Little3gy/VFD-Control-System/media/buck_assembled_PCB_3.jpg

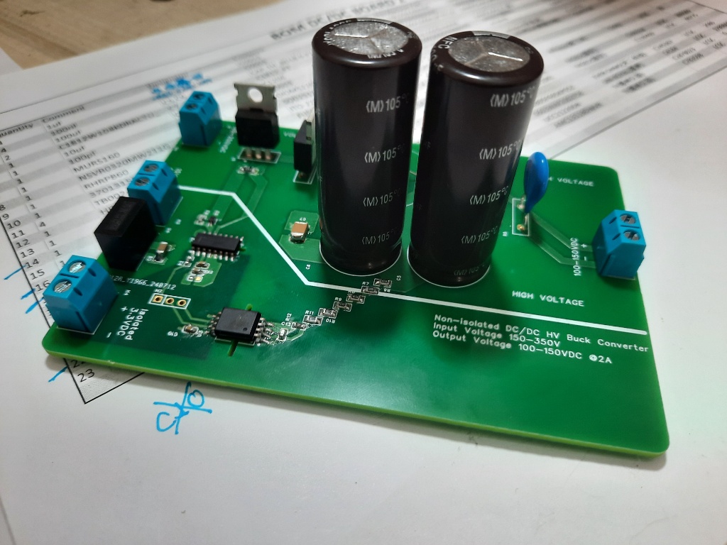
media/buck_assembled_PCB_3.jpg
