Little3gy/VFD-Control-System/media/AC-DC_converter_assembled_PCB.jpg

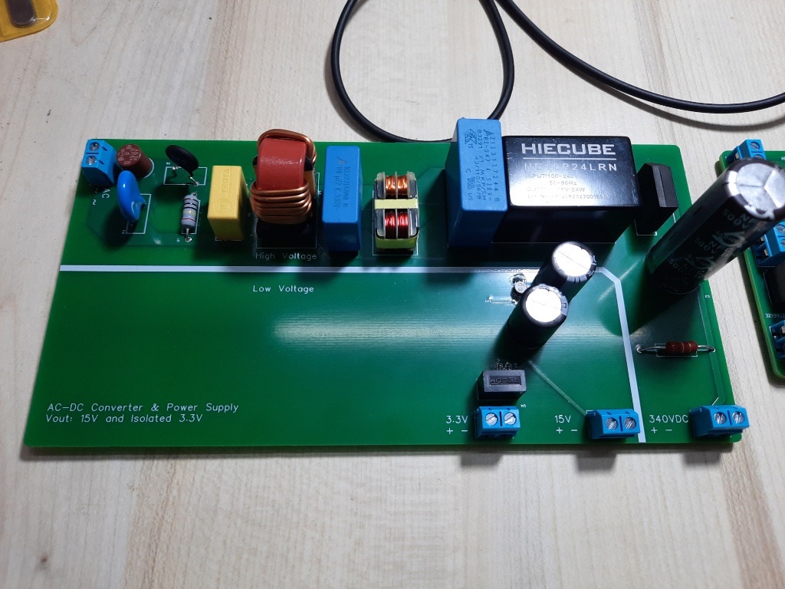
media/AC-DC_converter_assembled_PCB.jpg
