Little3gy/VFD-Control-System/docs/Documentation.docx

Documentation

Friday, 16 February 2024

13:59

Date | Tasks | Notes | summary

16/02/2024 14:06

Research:

Frequency Controller

F Control vs V Control

# Frequency Controller

  - F: cycles per sec
  - Transformer
  - Controlling the frequency, we control the rotational speed of the motor
  - Variable Frequency Drives Explained - VFD Basics IGBT inverter (https://www.youtube.com/watch?v=yEPe7RDtkgo&ab_channel=TheEngineeringMindset)

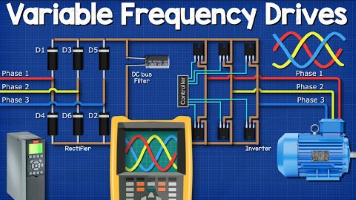
[picture p3: figure]

  - Advantages:
    - Energy Saving
    - Smoother control
  - It can be used to vary the frequency -> thus varying the speed of the motor

## VFD Structure

  - Rectifier: Diodes

In: AC

Output: Rough DC

Ripples, half waves

  - DC bus: Filter (Capacitor)

In: Ripples, rough DC

Out: Smooth DC voltage

  - Inverter: Switches (IGBT)

In: DC

Out: AC current

## How VFD work

  - Rectifier
    - 6 diodes,
    - The current can flow through one phase and return to the source though another; It can do this because the current flows forward and backwards at different points in time.

Current comes in though phase one and can only flow in one direction, which is through diode 1, then it passes through the load and (what does it do next?) It goes back to the source through diode 2. The reason is phase 2 is in its negative half. And so on…

  - Capacitor (storage tank)
    - Smooths the DC output via absorbing and injecting electrons
  - Inverter (DC to AC)
    - IGBT switches that can turn on and off via a PWM controller to generate the desired wave shape (voltage and frequency)

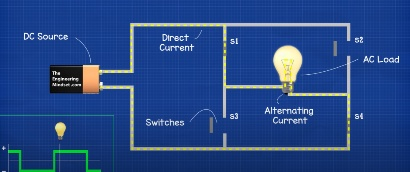
[picture p4: figure]

The direction of current going through some load can be reversed by opening and closing switches in the right order (AC current)

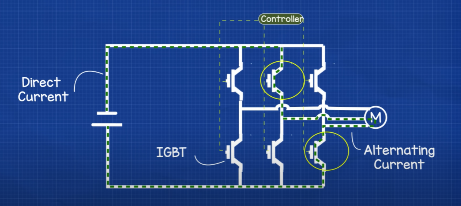
[picture p5: figure]

We can time the switches the generate the right form of wave.

For a 3 phase AC output, The inverter will have 6 switches and by controlling the order and timing,

Closing switches 1 and 6 will direct the current to flow through phase one (postive) and phase two (negative), then opening switch 2 and closing switch 2 will direct the current to go through phase one and phase 3 …

Frequency control

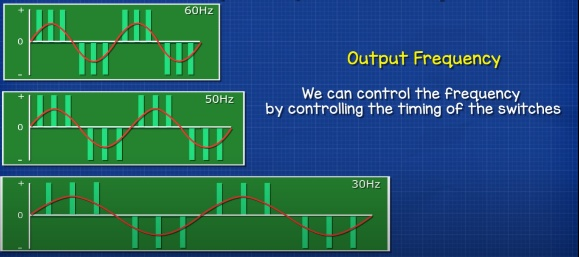
[picture p6: figure]

Voltage control

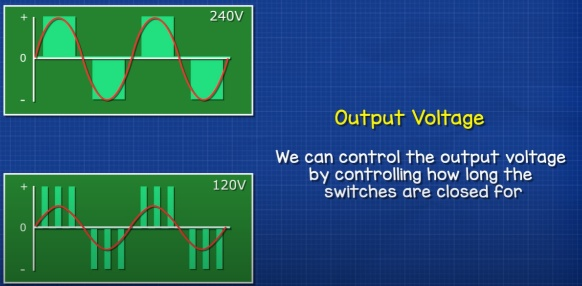
[picture p7: figure]

The output voltage can be controlled

The frequency can also be controlled

# Notes

  - Once you have DC voltage, you can do anything you want with it; Change the voltage, amplitude, frequency

Voltage / Frequency (https://www.youtube.com/watch?v=JzOCCEGe9jU&ab_channel=Chris%27sWorkbench)

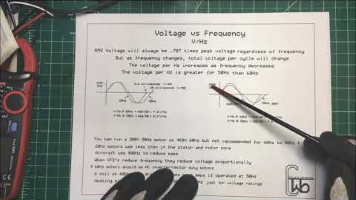
[picture p8: figure]

# Thyristor and Triac

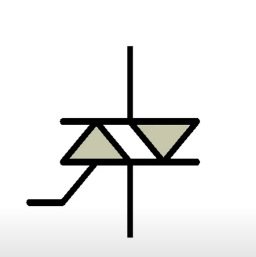
[picture p9: figure]

  - AC power
  - 3 terminals
    - G, MT1, MT2
  - Trigger through the gate, allows current to flow

Electronic Basics #20: Thyristor, Triac || Phase Angle Control (https://www.youtube.com/watch?v=4N1uLth1o9o&ab_channel=GreatScott%21)

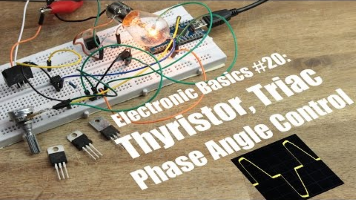
[picture p10: figure]

  - Latching current
  - Turn off time
  - V Drop
  - P lose
  - Zero point indicator
  - Full bridge rectifier with an Auto coupler, in order to create a voltage burst
  - This configuration gets used with feeding elements or to adust the speed of a universal motor
  - Constantly decreasing power factor due to the non-sinusoidal current

# Power factor

Power Factor Explained - The basics what is power factor pf (https://www.youtube.com/watch?v=Tv_7XWf96gg&ab_channel=TheEngineeringMindset)

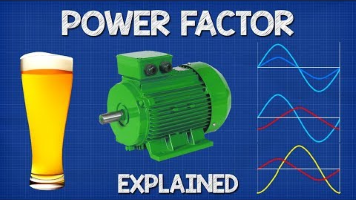
[picture p11: figure]

  - AC
  - Power factor = True power/ Apparent Power
  - KW KVA
  - Bad power factor of the customers
  - Perfect power factor
  - Good, poor, bad
  - KVar
  - Inductive load
  - Lagging power
  - Correcting powr factors, capacitors, inductors,
  - Transformer

17/02/2024 15:07

VFD for single phase

Voltage- frequency curve

VFD control

Electromagnetic vibration control

# VFD for single phase

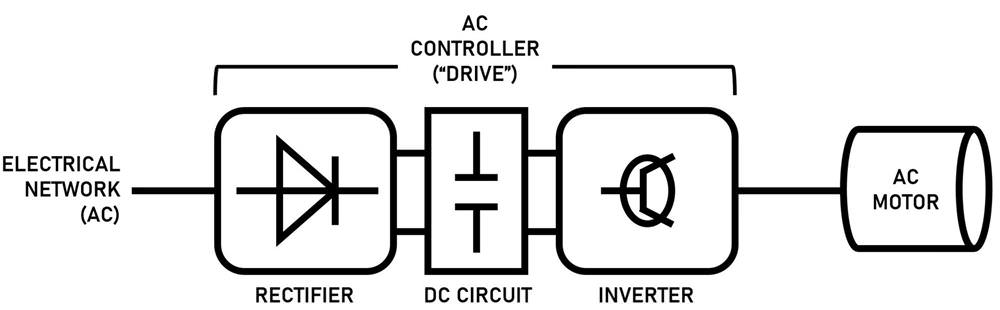
[picture p12: figure]
Inverter Diagram AC Motor Control

# Voltage-Frequency Curve

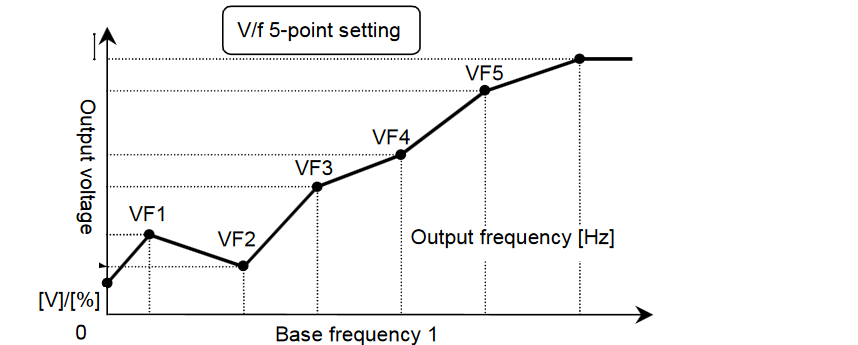
[picture p13: figure]

  - A graphical representation of the relationship between the voltage V and the frequency of the voltage.
  - Control the speed of an induction motor (and feeder).
  - The shape of the curve can be adjusted to suit the needs of the application; For applications that require high torque at low speeds, a steeper slope can be used. While a shallower slope may be used for applications that require high speed at low torque.
  - allows for precise control of the motor speed using a VFD and can help to improve the efficiency and reliability of systems.

# SCR (Silicon Control Rectifier)

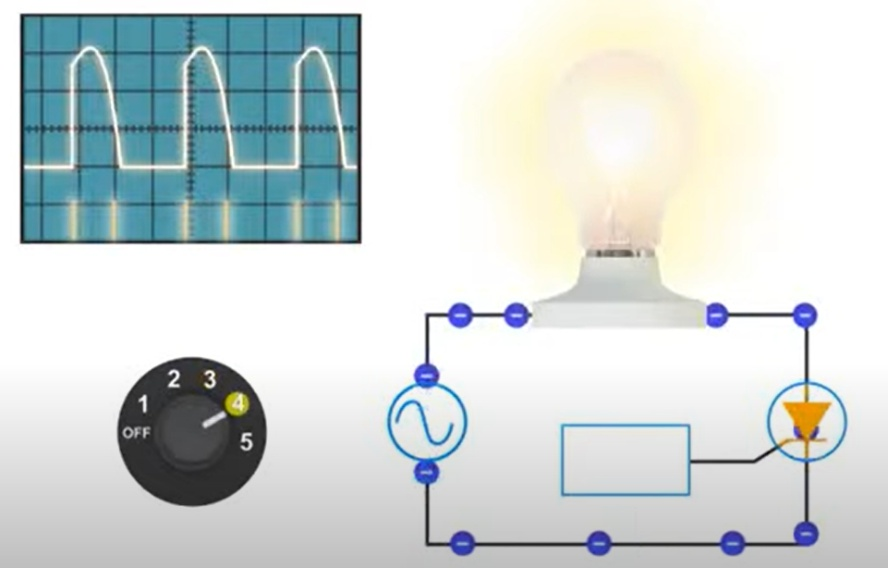
[picture p14: figure]

  - Control the current follow via the gate
  - Diode with Gate Control
  - Dimmer

# Vibrating Feed Control Circuit

Three types of REVF:

  - Sub-resonant mode
  - Resonant mode
  - Super-resonant mod
  - Triac, SRC, and other components were used
  - Generates triangle-shaped current pulses for the electromagnetic actuator.
  - Mechanical resonance
  - switching frequencies.
  - Triangle-shaped wave instead of a perfect siosoidal shape wave

# Triangle-shape wave vs Sinosoidal wave form

Efficiency:

Triangle pulses require lower switching frequency: Compared to sinusoidal pulses, which require high-frequency switching for accurate waveform generation, triangle pulses can be achieved with lower switching frequencies. This reduces switching losses in the power converter, leading to higher overall efficiency.

2. Implementation simplicity:

Easier control and generation: Generating triangle pulses is simpler than generating precise sinusoidal waveforms, especially with lower-cost microcontrollers or control systems. This reduces circuit complexity and potentially lowers component costs.

While sinusoidal pulses might theoretically offer smoother operation and potentially lower vibration noise, the trade-off in efficiency and implementation complexity often makes triangle pulses a more practical choice for industrial applications like REVFs.

Here are some additional points to consider:

The paper mentions that the specific control method employed (pulse width modulation with triangle current pulses) still allows for adjustments of both frequency and amplitude, achieving the desired control over the feeder's operation.

In some REVF applications, minimizing noise or achieving very specific vibration patterns might be crucial, and sinusoidal pulses could be preferred despite the efficiency drawbacks. However, for many industrial feeding tasks, the efficiency gains and implementation simplicity of triangle pulses outweigh the potential benefits of sinusoidal waveforms.

### Applications

  - Used in charging a capacitor

Common ways of generating the output current other than Silicon-controlled rectifier (SCR) converters are:

  - Solid State Relay (SSR) converters: These use transistors or thyristors to switch the power to the heater, but they have a slower switching rate and a higher on/off effect than SCR converters1.
  - Phase Angle Control (PAC) converters: These use triacs or SCRs to vary the phase angle of the input voltage, which results in a smooth and continuous control of the output current2.
  - Pulse Width Modulation (PWM) converters: These use MOSFETs or IGBTs to switch the power to the heater with a high frequency, which results in a low on/off effect and a high efficiency3.

Each of these methods has its own advantages and disadvantages, depending on the application and the requirements of the system. For example, SSR converters are simple and inexpensive, but they have a high power loss and a low accuracy. PAC converters are accurate and reliable, but they generate harmonics and noise. PWM converters are efficient and flexible, but they require complex and expensive circuitry.

Resonance and driving frequency

# Resonance

Resonance in a vibratory feeder is achieved by designing the system such that the natural frequency of the system matches the driving frequency. Here are the key components involved in achieving resonance:

  1. Drive Unit: The drive unit, typically consisting of an electromagnetic coil and a spring system, produces the necessary vibrations to move the parts1 (https://www.generalkinematics.com/vibrating-feeders-for-stockpile-and-reclaim-gk-feeders/).
  2. Controller: The controller regulates the frequency and amplitude of the vibrations, allowing for precise control over the feeding process2 (https://www.rnaautomation.com/insight/designing-an-efficient-vibratory-bowl-feeder-a-comprehensive-guide/).
  3. Elastic Component: The design of the vibratory feeder with electromagnetic excitation is based on a system of two masses coupled by means of an elastic component consisting of flexible leaf composite springs3 (https://pdfs.semanticscholar.org/8547/52240f40e32d3039c60b8af6b6345a16d1e6.pdf). The quantity of leaf springs fitted up determines the resonant operation of the equipment3 (https://pdfs.semanticscholar.org/8547/52240f40e32d3039c60b8af6b6345a16d1e6.pdf).
  4. Tuning: Maximum feed rate can be “fixed” or set by adjusting the small eccentric weights located on the motor or vibrating shaft. Stroke can also be adjusted by the use of tuning springs to vary the resonance effect1 (https://www.generalkinematics.com/vibrating-feeders-for-stockpile-and-reclaim-gk-feeders/).

By carefully selecting and adjusting these components, the system can be made to vibrate at its natural frequency, which is the frequency at which the system tends to oscillate in the absence of any driving or damping force. When the driving frequency matches this natural frequency, resonance is achieved, leading to larger oscillations and more efficient operation of the vibratory feeder.

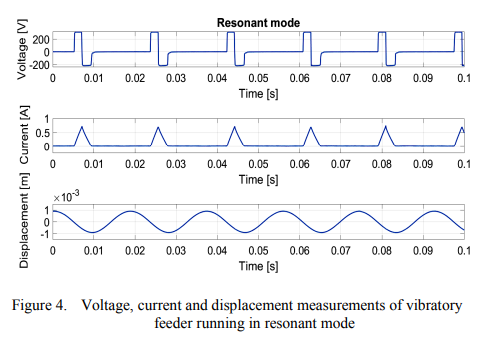
[picture p15: figure]

1. Operating the Electromagnetic Vibratory Feeder (EVF):

  - Operating the EVF at resonance has advantages but it can also be dangerous if not properly controlled.

2. Changing the Speed of the Tray:

  - In an early version, the speed of the tray was changed by increasing the voltage. This means increasing the amplitude of the frequency; the displacement of the armature, without changing the frequency.

3. Efficiency of the System:

  - High current of the electromagnetic coil of the feeder represents a non-efficient system.

4. Achieving Resonance:

  - To achieve resonance, the current pulse was synchronized with the natural frequency of the mechanical system. This resulted in minimal energy consumption and maximum vibration amplitude

The EVF controller has to permit frequency control because it should operate at resonance.

23/02/2024

Circuit analysis:

How to build EVF control circuit?

Why does a square wave can be smoothed out into a triangular wave?

The power converter consists of three power converter:

1. Front end high frequency AC/DC converter with power factor correction (PFC) control, The PFC is not required for the first prototype
2. DC/DC link converter with high frequency duty-cycle control (step-down i.e. “buck” converter) This is an essential step for the project

Active Power Factor Correction (https://www.youtube.com/watch?v=rWfGlo4szyU&ab_channel=MATLAB)

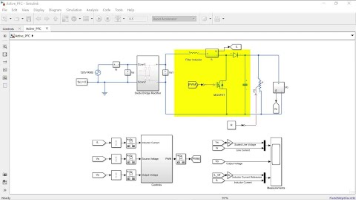
[picture p16: figure]

1. Low frequency IGBT converter with triangle pulsating output current [25] Control is here

# PFC rectifier

Power Factor Correction | Active Power Factor Correction | PFC Control | Boost PFC (https://www.youtube.com/watch?v=KVZVGHwp7B0&ab_channel=FoolishEngineer)

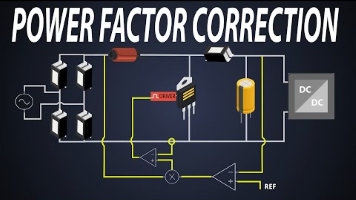
[picture p17: figure]
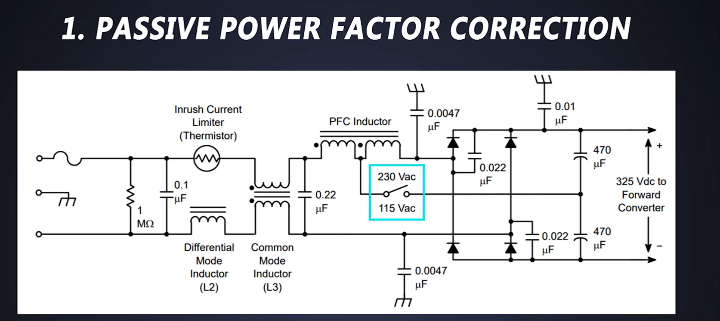
[picture p18: figure]

Power Factor Correction (PFC) – Critical Condu1ction Mode

1. Shaping the Input Current: A PFC rectifier intentionally shapes the input current to be in phase with the instantaneous line voltage
2. Reducing Harmonics
3. Efficiency and Size: The use of PFC allows the manufacturer of electrical load to use smaller components
4. Regulated Output Voltage: It offers a stable regulated output voltage

Why do we need PFC rectifier:

1. current becomes more stable
- Different classes of loads
- Class D is for small Power consumption
- 2 PFC
  - Passive
    - Inefficient
  - Active
    - More common
    - Boost
    - 2 techniques
      - Continuous conduction mode
      - Critical conduction mode -> for low loads

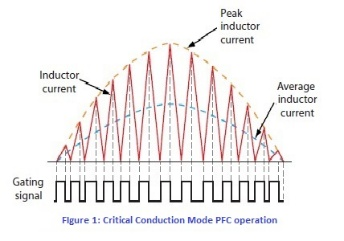
[picture p19: figure]
Power Factor Correction (PFC) – Critical Conduction Mode Boost Converter Calculations using L6562 - Power Electronics Talks

- Even though there might be no phase shift, we can still have low power factor.

# DC/DC link - capacitors

A closer look at the DC Link (https_chargedevs.com)

- Junction between two power conversion
- It also smooths the pulses out into more of a triangle or sawtooth shape
- Electrolytic capacitor
- How to Smooth a Rectified Waveform Using Capacitors (https://www.youtube.com/watch?v=hEXQXvPH8EI&ab_channel=JoeRobinsonTraining)

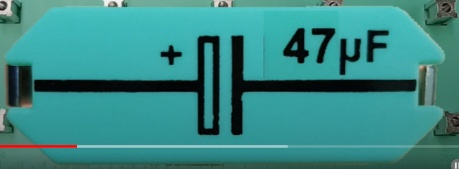
[picture p20: figure]

- larger values of capacitors can produce smoother filtering

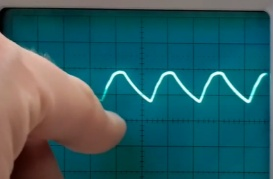
[picture p21: figure]
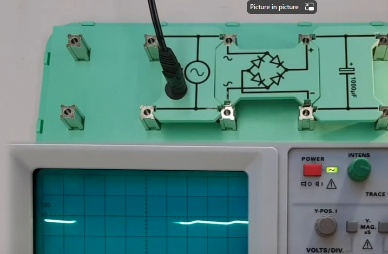
[picture p22: figure]

- The biggest capacitor gave an even smoother wave (when we say the biggest, do we mean the in size or in capacitance?)
- Bigger capacitor also results in a brighter lamp
- Capacitor is similar to a water storage tank
- Capacitors Explained - The basics how capacitors work working principle (https://www.youtube.com/watch?v=X4EUwTwZ110&ab_channel=TheEngineeringMindset)

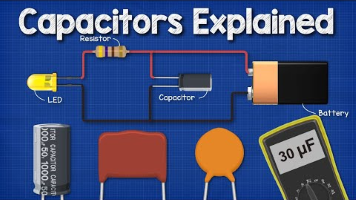
[picture p23: figure]

- Voltage difference is the difference between the pressure of two points

When do we use capacitors? lol

- Power factor correction
- Rectifiers

If we have a square wave voltage input, what would be our current, is it a square wave as well? - Quora (https://www.quora.com/If-we-have-a-square-wave-voltage-input-what-would-be-our-current-is-it-a-square-wave-as-well)

- If we have a square wave voltage input, what would our current output look like, A square wave too?
  - What would the current look like if it's pure resistance?

It follows the shape of the input

- What would it look like if it's pure induction?
  - Triangle
- What would it look like if it's pure capacitance? Infinite for a fraction of a second then zero afterwards
- The capacitor has to have a voltage rating greater than the power source

# Opto-isolated

- Aka Optocoupler
- Used with MCU for protection
- Protects from voltage spikes

28/02/2024

How build a rectifier

What safe volage to work with

What values of components to choose

What load

How build a Buck Converters

How build a Boost Converter

How build a Flyback converter

How build a Combines boost and buck converters

Low frequency IGBT converters

How2Power.com - Answering Your Questions About Power Design: : Electronics Design Services : Voltage Regulator : Industrial Power Supplies : Semiconductors : Transformer : IGBT Module : Software : Digital Power Supply DC (https://www.how2power.com/pdf_view.php)

How To Choose The Right Rectifier & Capacitor For Rectifing AC to DC (https://www.youtube.com/watch?v=CAYKno16weE&ab_channel=Schematix)

What Resistor Do I Need For an LED | DigiKey Electronics (https://www.digikey.com/en/blog/atm-how-to-select-a-resistor-for-an-led)

Power-supply filtering

- Ripples
- Ripple factor
- Capacitors
- Diodes

Forward continuous current

Repetitive current

Reverse current

How To Choose The Right Rectifier & Capacitor For Rectifing AC to DC (https://www.youtube.com/watch?v=CAYKno16weE&ab_channel=Schematix)

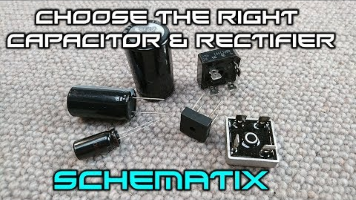
[picture p24: figure]

# The right Diode

- We need to look at the
  - reverse voltage Vrms
- 20%-30% headroom recommended
- Voltage drop: less power at the output
- Calculate the heat dissipation through a diode

# The Right Capacitor

- We need to look at:

Voltage: The voltage cannot > the power source

- 20-30% headroom recommended

Capacitance:

Based on:

- the current we are going to be drawing from the power source
- The frequency
- The acceptable voltage drop

Ex. Assuming 50Hz AC => half cycle time = (1/50)/2=0.01

- Capacitance: High-frequency applications call for smaller capacitance values, whereas energy storage and filtering applications benefit from larger capacitance values.
- Voltage rating (volts): Higher voltage rating.
- Most capacitors are polarity sensitive

The Right resistor with an LED using ohm's law

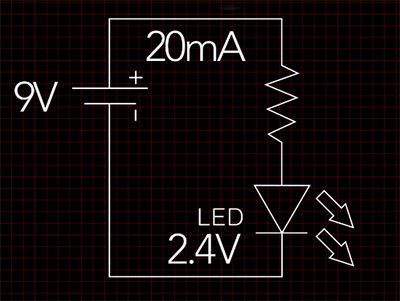
[picture p25: figure]

In this case V circuit is the led voltage. You should also account for other components.

# Active rectifier

The End of the Full Bridge Rectifier? (Sorry ElectroBOOM) Active Rectifier is here! (https://www.youtube.com/watch?v=S0j4xOuRzD4&ab_channel=GreatScott%21)

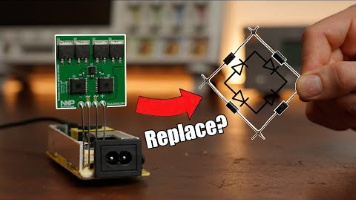
[picture p26: figure]

Full Wave Active Bridge Rectifier Controller

TEA2208T (https://www.nxp.com/products/power-management/ac-dc-solutions/ac-dc-controllers/full-wave-active-bridge-rectifier-controller:TEA2208T)

Tea2206

# Notes

- You can buy a rectifier
- Bleeder resistor: high value resistor in parallel with the load

Ee13 Ee16 Ee19 Electrical Powewr 230V 12V AC Flyback Transformer Manufacturer - China Flyback Transformer and Ee13 Ee16 Ee19 Transformer (made-in-china.com) (https://okerda.en.made-in-china.com/product/dOlfHBXSSRVD/China-Ee13-Ee16-Ee19-Electrical-Power-230V-12V-AC-Flyback-Transformer-Manufacturer.html)

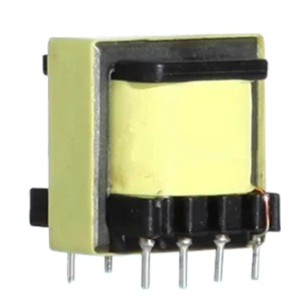
[picture p27: figure]

EEVBlog #1116 - How to Remove Power Supply Ripple (https://www.youtube.com/watch?v=wopmEyZKnYo)

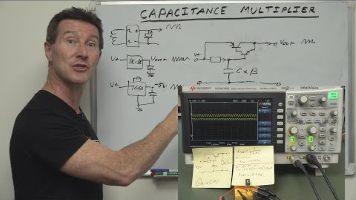
[picture p28: figure]

01/03/2024

How build a Buck Converters

Which is more efficient rectificaion then step dowm or the reverse

# Buck Converters

Basic Calculation of a Buck Converter's Power Stage (Rev. B) (https://www.ti.com/lit/an/slva477b/slva477b.pdf?ts=1709597991557)

Switching Buck Converter Component Sizing | Phil's Lab | Altium (https://resources.altium.com/p/buck-converter-component-sizing)

Is this the BEST Voltage Converter? Trying to build a Synchronous Converter! (https://www.youtube.com/watch?v=W4i2FRZ8gXc&ab_channel=GreatScott%21)

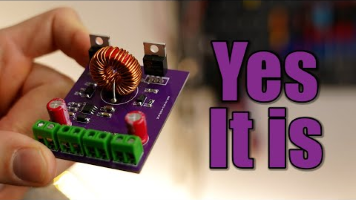
[picture p29: figure]

Half bridge driver ??

SMPS

High frequency XL6009 (https://pdf1.alldatasheet.com/datasheet-pdf/view/1132228/XLSEMI/XL6009.html) >>

- capacitor: smoothing
- Inductor: amp?
- Schokky diode
- Built in MOSFET
- Fixed frequency

# Voltage divider

Lm2576 KC Package

LM2576xx Series SIMPLE SWITCHER Power Converter 3-A Step-Down Voltage Regulator datasheet (Rev. G) (ti.com) (https://www.ti.com/lit/ds/symlink/lm2576.pdf?ts=1709519290029)

LM2576T-ADJG onsemi | Mouser Vietnam (https://www.mouser.vn/ProductDetail/onsemi/LM2576T-ADJG?qs=2OtswVQKCOHU65i1eWvgeQ%3D%3D)

# The Right MOSFET

- N type
- 10kohm pull down between source and gate to prevent accidental activation
- Linear region where the resistance is almost constant
- Source to ground

# MOSFET DRIVERS

LM2576xx Series SIMPLE SWITCHER Power Converter 3-A Step-Down Voltage Regulator datasheet (Rev. G) (ti.com) (https://www.ti.com/lit/ds/symlink/lm2576.pdf?ts=1709519290029)

IR2110 pdf, IR2110 Description, IR2110 Datasheet, IR2110 view ::: ALLDATASHEET ::: (https://pdf1.alldatasheet.com/datasheet-pdf/view/82793/IRF/IR2110.html)

IR2184 pdf, IR2184 Description, IR2184 Datasheet, IR2184 view ::: ALLDATASHEET ::: (https://pdf1.alldatasheet.com/datasheet-pdf/view/82795/IRF/IR2184.html)

*91045.pdf (vishay.com) (https://www.vishay.com/docs/91045/91045.pdf)

Why do we need a driver?

- Because the MOSFET has parasitic capacitance that require current to charge up. This currrent output exceeds the current of the microcontroller
- Current charges and discharges the gate during activation
- We need a powerful current source to charge up the gate faster, thus MOSFET ON

# Current Ripple

# Switching Regulators

- Converts input voltage into higher or lower voltage
- Inductors are used to store energy temporarity

How to Calculate and Design Buck Converter using MATLAB Simulink (https://www.youtube.com/watch?v=ZWs2HJZTWAA&ab_channel=MYCREATIVEENGINEERING)

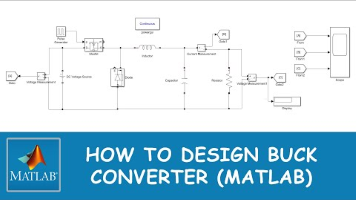
[picture p30: figure]
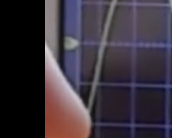
[picture p31: figure]

| Using Oscilloscope | Zero point Trigger button is there the oscilloscope starts measuring 50% button sets the trigger to 50% of the signal

PWM Generation

Using MOSFETs

# Creating a project

- Activate the pins
- Choose crystial

# Toggling an LED

HAL_GPIO_WritePin(GPIOC, GPIO_PIN_13, 1);

HAL_Delay(2000);

HAL_GPIO_WritePin(GPIOC, GPIO_PIN_13, 0);

HAL_Delay(2000);

# Generating PWM

PWM (Pulse Width Modulation) in STM32 (controllerstech.com) (https://controllerstech.com/pwm-in-stm32/)

1. Activate timer and configure clock speed
2. set the PWM Frequency and duty cycle using the following formulas

1. Set prescaler

Ex. 100 MHz → 100 kHz

2. Set ARR Value =

Ex. Desired PWM = 100KHz, Timer Frequency = 1MHz

-> ARR = 20-1

3. Choose duty cycle

TIM1->CCR1 = 30;

HAL_TIM_PWM_Start(&htim1, TIM_CHANNEL_1);

# STM32 Blue Pill Note

Solved: Did I "brick" my "blue pill" board(s) - ST-LINK V2... - STMicroelectronics Community (https://community.st.com/t5/stm32-mcus-products/did-i-quot-brick-quot-my-quot-blue-pill-quot-board-s-st-link-v2/td-p/72470)

The STM32 Blue Pill requires

1. Boot 0

# Notes

- Explore clock configuration

MOSFETs

Why a pull up resistor?

Electrical characteristics of MOSFETs (Static Characteristics IGSS/IDSS/V(BR)DSS/V(BR)DXS) | Toshiba Electronic Devices & Storage Corporation | Asia-English (semicon-storage.com) (https://toshiba.semicon-storage.com/ap-en/semiconductor/knowledge/faq/mosfet/electrical-characteristics-of-mosfets_static-characteristics_igss_idss_v-br-dss-v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)

MOSFETs Parameters:

- P type and N type
- Source to gate capacitance
- Inter

Drive the gate with a 10v to drive it fully on

# P Channel MOSFETs

- Activates when Negative Voltage applied to the gate relative to the source
- In this type of MOSFETs, the source is connected to VCC, The drain is connected to the ground, To activate it (-) voltage needs to applied to gate relative to the source
- So the voltage applied to the gate needs to be negative compared to the source
- In the case where the mosfet is closer to the load than the ground, the negative voltage applied to the gate has to be negative enough because the mosfet is close to Vcc, so it's already experiencing so the activation voltage is low

Mosfets, Enhancement-Type require a certain voltage value to activate.

- (relative to the Ground)

P-Channel MOSFET and Arduino. Switching a 12V Motor. - Circuit Journal (https://circuitjournal.com/how-to-use-a-p-channel-mosfet-with-an-arduino)

To activate the MOSFET with a U, the if

Type P: High output turns the mosfet OFF

Type N: Low output turns the mosfet OFF

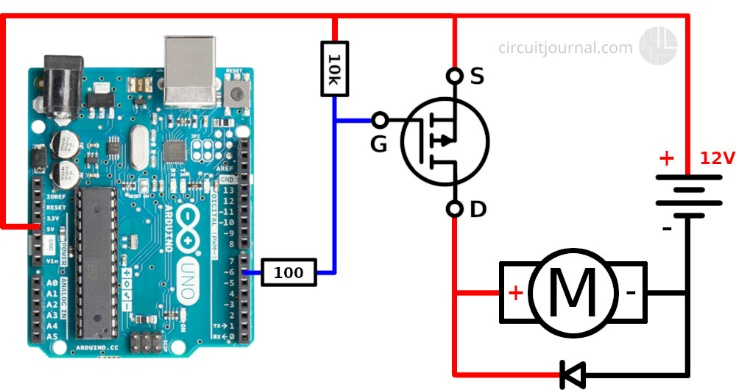
[picture p32: figure]
P-Channel MOSFET connection diagram. Connected on the VCC side.
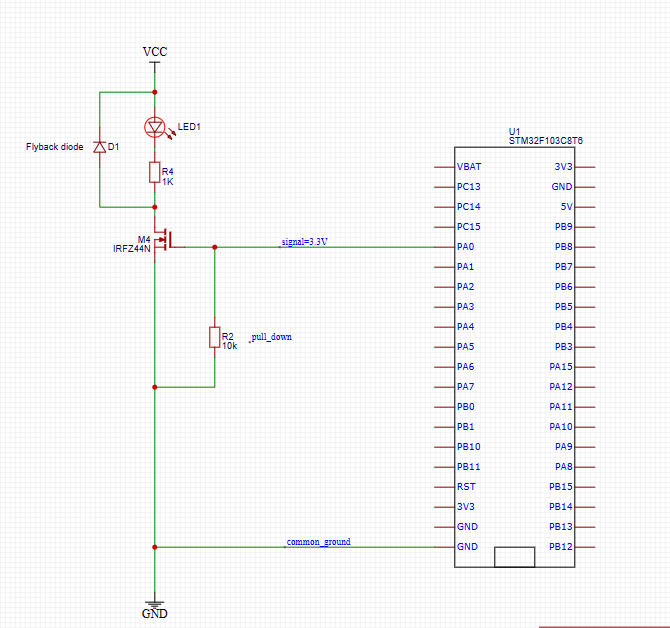
[picture p33: figure]

LOGIC LEVEL GATE DRIVE

The selected mosfet

Important convepts

- TYPE
  - LOGIC MOSFETS VS no-logic mosfets vs insulated

IRFZ44N VS IRLZ44N vs IRLI244N

P channel have higher resistance than N channel

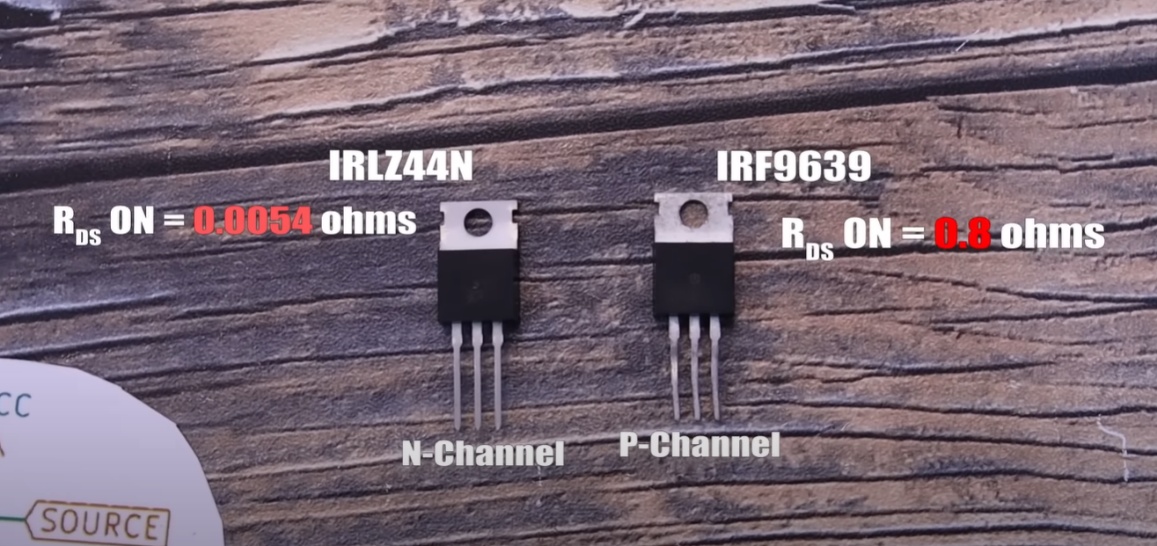
[picture p34: figure]

- DRIVER
- LOGIC LEVEL
- POWER DISSIPATION
- BOOTSTAP

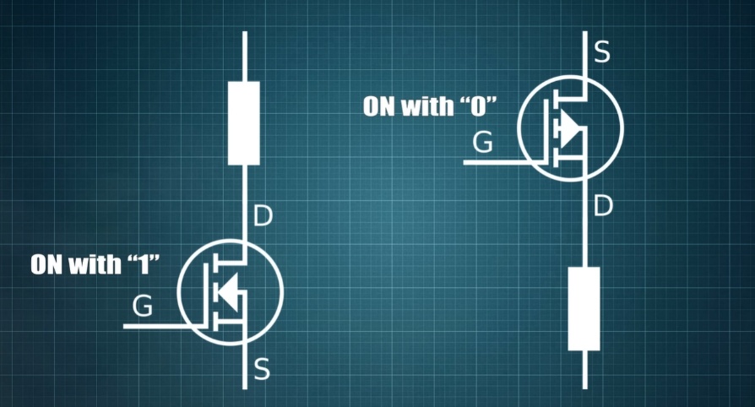
[picture p35: figure]

# Mistakes

- Capacitor polarity x2

11/03/2024

Week 5 probation

20 days left

How does bootsrapping work?

How to implement it?

What are it's parameters?

Bootstrapping

Half bridge

H bridge driving for generating a sine wave

How to determine the values of the components?

If my signal is 3.3V will ir2110 work properly?

MOSFET Bootstrapping (https://www.youtube.com/watch?v=zcQV_ZpK1W8&ab_channel=0033mer)

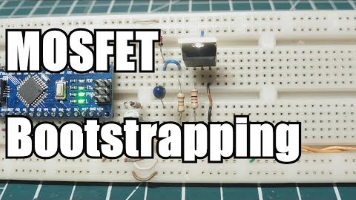
[picture p36: figure]

EasyEDA(Standard) - A Simple and Powerful Electronic Circuit Design Tool (https://easyeda.com/editor)

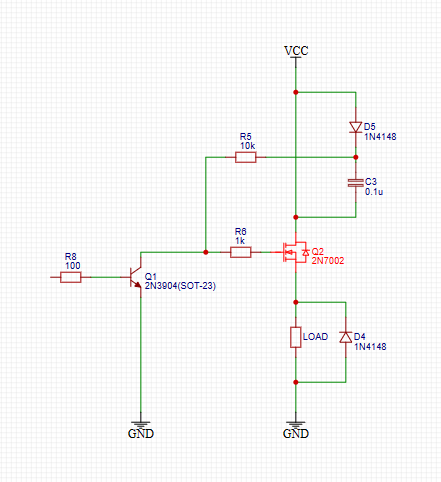
[picture p37: figure]
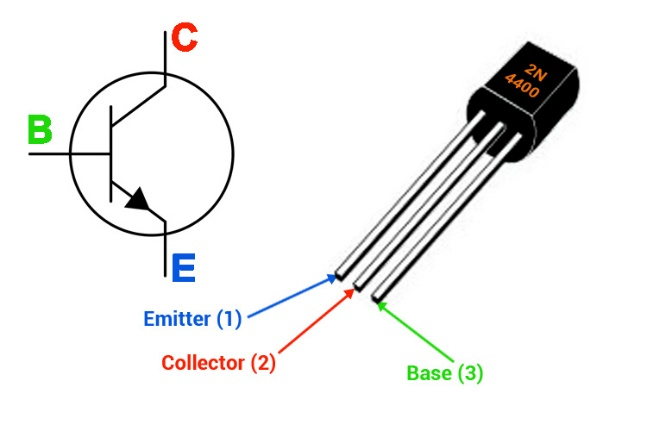
[picture p38: figure]
2N4400 Transistor Pinout, Datasheet, Equivalent, Circuit, and Specs

Is it safe to connect VCC and GND of the controller to the driver VCC?

How to use MOSFET/IGBT DRIVER IR2110 (https_microcontrollerslab.com)

  - IR2110 can drive both low side and high side in half bridge and low bridge circuits

Miller effect

Many Driver configurations. Most common is totem pole output; low input impedance and high drive current

TOTEM POLE OUTPUT USE AND APPLICATIONS (http://microcontrollerslab.com/totem-pole-tutorial/)

Floating circuit to drive high side MOSFET. H-bridge used to in pure sine wave inverter

IR2110 can be used to generate a pure sinewave

  - Can drive up to 500V (offset voltage)
  - 2 A of current
  - Floating point

### What's offset voltage?

Pinout

LO | Output pin for a low side gate driver
2 | COM | return path for low side configuration
3 | VCC | power supply pin for low side
5 | VS | floating-point return path for high side drive
6 | VB | floating supply for high side drive
7 | HO | output signal for high side mosfet
9 | VDD | Power supply +5V
10 | HIN | PWM signal input for high side
11 | SD | shutdown pin to turn off system automatically
12 | LIN | PWM signal input for low side
13 | VSS | Power supply ground

  - VDD pin 9 is a logical supply pin. Its value should be around 5 volts. But if you used voltage less than 4 volts it may not give you the required result.

Schematic of an

ir2110 typical circuit - Search Images (bing.com) (https://www.bing.com/images/search?view=detailV2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)

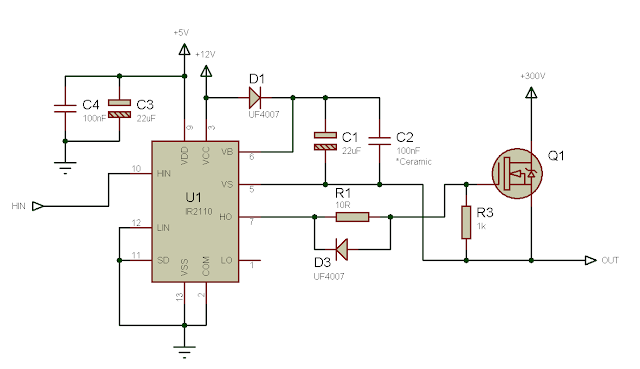
[picture p39: figure]

# Notes

Selection of bootstrap components

*an978.p65 (mit.edu) (https://web.mit.edu/6.131/www/document/float_drive.pdf)

*dt98-2.pdf (irf.com) (https://www.irf.com/technical-info/designtp/dt98-2.pdf)

Simulation Result

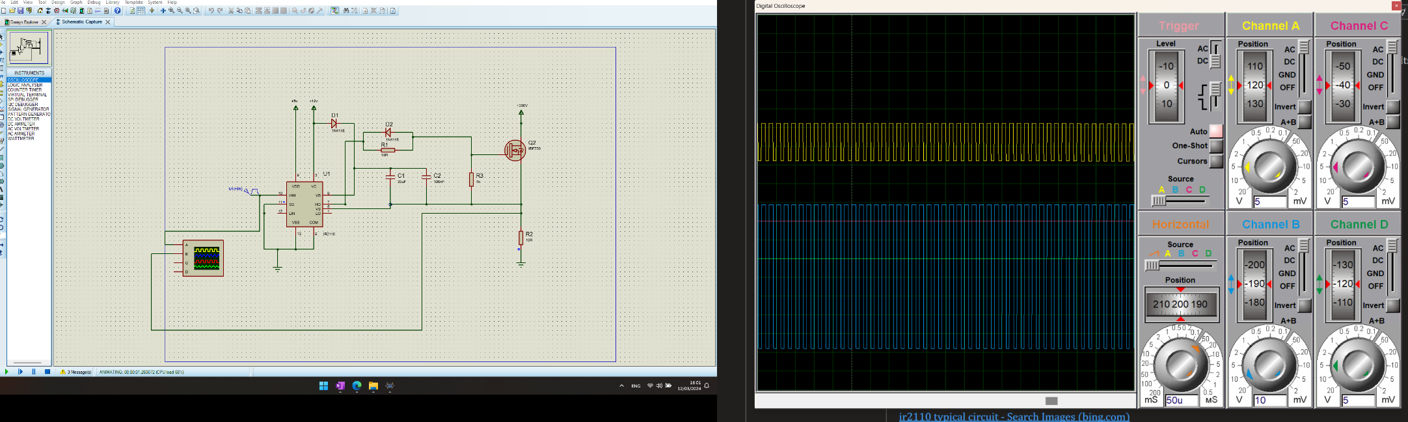
[picture p40: figure]

The amplifier npn mosfet doesn't work properly for a mysterious reason.

There's current flowing through it even without applying current to the base/

# Using a potentiameter to control pwm signal

while(dutyCycle < 65535) { TIM2->CCR1 = dutyCycle; dutyCycle += 100; HAL_Delay(1); } while(dutyCycle > 0) { TIM2->CCR1 = dutyCycle; dutyCycle -= 100; HAL_Delay(1); }

HAL_ADC_PollForConversion(&hadc1,1000);

readValue = HAL_ADC_GetValue(&hadc1);

TIM1->CCR1 = (int)(readValue*100/4095);

Potentiometer ADC (micropeta.com) (https://www.micropeta.com/video16)

STM32 Blue Pill Timer PWM Mode with LED Dimmer Example (microcontrollerslab.com) (https://microcontrollerslab.com/stm32-blue-pill-timer-pwm-mode-stm32cube-ide/)

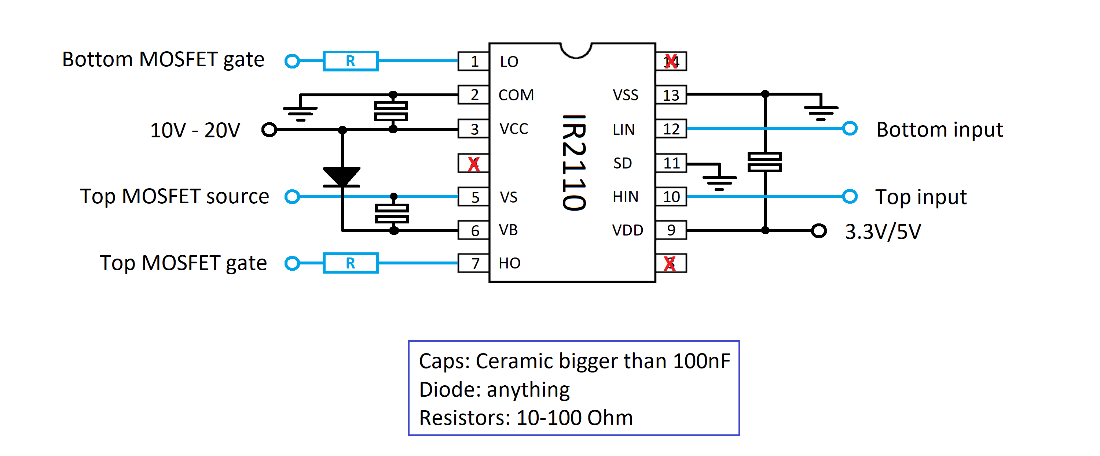
[picture p41: figure]

How to use the IR2110 gate driver – Krakkus.com (https://krakkus.com/2023/01/16/how-to-use-the-ir2110-mosfet-gate-driver/)

What are MOSFET gate drivers? Why do we need MOSFET gate driver? MOSFET driver explained. (https://www.youtube.com/watch?v=DXyTHhUjxjk&list=PLbGlpmZLQWJceSkQv96j-L4YyuxS-E0Wm&ab_channel=FoolishEngineer)

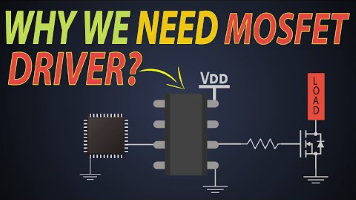
[picture p42: figure]

Why gate driver circuit?

  - Logic MOSFET driving a power MOSFET
  - A negative pulse to turn off a MOSFET

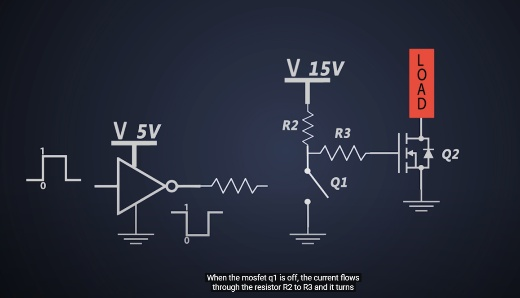
[picture p43: figure]

  - NOT at the GATE
  - Low switching speed, high switching loss
  - Inductance coupled with capacitance => Generate ringing, which could damage the gate driver

# Gate driver IC

  - No ringing
  - High gate capacitance
  - Low voltage compatibility
  - Transient protection
  - Isolation

# Resistor to drive the MOSFET

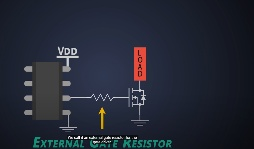
[picture p44: figure]

External gate resistors

## Why the right size of gate driver resistor is so important?

The gate resistors affect the following:

  - Swiching speed
  - Power dissipation
  - Power losses
  - Voltage Overshoot
  - Gate Ringing
  - Electromagnetic interference
  - Reverse recovery
  - Tradeoff between noise and efficiency
  - Resistor should be placed next the MOSFET gate

# Totem Pole

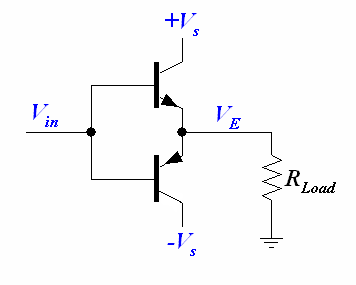
[picture p45: figure]
enter image description here

  - Requirements?

Floating circuit

Bootstrap

VCC and VDD

Totem Pole

H-bridge

# APPLICATION NOTE (https://web.mit.edu/6.131/www/document/float_drive.pdf)

Adjusting the signal so that it would reach the required gate voltage; When a driver IC is missing, the signal would need to be amplified using a transistor

# Floating Power Supply

In a floating Power supply the output is isolated from the input, including not sharing a common ground connection.

  1. Isolation
    - The output is not referenced to any ground or other power supplies
    - It allows the power supply to be used independently without relying on existing circuit ground connections.
  2. Application
    - Flexible grounding
    - Noise reduction

# VDD and VCC

  1. VCC: powers circuit
  2. VDD: powers logic gates, transistors and MOSFETs
  3. VCC is the power supply voltage of the circuit, VDD is the working voltage of the chip
  4. VSS is the ground point.

Some ICs have both VDD and VCC pins, which means that the device itself has a voltage conversion function.

# Gate Floating

The gate current is specifically related to controlling the MOSFET’s gate voltage, while the drain-source current is associated with its overall conduction behavior. 🛠️⚡

Floating the gate above the source

Input to high side MOSFETs has to be level shifter to whatever potential the tub is floating at

Floating the gate: gate voltage is controlled relative to the source volt at a given instance

# Driver Requirements

  1. Gate Reqirements:
    - Gate voltage must be 10-20 V above the source voltage
    - The gate voltage must exceed the rail voltage
    - Gate voltage must be referenced to ground which has to be referenced to GND
  2. Level shifting
    - The logic signal coming from the controller needs to be level shifted to the level of the source terminal of the HS switching transistor
    - In most applications, this source terminal swings between the two rails (high voltage and ground)

components operate at different levels

  5. For example, logic circuits (such as microcontrollers or digital ICs) typically work with low voltages (e.g., 3.3V or 5V), while power devices (such as MOSFETs or IGBTs) may operate at much higher voltages (e.g., 12V, 24V, or even hundreds of volts).

# Level Shifting

When we say that a signal is **"level-shifted,"** we are referring to the process of adjusting its voltage level or reference point. Let me explain further:

1. **Context**:

- In electronic circuits, different components or subsystems often operate at different voltage levels.

- For example, logic circuits (such as microcontrollers or digital ICs) typically work with low voltages (e.g., 3.3V or 5V), while power devices (such as MOSFETs or IGBTs) may operate at much higher voltages (e.g., 12V, 24V, or even hundreds of volts).

2. **High-Side Switching Example**:

- Consider a high-side power switch (like a MOSFET) that controls a load connected to a high voltage rail (e.g., a motor or a lamp).

- The gate voltage required to turn on the MOSFET must be higher than the source voltage (which is connected to the high voltage rail).

- However, the control signals from logic circuits are usually referenced to ground (0V).

3. **Level Shifting Process**:

- To make the control signals compatible with the high-side power device, we need to **shift their voltage level**.

- This involves adjusting the signal so that it reaches the required gate voltage relative to the source terminal of the power device.

- Common methods for level shifting include using **transistors, resistors, or specialized ICs** designed for this purpose.

4. **Example**:

- Suppose we have a microcontroller output that switches between 0V (logic low) and 3.3V (logic high).

- To drive a high-side MOSFET with a gate-source voltage of 12V, we need to level-shift the microcontroller signal.

- A simple level-shifting circuit might use a **voltage divider** or a **N-channel MOSFET** to achieve this.

# Bootstrapping

High-Side Gate Drive:

  6. In the context of MOSFET circuits, bootstrapping is commonly used to pull up the operating point of a transistor above the power supply rail.
  7. Specifically, it raises the gate voltage of an N-channel MOSFET or IGBT above the power rail supply (V+).
  8. By doing so, it ensures proper biasing and minimizes heat loss.

# Transition Threshold

  9. The level at which a digital signal switched between high and low or vice-versa.
  10. In some devices (such as MGDs, e.g., IRS211x), the transition threshold is proportional to the logic supply voltage (VDD).

# Bootstrap Capacitor

dt04-4.pdf (irf.com) (https://www.irf.com/technical-info/designtp/dt04-4.pdf) = IS TOO DETAILED FOR THE CURRENT STATE. This can be used in the phase 2 of the design

  12. The bootstrap supply is formed by a diode and a capacitor
  13. Proper capacitor choice can reduce drastically these limitations.
  14. To size the bootstrap capacitor,
    - the first step is to establish the minimum voltage drop (ΔVBS) that we have to guarantee when the high side IGBT is on.
      - If VGEmin is the minimum gate emitter voltage to maintain, the voltage drop must be:
  18. YOU WANNA KEEP IT ABOVE THE HIGH LIMIT FOR WORST CASE SENARIO
  19. There is an upper limit to the bootstrap capacitance set by the RC time constant of the bootstrap charging circuit and the minimum on time of the low-side transistor.
  22. N=1
  23. Q_g=

High-Side Drive, High-Side Solenoid Monitor With PWM Rejection (Rev. D) (https://www.ti.com/lit/ab/sboa166d/sboa166d.pdf?ts=1710916044618)

[FAQ] UCC27282: How to Correctly Size the Bootstrap Capacitor for Half-Bridge Gate Drivers - Power management forum - Power management - TI E2E support forums (https://e2e.ti.com/support/power-management-group/power-management/f/power-management-forum/1025054/faq-ucc27282-how-to-correctly-size-the-bootstrap-capacitor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)

Driving PWM Loads with TI High-Side Switches (https://www.ti.com/lit/an/slvaf10/slvaf10.pdf?ts=1710915995953)

AN296235-Driving-Inductive-Loads.pdf

*dt04-4.pdf (irf.com) (https://www.irf.com/technical-info/designtp/dt04-4.pdf)

*dt98-2.pdf (irf.com) (https://www.irf.com/technical-info/designtp/dt98-2.pdf)

Fundamentals of MOSFET and IGBT Gate Driver Circuits (Replaces SLUP169) (Rev. A) (ti.com) (https://www.ti.com/lit/ml/slua618a/slua618a.pdf?ts=1624976704296)

# Half Bridge

  24. What is ground
  25. Deadtime between the activation between the two MOSFETs

# Driving HS switching MOSFET with varying duty cycles

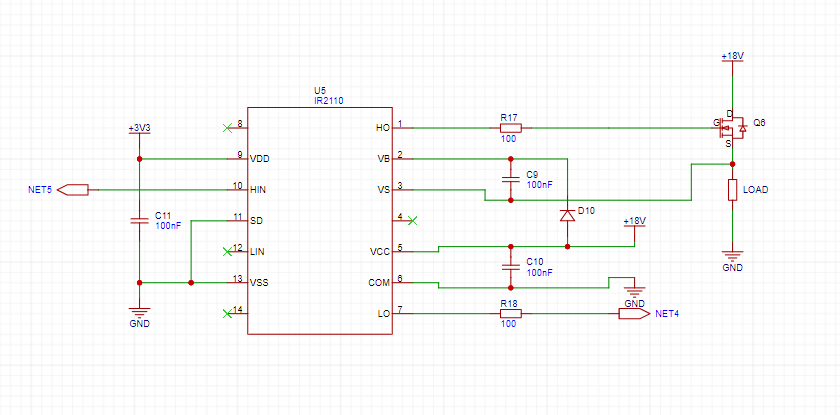
[picture p46: figure]
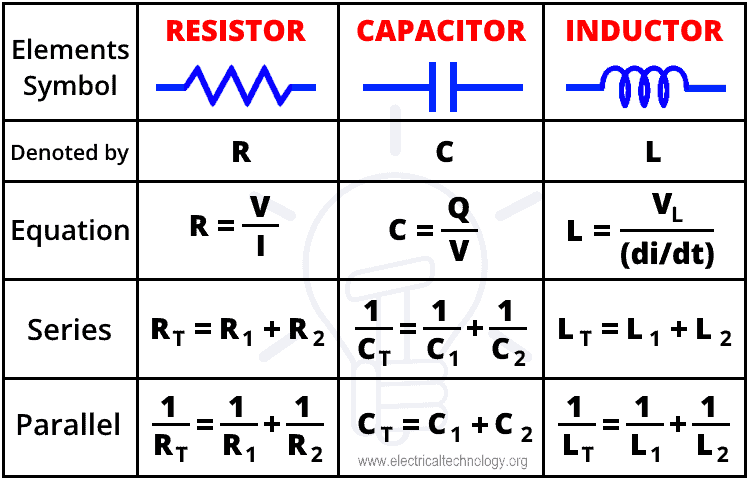
[picture p47: figure]
Resistor, Capacitor & Inductor in Series-Parallel - Formulas

21/03/2024 | Buck Implementation | The implementatoin of buck has been sucessful. With efficiency of 75% This technique can also be used in place of a dedicated supply to power the PWM controller, as well as the IR2110 and other auxilliary circuits, if the output voltage of the buck converter is between 10 and 20V | VS pin wasn

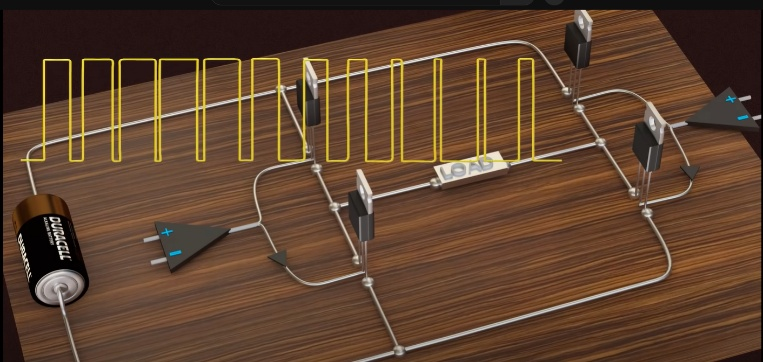
[picture p48: figure]

22/03/2024 | Power Inverter How do they work? How to build one? Important considerations | Power Inverters Explained - How do they work working principle IGBT (https://www.youtube.com/watch?v=iIqhAX0I7lI&ab_channel=TheEngineeringMindset) IGBT Across the load Close switch 1 & 4 Generating a sine wave 2 comparators for the 4 switches 1 comparator controls s1, s2 and the other controls s3,s4

27/03/2024

# Voltage divider

How to build

Control Algorithm

PWM can be used as a voltage divider. Does it divide the current drawn as well? - Using Arduino / General Electronics - Arduino Forum (https://forum.arduino.cc/t/pwm-can-be-used-as-a-voltage-divider-does-it-divide-the-current-drawn-as-well/648838/4)

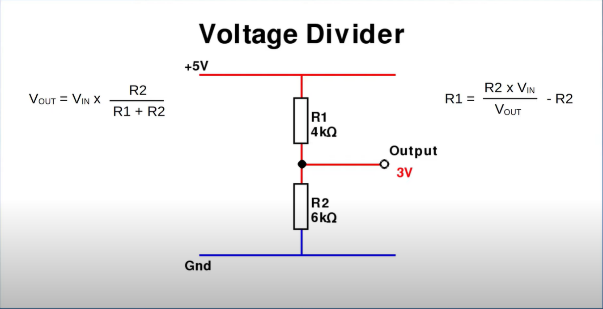
[picture p49: figure]

Motor behaves as a low pass filter

Put a 3A HRC fuse in the lead from the battery, physically located as close to the battery as possible with no other component between the battery and the fuse.

Current meter

Read the analog value

Voltage = readValue*3.3/resolution

V_in = Voltage*12/2

readValue = HAL_ADC_GetValue(&hadc1); // Store the ADC value in readValue

v_out = readValue * 3.3 / 4095; // Covvert the adc read value to volts

v_in = v_out * R_tot / R2;

error = v_ref - v_in; // Compute the error and convert to percentage

// Adjust the PWM duty cycle based on the error

if (error > 0) {

// Increase the duty cycle if the output voltage is too low

v_err += error * gain;

} else if (error < 0) {

// Decrease the duty cycle if the output voltage is too high

v_err += error * gain; // Gain is negative

}

// Make sure the duty cycle stays within valid bounds

duty += v_err * 100 / 18;

// Update the PWM signal with the new duty cycle

update_duty(duty);

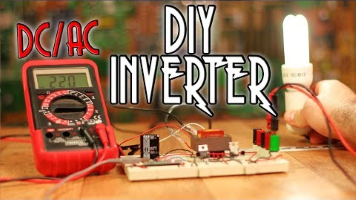
[picture p50: figure]
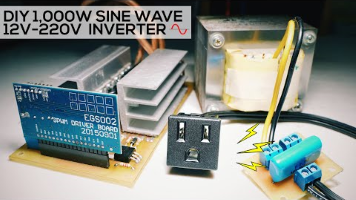
[picture p51: figure]

27/03/2024 | Inverter This is a big a deal | Alternative Solutions 1. Use 555 timer DIY Inverter tutorial - Arduino or 555 (https://www.youtube.com/watch?v=kMU8xiGCpd0&ab_channel=Electronoobs) 2. Use EGS002 DIY 1kW Sine Wave Inverter (12V-220V - EGS002) (https://www.youtube.com/watch?v=I8c5DLJgS3o&ab_channel=TechBuilder) EGS002-EG8010 Sine pulse generating circuit, voltage: 5VDC, output: 5V, frequency: 50Hz, 60Hz, 0-100Hz, 0-400Hz (thegioiic.com) (https://www.thegioiic.com/egs002-eg8010-mach-tao-xung-sin) 1. Mains voltages => 50 or 60 Hz 2. To step up voltages, you can use transformers in reverse 3. Diodes will be used around the mosfe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

# Inverter Concept

مقتطفات من الحلقة 61 من دورة التصميم الالكتروني المحترف - مبادئ عمل الانفيرتر (https://www.youtube.com/watch?v=Y341guLwOps&ab_channel=WalidIssa)

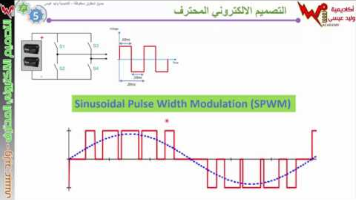
[picture p52: figure]

في المختبر:: 65- انفيرتر .... ولكن !! (https://www.youtube.com/watch?v=3KX3ttQV8rs&ab_channel=WalidIssa)

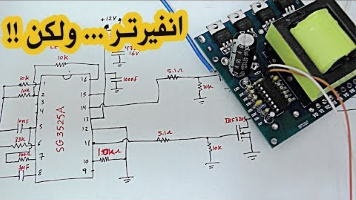
[picture p53: figure]

H bridge

  - Discharge a capacitor
  - SG3525A IC PWM Generator, with some capacitors, resistors we can adjust the frequency of oscillation and dead time of Mosfets
  - Resistors are placed before MOSFET gate to filter out any spikes.

DIY 1kW Sine Wave Inverter (12V-220V - EGS002) (https://www.youtube.com/watch?v=I8c5DLJgS3o&ab_channel=TechBuilder)

Gate Driver Circuit for Three Phase Inverter : 9 Steps - Instructables (https://www.instructables.com/Gate-Driver-Circuit-for-Three-Phase-Inverter/)

Micro-Cap Tutorial: MOSFET Inverter Three Phase (Motor Control) (https://www.youtube.com/watch?v=cy0IwzsDRY4&ab_channel=Micro-CapTutorials)

VFD Variable Frequency Drive Teardown Reverse Engineering | Electronics Materials and Quality Check (https://www.youtube.com/watch?v=KtJJe2gkUxA&ab_channel=DmitriIvanov)

How to make a Variable Frequency Drive (VFD) | 1: Overview & Basics (https://www.youtube.com/watch?v=XGlXLaUbKLw&ab_channel=MatanPazi)

Design Strategy for a 3-Phase Variable Frequency Drive (VFD) (calpoly.edu) (https://digitalcommons.calpoly.edu/cgi/viewcontent.cgi?article=1129&context=eesp)

Does it suck? Chinese DIY Pure Sine Wave Inverter || Sinusoidal PWM (SPWM) Tutorial (https://www.youtube.com/watch?v=Dn2PFebi2ww&ab_channel=GreatScott%21)

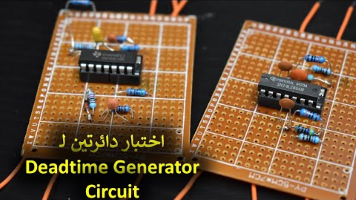
[picture p54: figure]
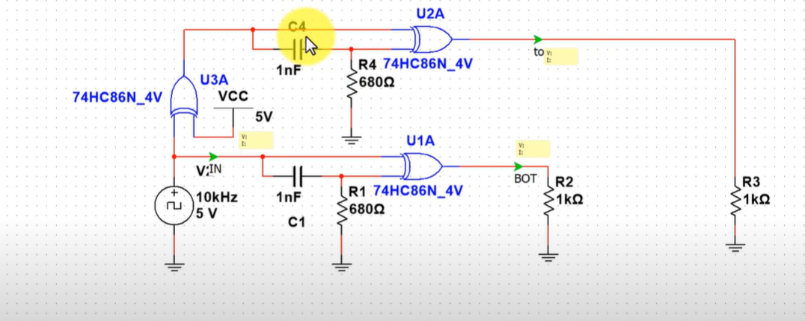
[picture p55: figure]
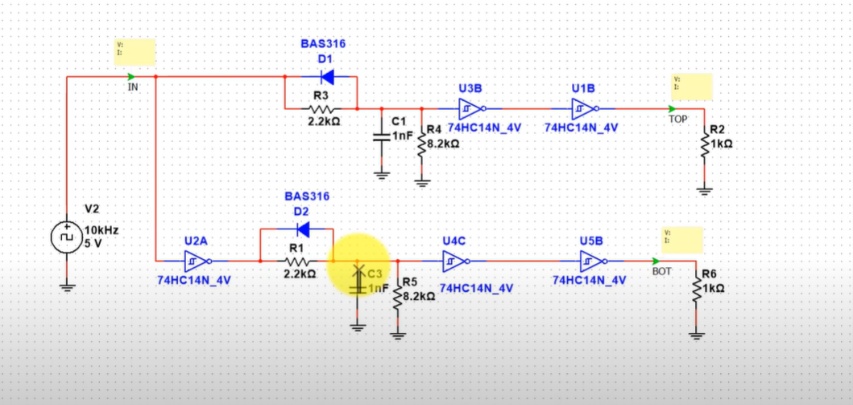
[picture p56: figure]

| Deadtime Generation Cicuit How to create deadtime? | في المختبر:: 168- ما هي (Deadtime Generator Circuit) وما أهميتها مع اختبار دائرتين (https://www.youtube.com/watch?v=ykdt-wX-X_c&ab_channel=WalidIssa) How to size the components? Experiment How to size the components? Experiment Every IC requires 100nF to prevent damage Modifying the values of R5, R7 could change the deadtime 1n1448 fast switching diode

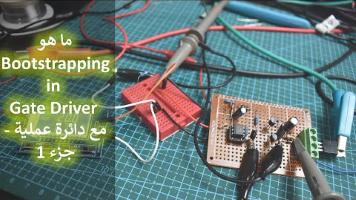
[picture p57: figure]

| Bootstrapping | في المختبر:: 171- ما هو Bootstrapping in Gate Driver مع دائرة عملية - جزء 1 (https://www.youtube.com/watch?v=munOQr4WECA&ab_channel=WalidIssa) What does a zinner diode do in such a circuit? TLP250 pdf, TLP250 Description, TLP250 Datasheet, TLP250 view ::: ALLDATASHEET ::: (https://pdf1.alldatasheet.com/datasheet-pdf/view/32418/TOSHIBA/TLP250.html) UCC2813 PMP20182 reference design | TI.com (https://www.ti.com/tool/PMP20182?ds_k=DYNAMIC+SEARCH+ADS&DCM=yes&gad_source=1&gclsrc=aw.ds) TL494 pdf, TL494 Description, TL494 Datasheet, TL494 view ::: ALLDATASHEET ::: (https://pdf1.alldatasheet.com/da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

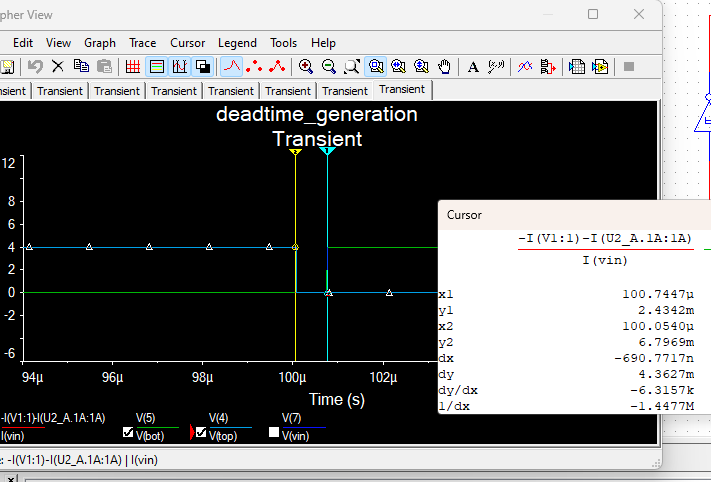
[picture p58: figure]
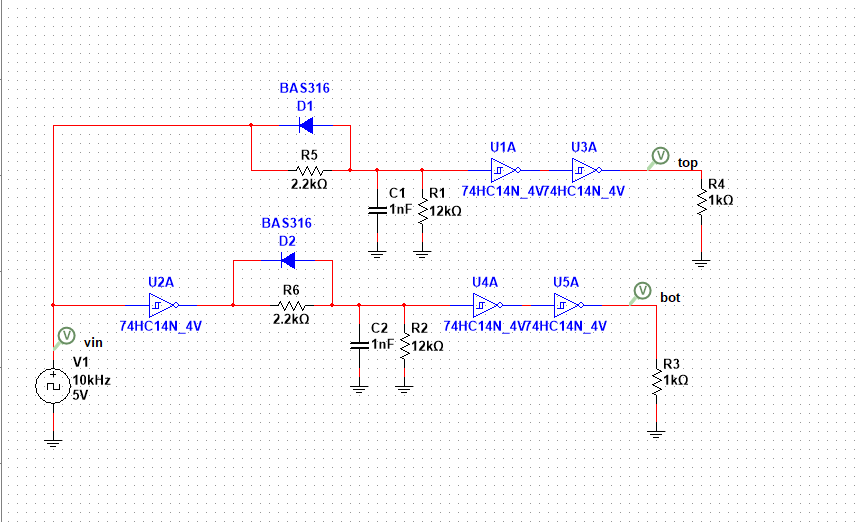
[picture p59: figure]
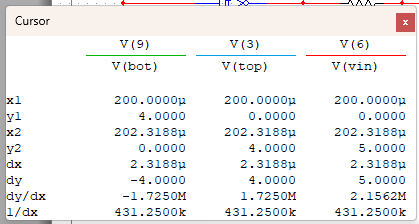
[picture p60: figure]
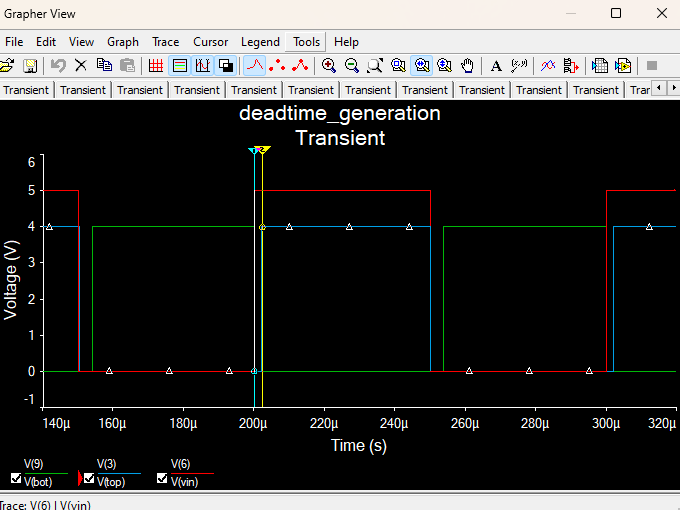
[picture p61: figure]

0‎5/ 04/ ‎2024 | Deadtime Simulation | H-bridge motor controller design using Nexperia discrete semiconductors and logic ICs (https://assets.nexperia.com/documents/technical-note/TN90002.pdf)
| Inverter Simulation | how to make H bridge using IR2110 (microcontrollerslab.com) (https://microcontrollerslab.com/how-to-make-h-bridge-using-ir2110/) EGS002.PDF how to make H bridge using IR2110 (microcontrollerslab.com) (https://microcontrollerslab.com/how-to-make-h-bridge-using-ir2110/)

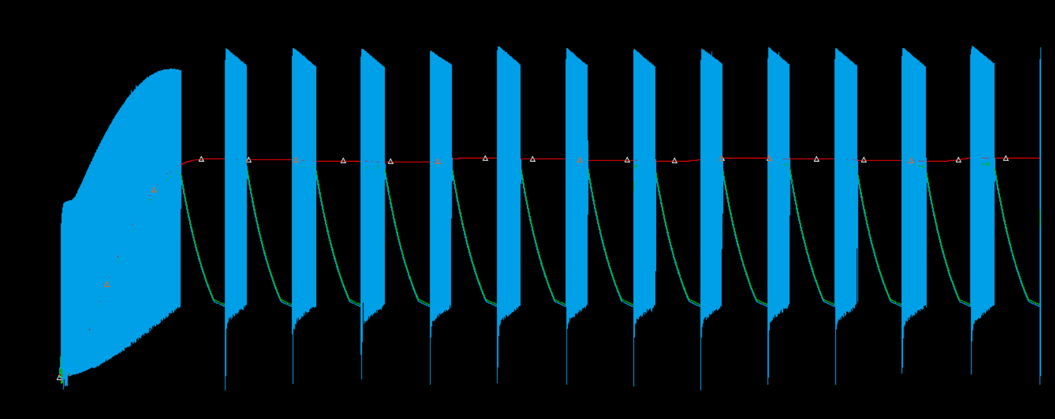
[picture p62: figure]
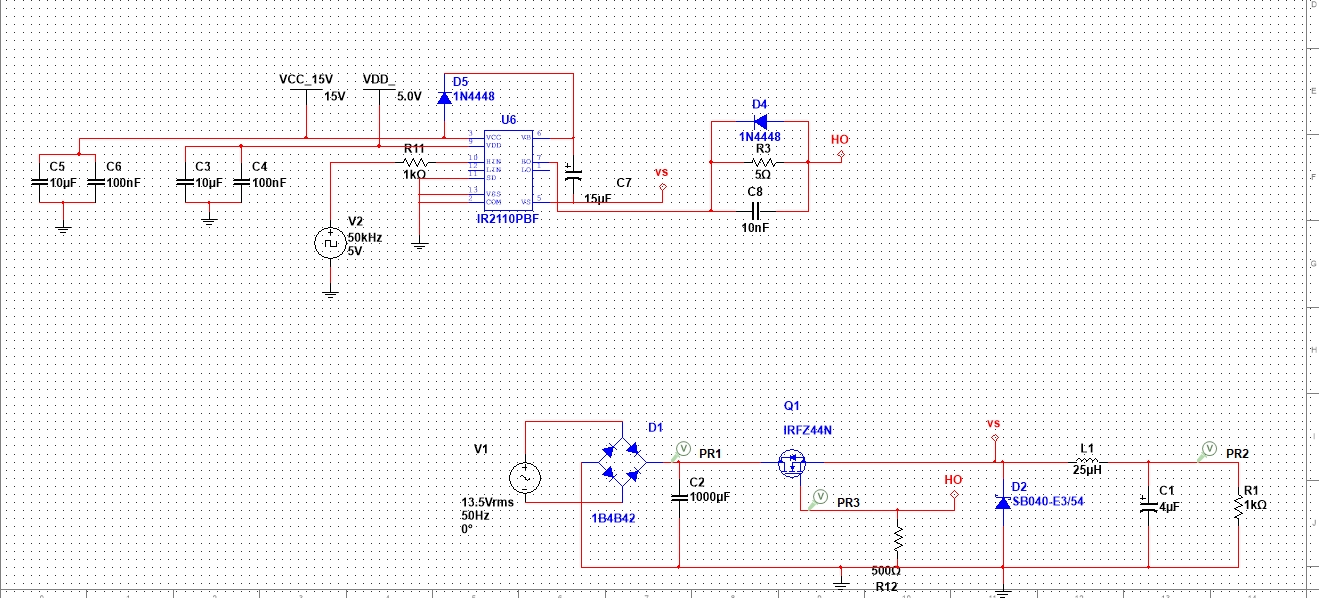
[picture p63: figure]
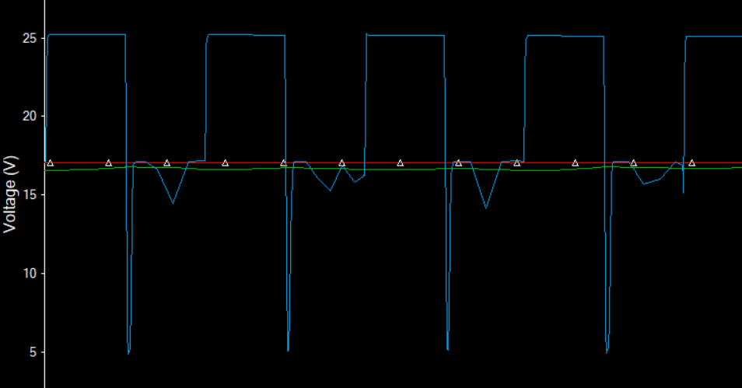
[picture p64: figure]

| Buck Simulation | The This is due to the bootstrap. The capacitor doesn’t have enough charge for the bootstrap to function normally. The gate voltage isn't driven to 0 during the

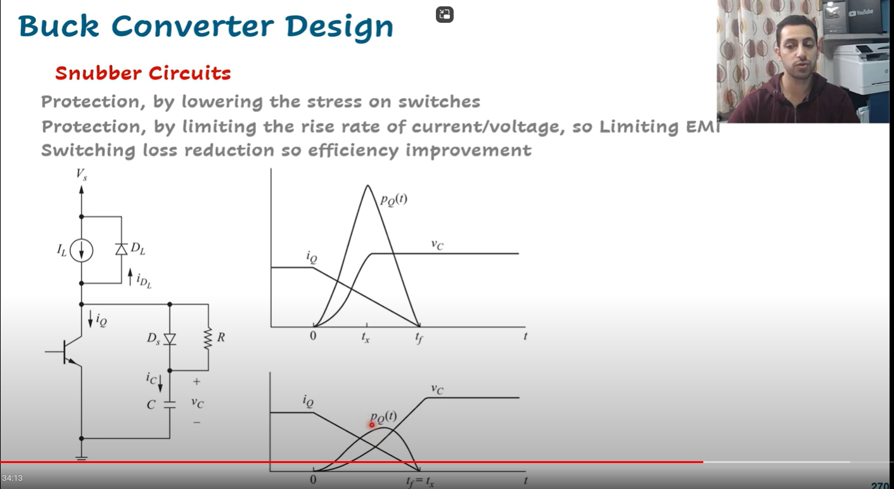
[picture p65: figure]
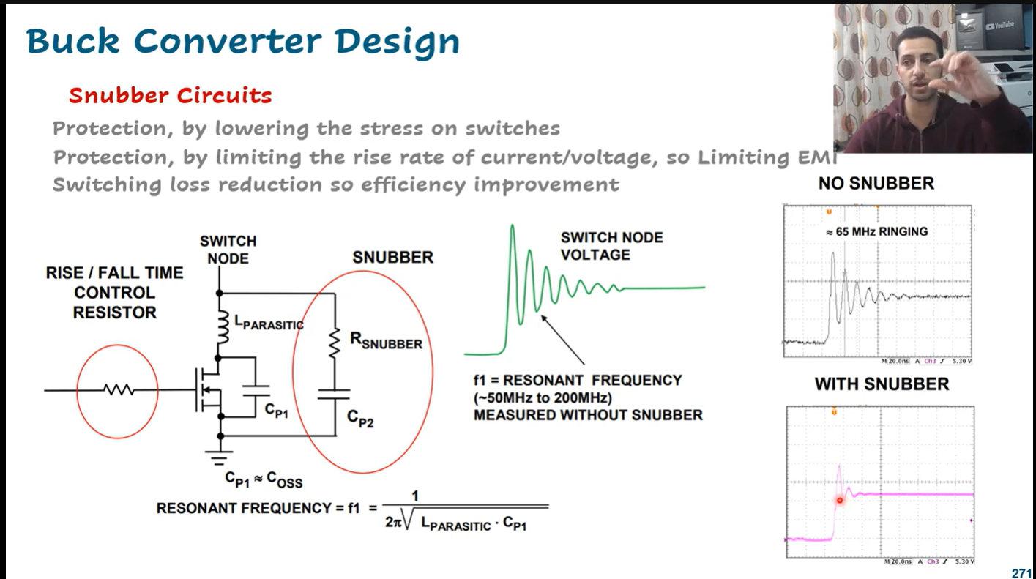
[picture p66: figure]
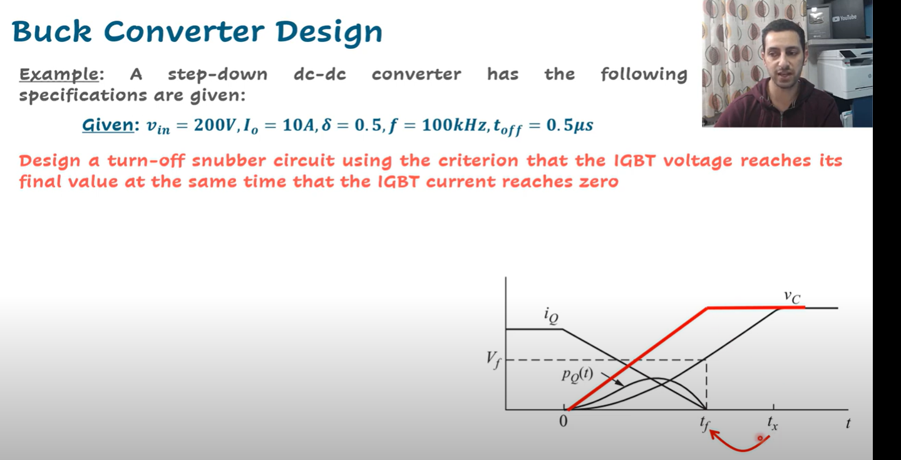
[picture p67: figure]

| | Inductive loads

Buck converter implementation

Fast recovery

Fast switching

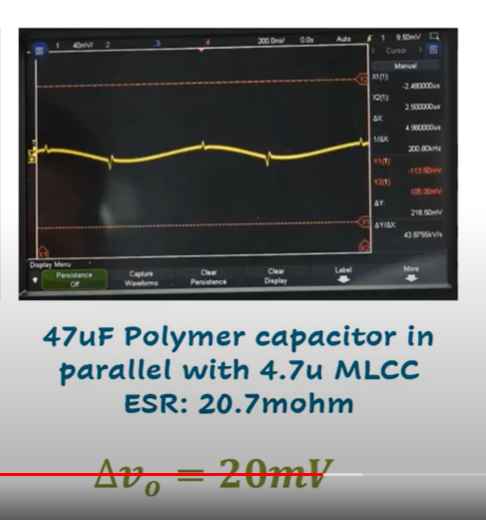
[picture p68: figure]
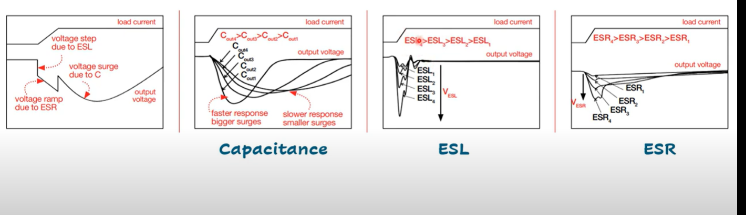
[picture p69: figure]

Lab 3 Buck Converter in LTSpice | Power Electronics (https://www.youtube.com/watch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)

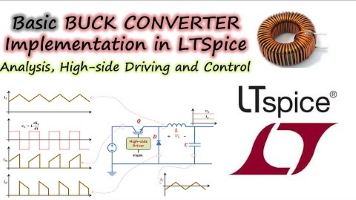
[picture p70: figure]

# Circuit analysis

Discontinuous Conduction Mode vs Continuous Conduction Mode

The relationship between the duty cycle and the output current should be linear =>

In this example the input voltage is 50 v and the duty is 50%, the output voltage is expected to 25v. However, we get 35v which is too high. The reason is because the system is operating in discontinuous conductive mode which is means that our system is no longer linear. As demonstrated in the below example

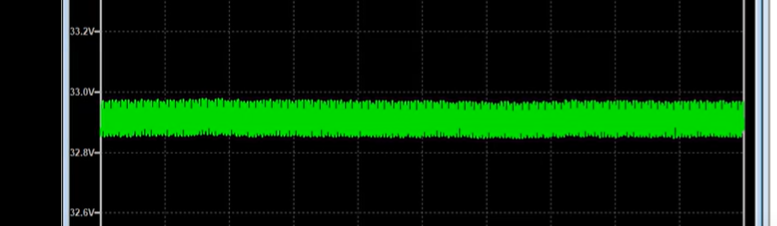
[picture p71: figure]

Discontinuous conduction mode

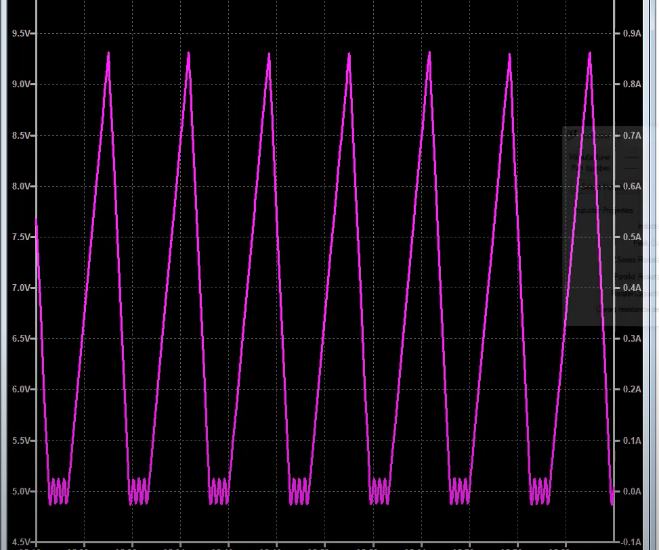
[picture p72: figure]

Increasing the inductance or decreasing the load produces this output

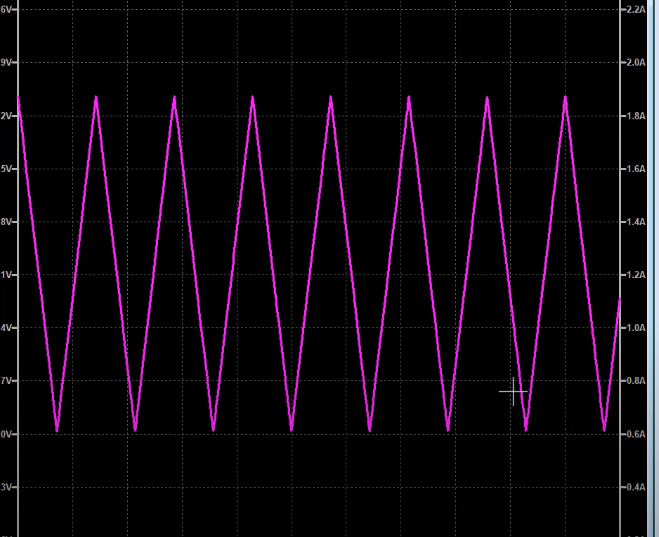
[picture p73: figure]
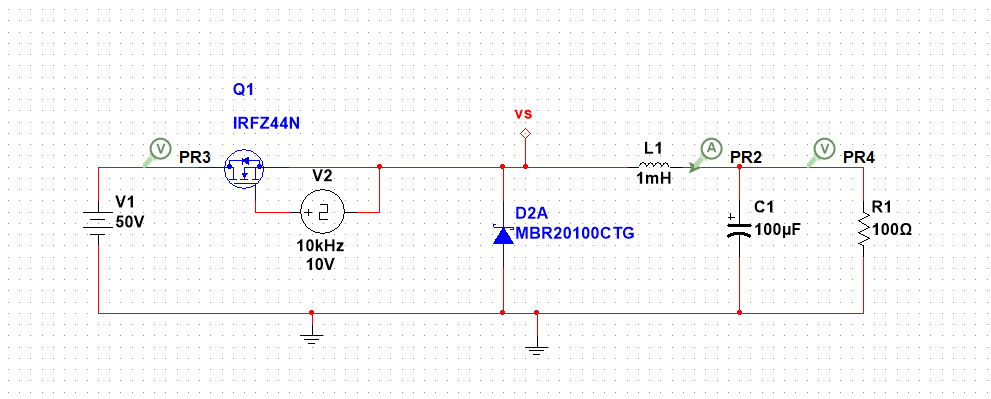
[picture p74: figure]
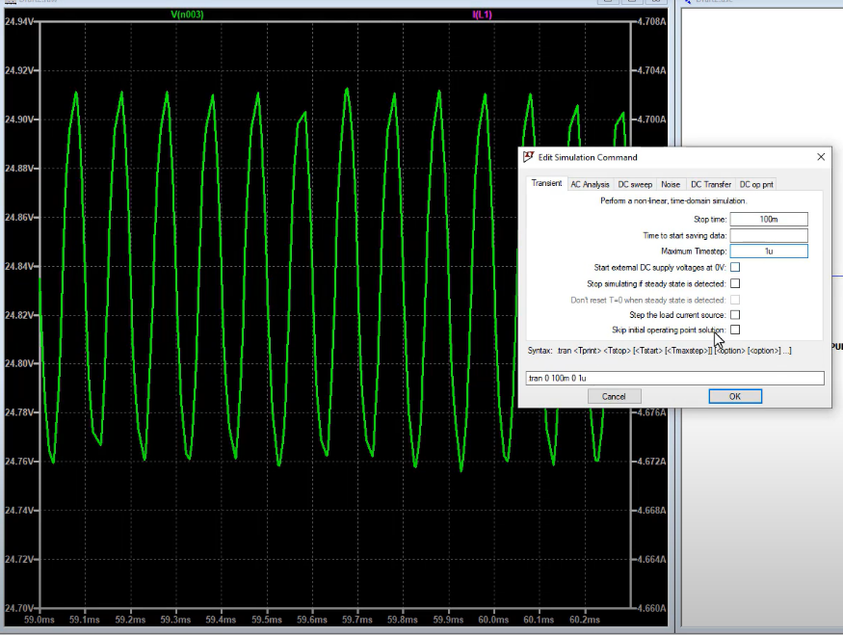
[picture p75: figure]
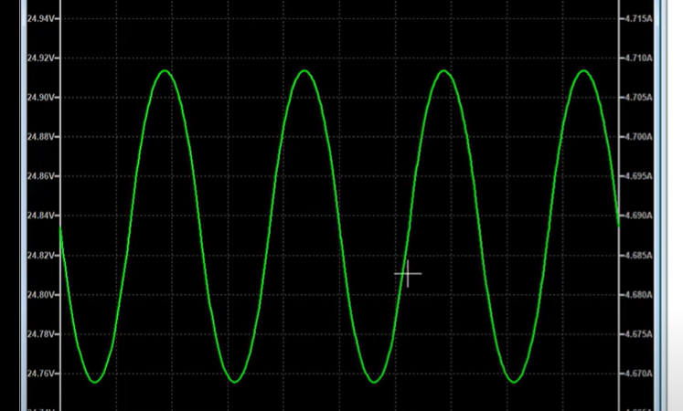
[picture p76: figure]
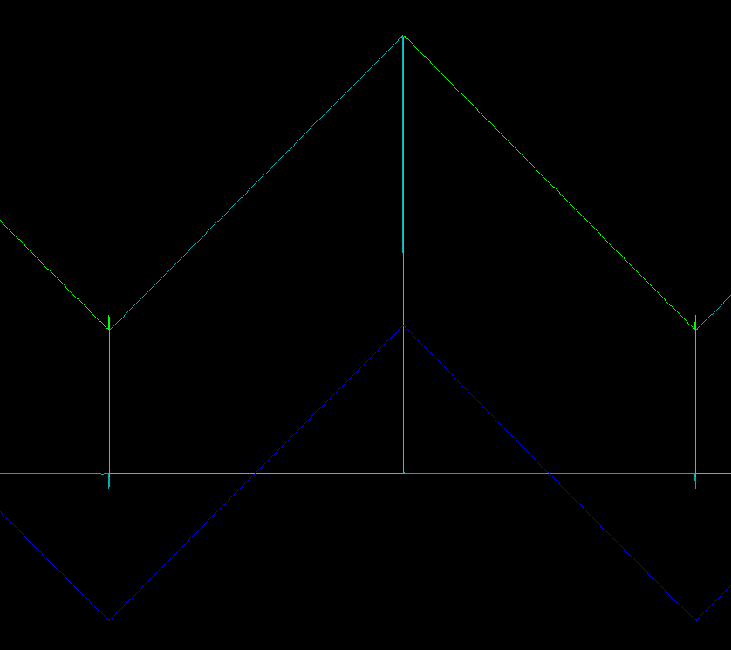
[picture p77: figure]

# The effect of parasitic resistance in a capacitor ESR

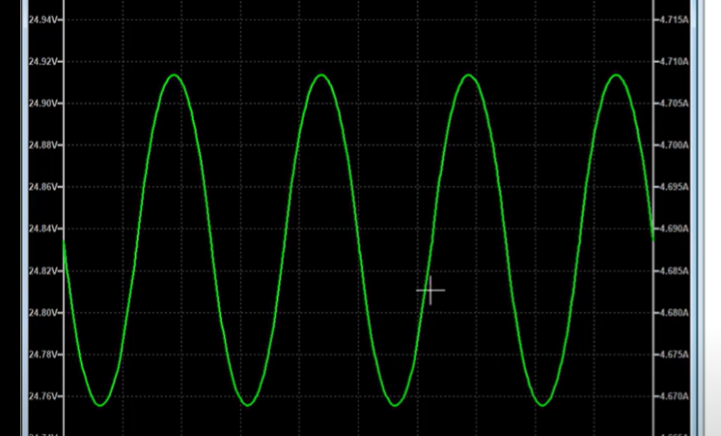
[picture p78: figure]
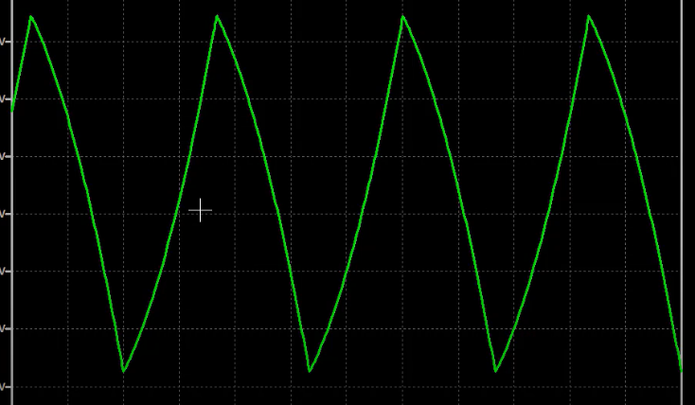
[picture p79: figure]

The voltage mirrors the inductor current because the resistor mirrors the inductor current

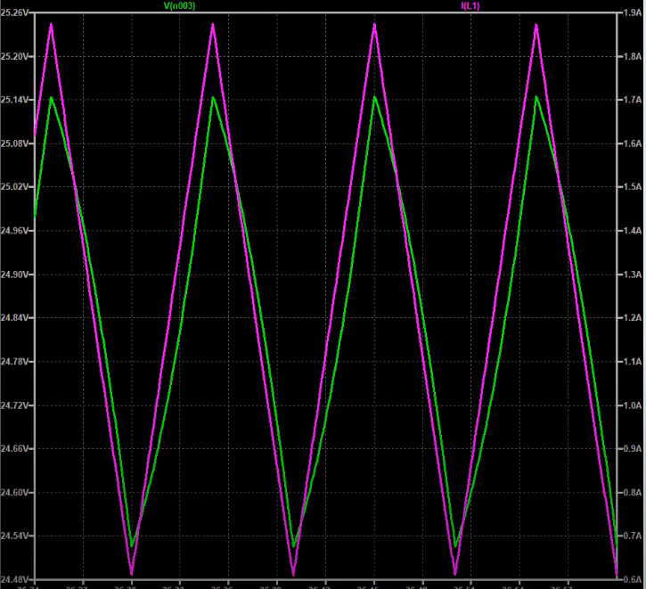
[picture p80: figure]

When adding parasitic inductance

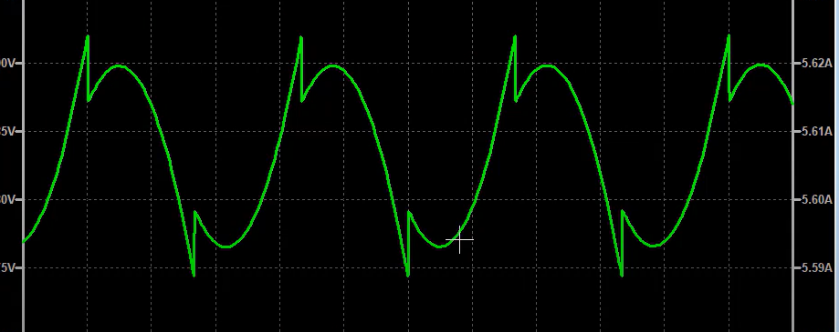
[picture p81: figure]
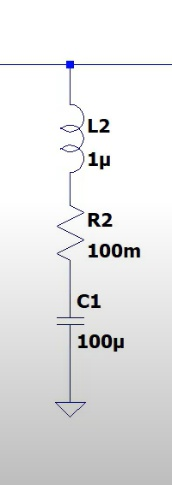
[picture p82: figure]

Long leads or long tracs on the pcb lead to parasitic inductance Lp

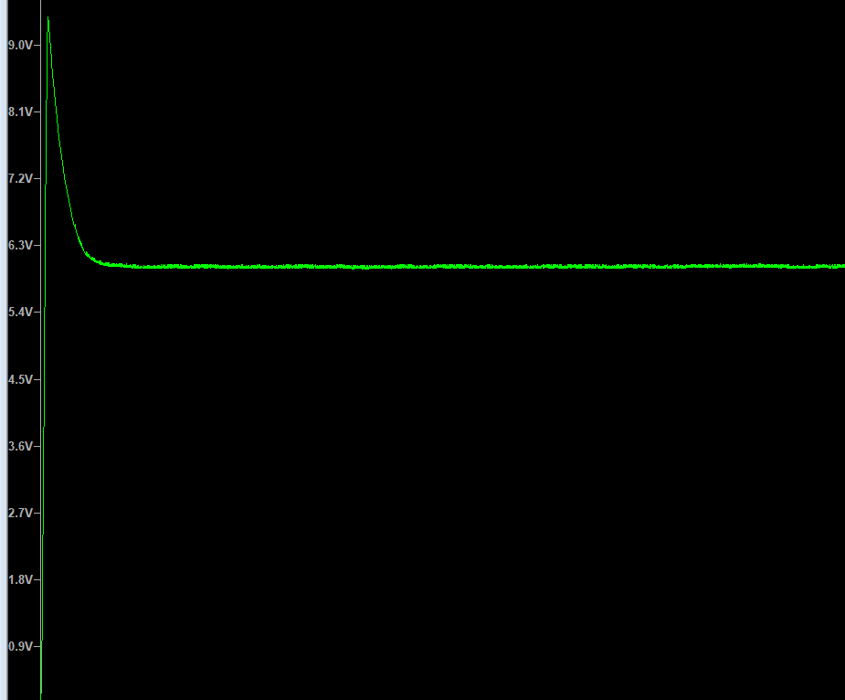
[picture p83: figure]
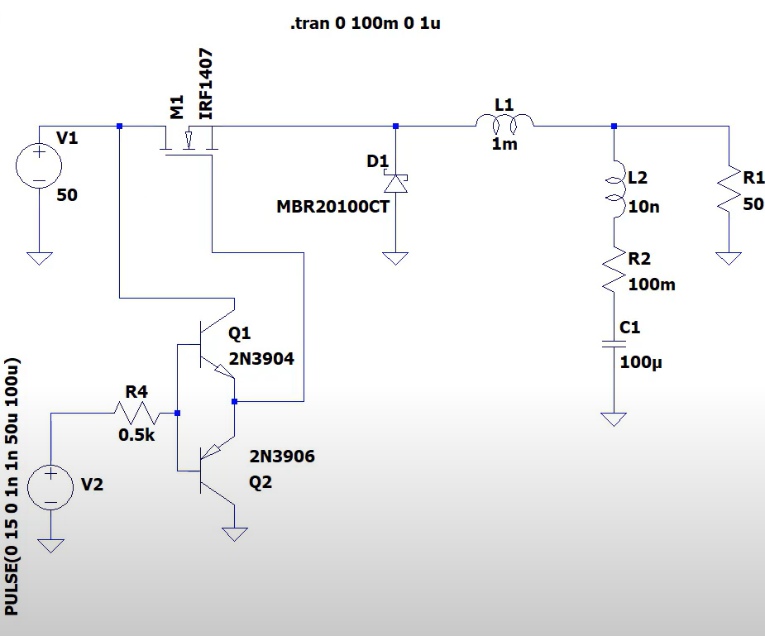
[picture p84: figure]
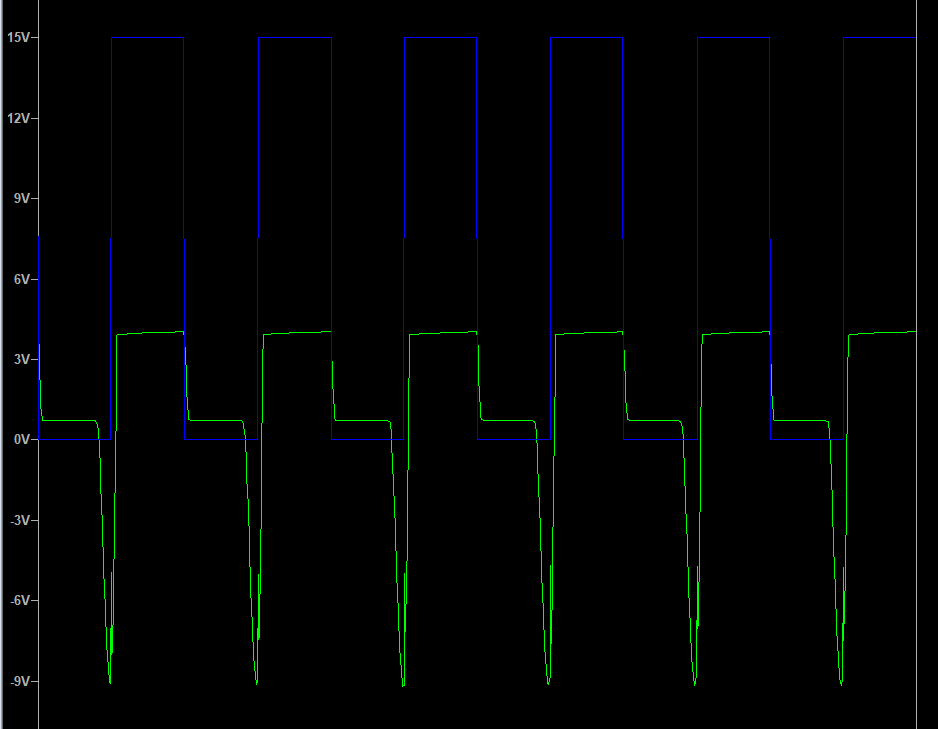
[picture p85: figure]
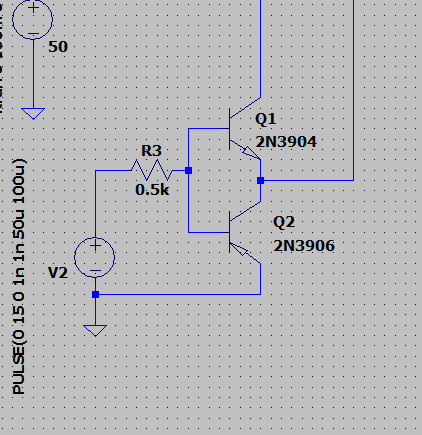
[picture p86: figure]

Push-pull is good for low side switching

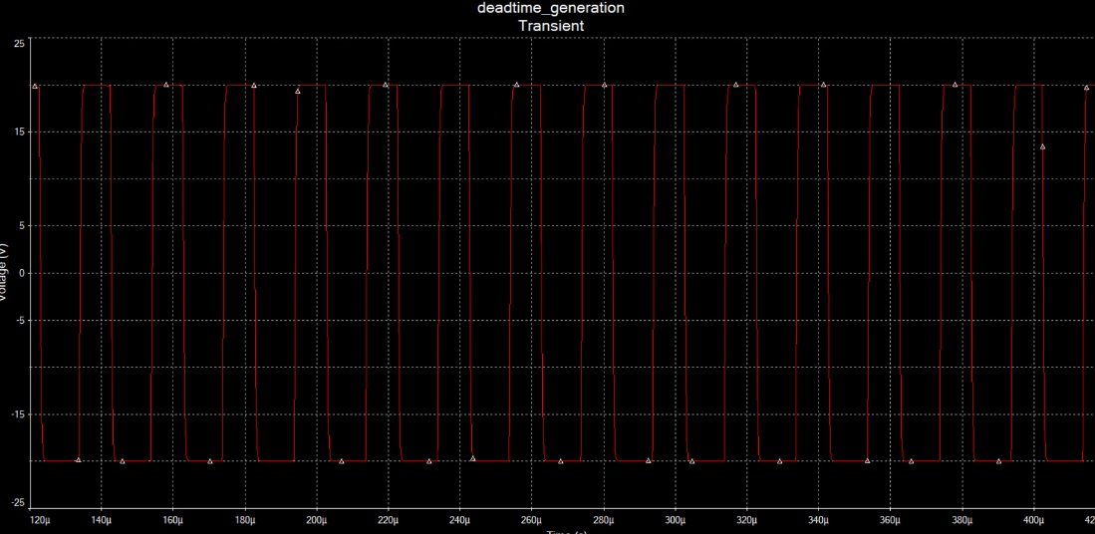
[picture p87: figure]
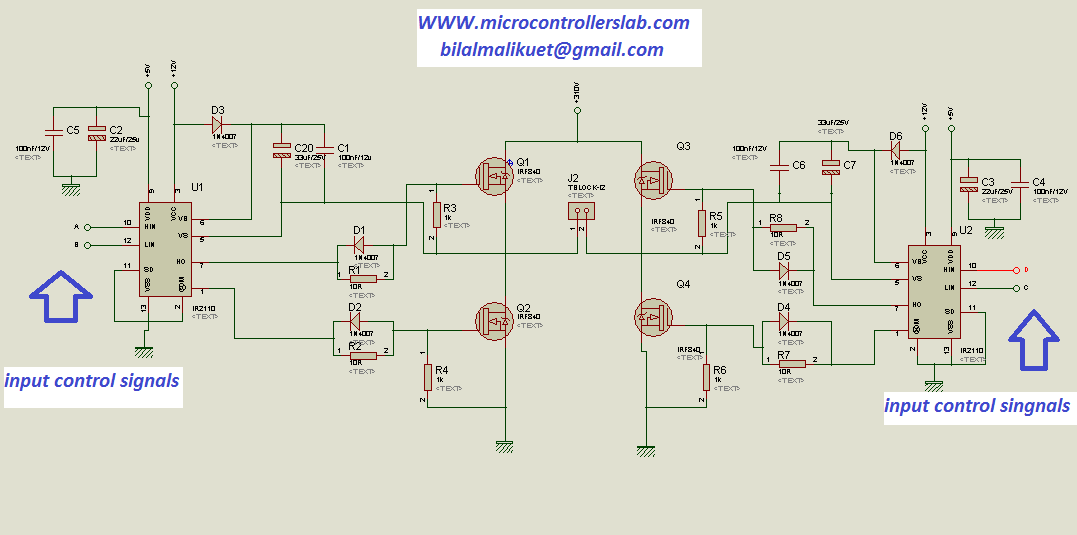
[picture p88: figure]

Buck design

  - For a buck converter to function normally a feedback is required

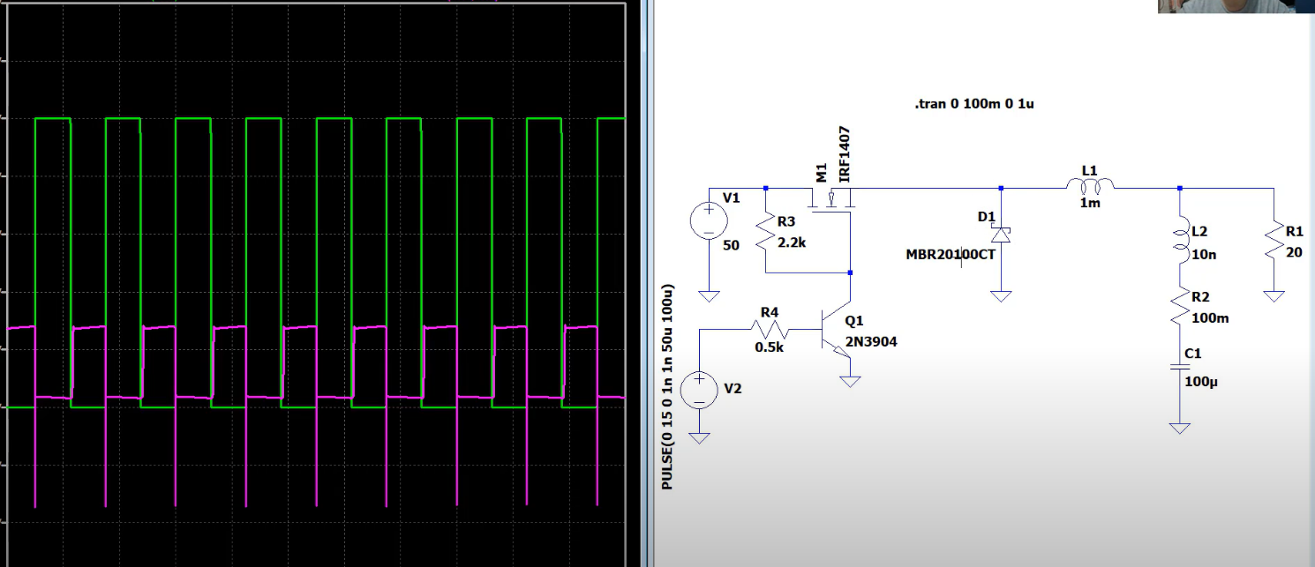
[picture p89: figure]

The negative voltage ripples between the peaks in the purple waveform can be attributed to several factors related to the operation of the DC-DC converter circuit, particularly during the switching transitions. Here's a detailed explanation:

Inductor Current Behavior

  - Inductor Charging and Discharging:
  - When the MOSFET (M1) is on, current flows through the inductor (L1), storing energy in its magnetic field. The voltage across the inductor is positive during this time.
  - When the MOSFET turns off, the inductor's current continues to flow, but it needs a path. The current flows through the diode (D1), and this current helps maintain the load voltage. During this period, the inductor's voltage reverses (Lenz's Law), which can cause the output voltage to drop.

Freewheeling Diode and Inductor Voltage

  - Diode Forward Voltage Drop:
  - When the MOSFET turns off, the freewheeling diode (D1) conducts. However, the diode has a forward voltage drop (around 0.2-0.4V for Schottky diodes, but higher for others), which can cause a temporary dip in the output voltage.
  - This forward voltage drop can create a negative dip if the load voltage momentarily drops below the reference ground level due to the switching dynamics.

Switching Transients

  - Switching Transients:
  - During the switching transitions, there can be high-frequency oscillations or ringing caused by parasitic inductances and capacitances in the circuit. These transients can temporarily pull the voltage below zero.
  - The inductive kickback, a phenomenon where the inductor resists the sudden change in current when the MOSFET switches off, can also cause a negative voltage spike.

Parasitic Elements

  - Parasitic Inductances and Capacitances:
  - Parasitic inductances in the circuit board traces and connections can contribute to the negative voltage spikes during the rapid switching of the MOSFET.
  - Parasitic capacitances can resonate with these inductances, leading to oscillatory behavior and negative voltage ripples.

Circuit Design and Component Values

  - Component Values and Layout:
  - The values of the inductor (L1) and the capacitor (C1) play a significant role in filtering out these ripples. Insufficient filtering capacitance or inappropriate inductance value can result in inadequate suppression of these negative transients.
  - The physical layout of the circuit, including trace lengths and the positioning of components, can influence the magnitude of these negative ripples due to varying inductive and capacitive effects.

Example Explanation in Context

In the provided circuit:

  - When the pulse signal (green waveform) turns off the MOSFET (M1), the inductor (L1) tries to maintain the current flow, causing a temporary negative voltage at the output due to the inductor's behavior and the forward voltage drop across the diode (D1).
  - The ringing or oscillations in the purple waveform can be due to the parasitic elements in the circuit and the sudden switching transitions.

Conclusion

The negative voltage ripples between the peaks in the purple waveform are a result of the inductor's energy release, the forward voltage drop of the diode, switching transients, and parasitic elements in the circuit. To minimize these negative ripples, you can:

  - Use a snubber circuit across the MOSFET to dampen switching transients.
  - Increase the capacitance of the output capacitor (C1) to better filter out the voltage dips.
  - Optimize the physical layout to reduce parasitic inductances and capacitances.

Here are the key points about different types of diodes, particularly focusing on their applications and limitations:

### Schottky Diodes

- **Characteristics**: Schottky diodes have a low forward voltage drop (typically 0.2 to 0.3 V) and fast switching times.

- **Limitations**: They are not suitable for high-voltage applications. Their reverse voltage rating is generally low, typically below 200V.

- **Applications**: Used in low-voltage circuits, power rectification, and fast switching applications.

### Recovery Diodes

- **Characteristics**: Recovery diodes are designed to handle high-voltage and high-current applications. They have a higher reverse recovery time compared to Schottky diodes.

- **Types**:

- **Fast Recovery Diodes**: Designed to have a shorter reverse recovery time than standard diodes. Suitable for high-frequency applications.

- **Ultra-Fast Recovery Diodes**: Have even shorter recovery times than fast recovery diodes, making them ideal for very high-frequency applications.

- **Applications**: Used in power supplies, motor drives, and other high-voltage circuits where high efficiency and fast recovery are required.

### Switching Diodes

- **Characteristics**: Switching diodes are optimized for switching applications. They have low capacitance and are capable of high-speed operation.

- **Applications**: Commonly used in digital circuits, signal processing, and high-speed switching applications.

### Summary of Applications

- **Schottky Diodes**: Low-voltage circuits, power rectification, fast switching.

- **Recovery Diodes**: High-voltage and high-current applications, power supplies, motor drives.

- **Switching Diodes**: Digital circuits, signal processing, high-speed switching.

By understanding the characteristics and limitations of each type of diode, you can select the appropriate one for your specific application requirements.

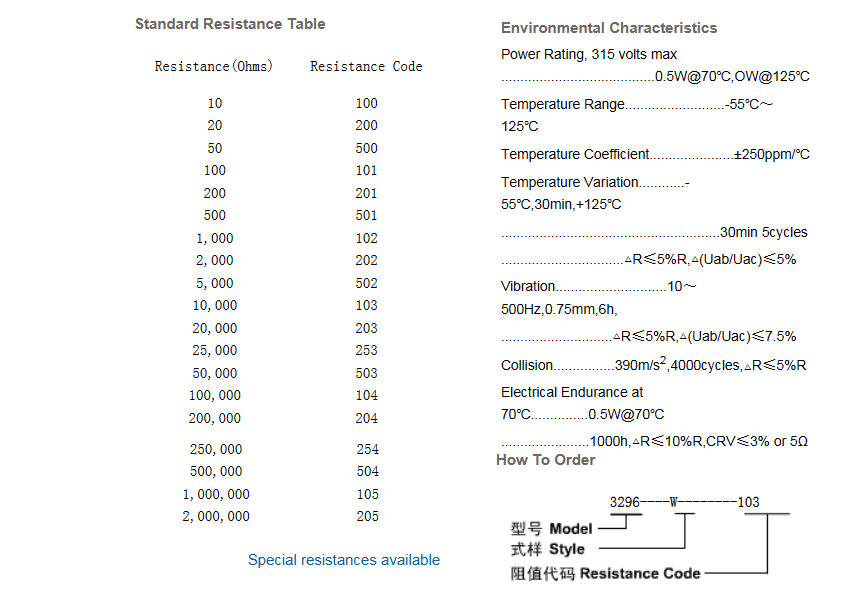
[picture p90: figure]

| Buck converter feedback

Test FB

To measure the voltage over different resistors and configure the TIM1 timer on an STM32 microcontroller, follow these organized steps:

### Voltage Measurement

1. **Measure the voltage over a \(100 \, \Omega\) resistor.**

2. **Repeat the measurement for a \(200 \, \Omega\) resistor.**

### Timer Configuration for STM32 Microcontroller

To configure the TIM1 timer to operate at \(50 \, \text{kHz}\) using a \(72 \, \text{MHz}\) clock, follow the instructions below:

1. **Understanding Timer Frequency Formula**

The timer frequency (in Hz) is given by the formula:

\[

f_{\text{timer}} = \left( \text{prescaler} + 1 \right) \times \left( \text{ARR} + 1 \right) \times f_{\text{clk}}

\]

Where:

- \( f_{\text{timer}} \) is the desired timer frequency (\(50 \, \text{kHz}\)).

- \( f_{\text{clk}} \) is the clock frequency (\(72 \, \text{MHz}\)).

- Prescaler and ARR are the values to be set in the timer’s configuration registers.

2. **Rearranging the Formula**

Rearrange the formula to solve for ARR:

\[

\text{ARR} = \frac{f_{\text{clk}}}{f_{\text{timer}}} \times \left( \text{prescaler} + 1 \right) - 1

\]

3. **Calculate ARR Value**

Assume the prescaler is set to 0 (full clock speed):

\[

\text{ARR} = \frac{72 \times 10^6 \, \text{Hz}}{50 \times 10^3 \, \text{Hz}} \times \left( 0 + 1 \right) - 1 = 1439

\]

4. **STM32 HAL Library Configuration**

Here’s how to configure the TIM1 timer in your code using the STM32 HAL library:

```c

TIM_HandleTypeDef htim1;

htim1.Instance = TIM1;

htim1.Init.Prescaler = 0;

htim1.Init.Period = 1439; // ARR value

htim1.Init.ClockDivision = TIM_CLOCKDIVISION_DIV1;

htim1.Init.CounterMode = TIM_COUNTERMODE_UP;

if (HAL_TIM_Base_Init(&htim1) != HAL_OK)

{

// Insert error handling code here

}

```

This sequence ensures you properly measure the voltage over different resistors and correctly configure the TIM1 timer for the desired frequency.
| Ground Isolation | How to detect actuator feedback voltage using Arduino/esp32? | Forum for Electronics (edaboard.com) (https://www.edaboard.com/threads/how-to-detect-actuator-feedback-voltage-using-arduino-esp32.408423/)

Power supplies

  1. Buck Converter: A buck converter is a DC-to-DC power converter which steps down voltage from its input (supply) to its output (load). It’s more efficient than linear voltage regulators.
  2. Transformer: For AC voltages, a transformer can be used to step down the voltage. The ratio of primary (input) windings to secondary (output) windings determines the output voltage.
  3. Resistor Divider: A simple method is to use a resistor divider circuit. However, this method is not very efficient and the output voltage can vary with the load.
  4. Zener Diode: A Zener diode can be used to provide a constant output voltage regardless of the input voltage, but only up to a certain current limit.
  5. Linear Regulator: While I mentioned voltage regulators earlier, it’s worth noting that there are different types, and linear regulators are one of them. They are simple and cheap, but not as efficient as switching regulators or buck converters.

Zener Diode or voltage regulator
| Testing Inverter + deadtime generation

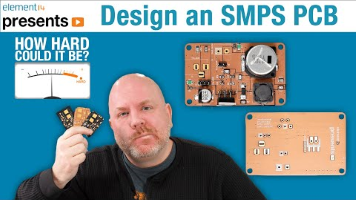
[picture p91: figure]
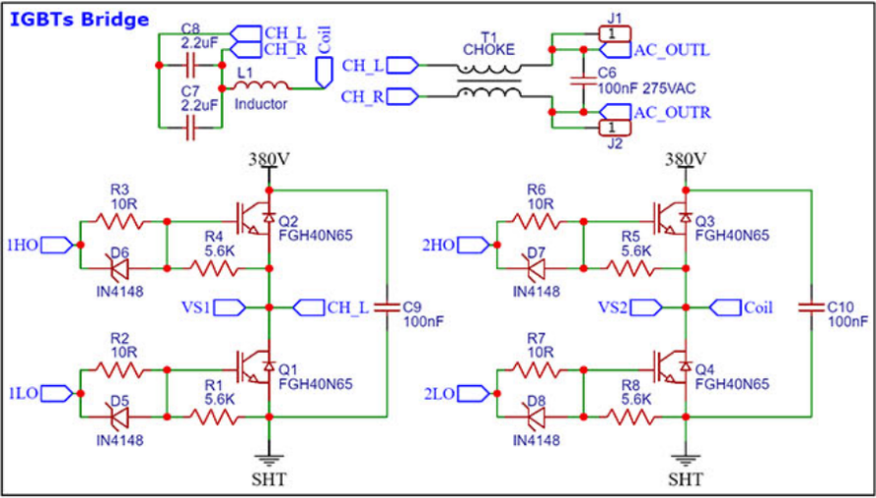
[picture p92: figure]
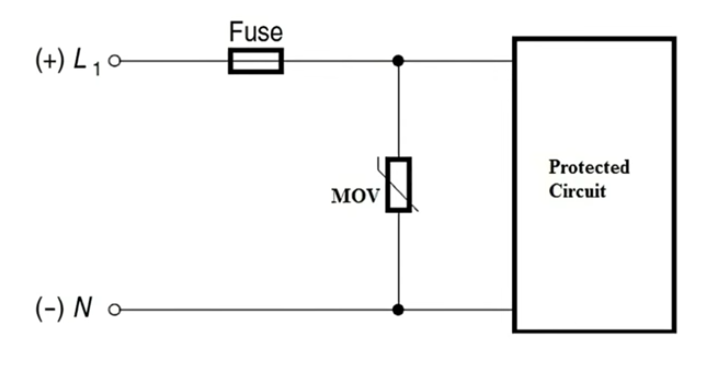
[picture p93: figure]
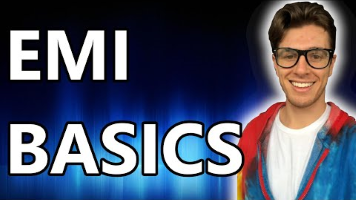
[picture p94: figure]
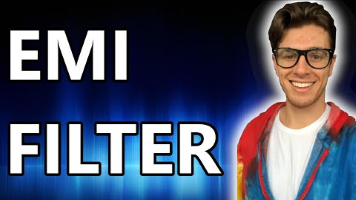
[picture p95: figure]

| Additional Inverter components | A Noise-Free DIY Switching Power Supply - How Hard Can It Be? (https://www.youtube.com/watch?v=ojB2gC0o7bg&ab_channel=element14presents) - PCB tips How to sense the voltage? Inverter output circuit EMI FOR BEGINNERS EXPLAINED| ELECTROMAGNETIC INTERFERENCE FOR BEGINNERS - COMPLETE EMI GUIDE (https://www.youtube.com/watch?v=8IzmtrsVaOY&ab_channel=RGBEngineering) EMI FILTER DESIGN GUIDE | EMI INPUT FILTER DESIGN | DESIGN GUIDE | ELECTROMAGNETIC INTERFERENCE (https://www.youtube.com/watch?v=q7z0ht7eCig&ab_channel=RGBEngineering)

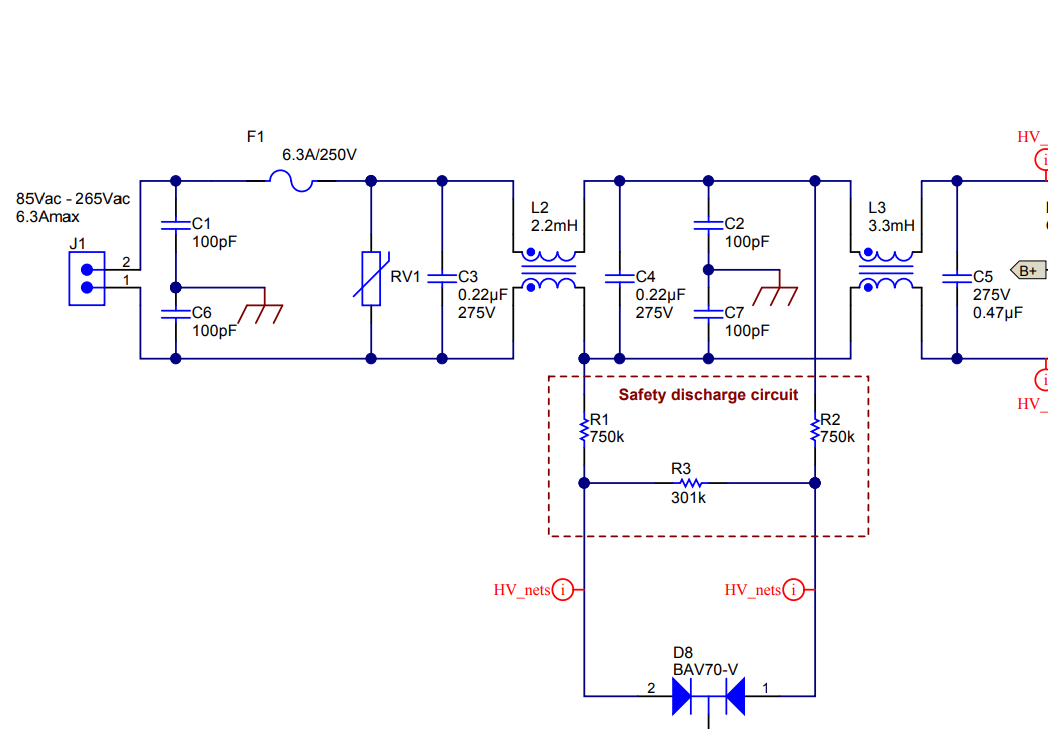
[picture p96: figure]
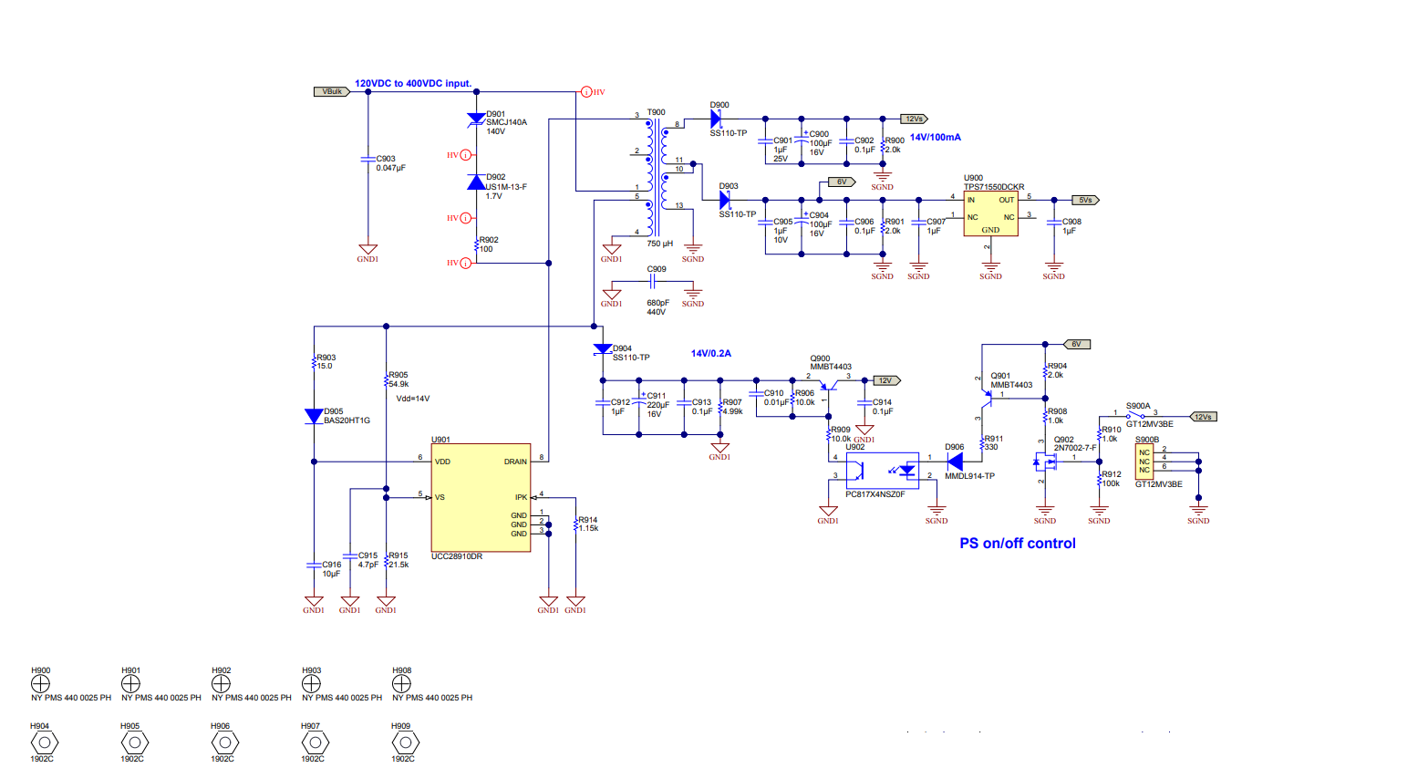
[picture p97: figure]
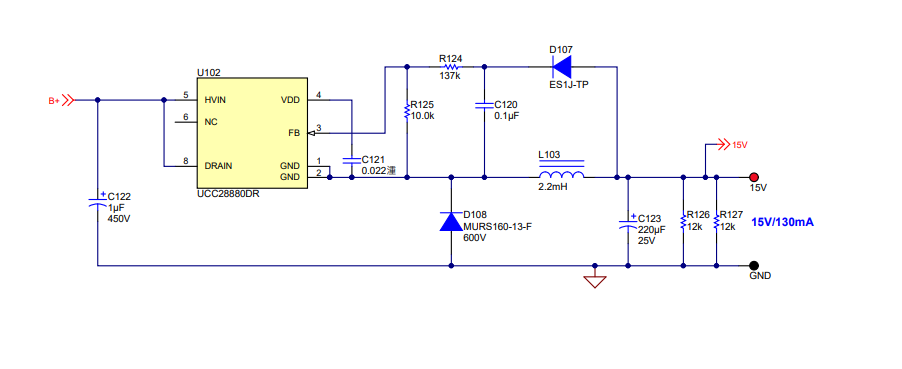
[picture p98: figure]

| Bias Voltage Power supply | PMP9640 reference design | TI.com (https://www.ti.com/tool/PMP9640) HV to LV Power supply PMP22606 reference design | TI.com (https://www.ti.com/tool/PMP22606) DC Power supply
| | Buck Converter Design and Feedback Controller Using Core Independent Peripherals (microchip.com) (https://ww1.microchip.com/downloads/en/Appnotes/Buck-ConvDesign-Feedback-Ctrl-Using-CIP-DS00003725A.pdf) PIC-003 (aosmd.com) (https://www.aosmd.com/res/application_notes/power-ics/PIC-003.pdf)

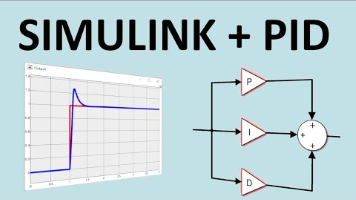
[picture p99: figure]
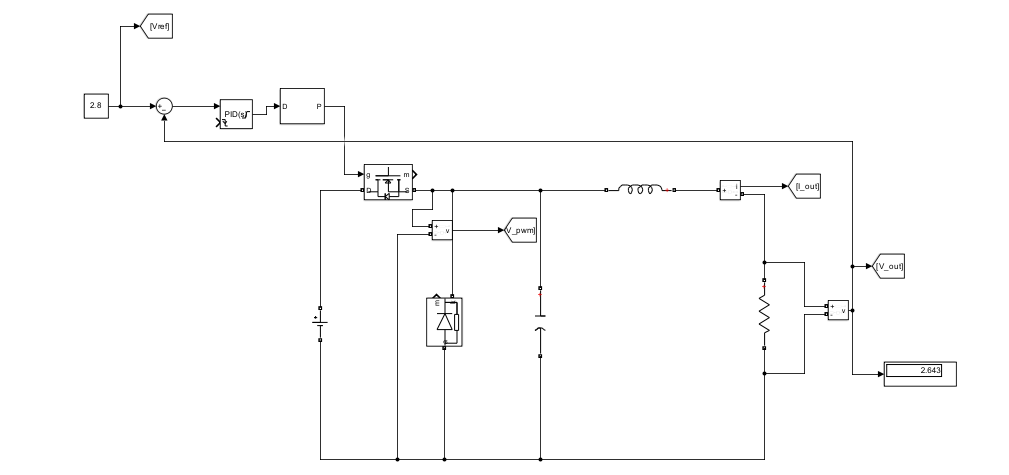
[picture p100: figure]
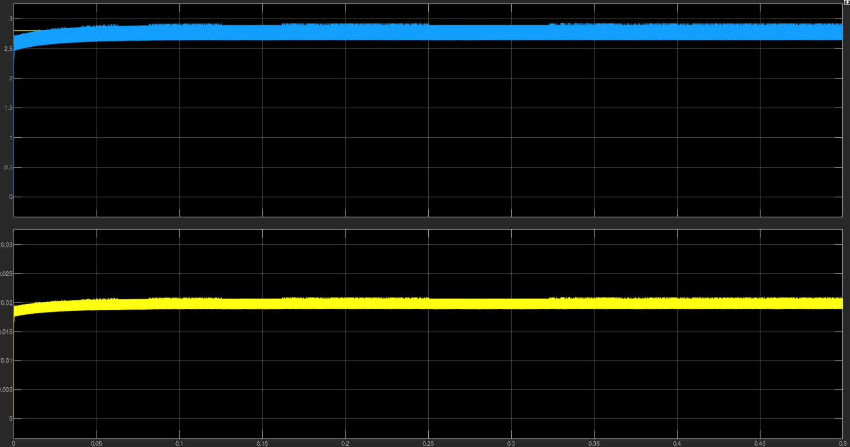
[picture p101: figure]

| PID simulation Simulink | Simulink Control Systems and PID, Matlab R2020b (https://www.youtube.com/watch?v=PRFCBVTFy90&t=70s&ab_channel=NikolaiK.) Buck design PID result

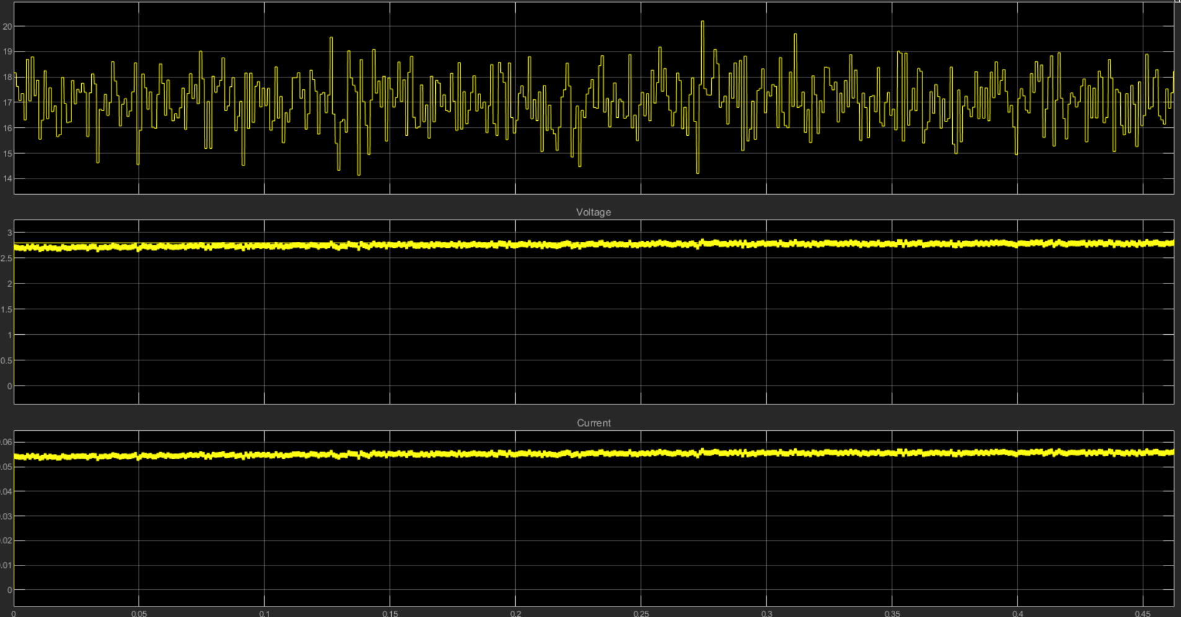
[picture p102: figure]

| Research Study Implementation Topic Noise Simulation | Resources Components Additional Notes Results

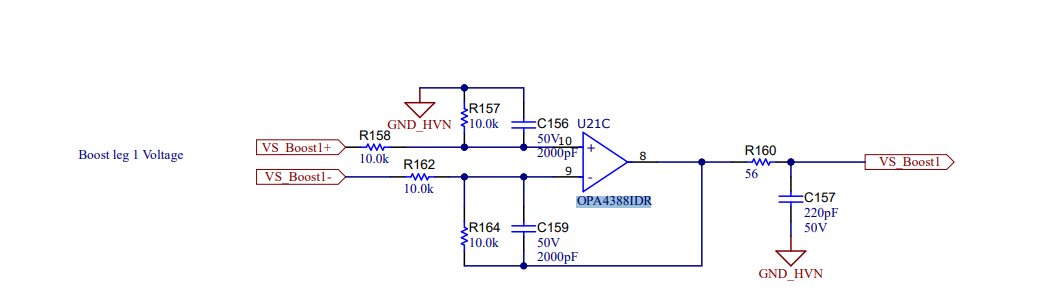
[picture p103: figure]
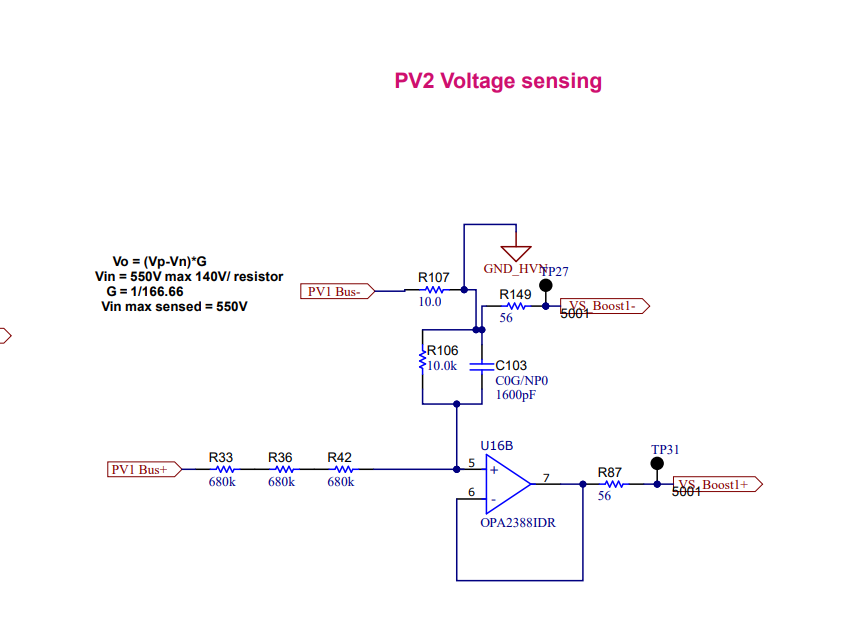
[picture p104: figure]

| Research Study Implementation Topic Voltage feedback | Simple voltage divider TIDA-010938 reference design | TI.com (https://www.ti.com/tool/TIDA-010938)

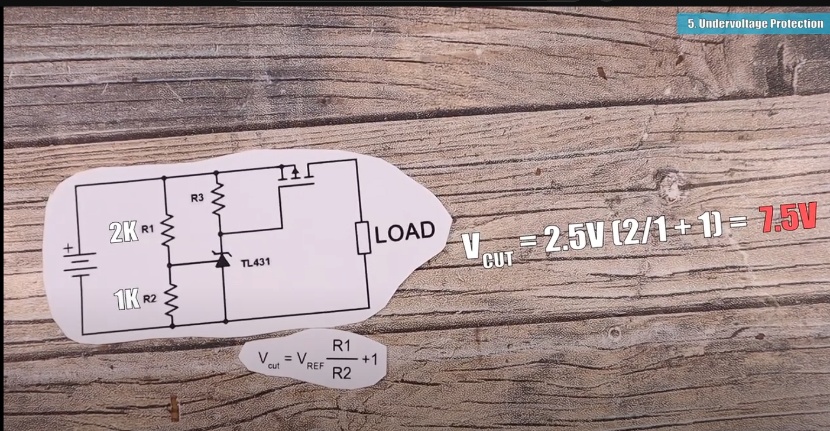
[picture p105: figure]
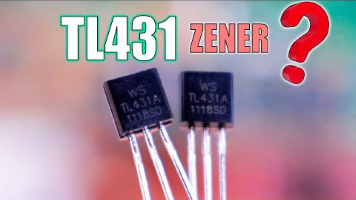
[picture p106: figure]
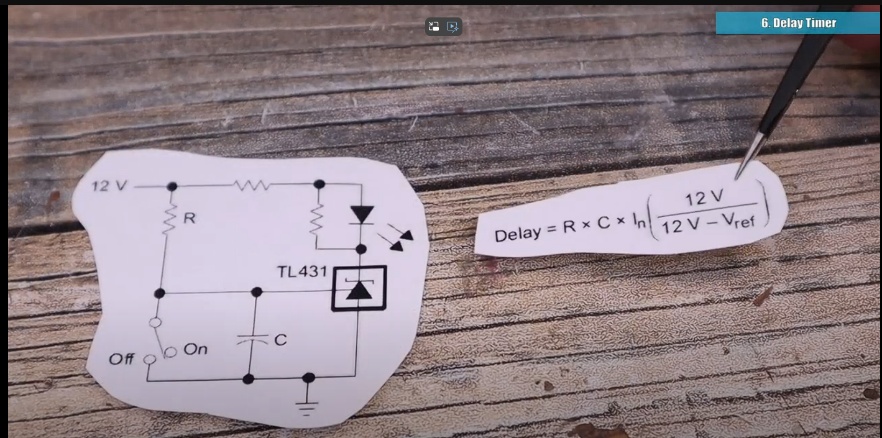
[picture p107: figure]

30/05/2024 | Research Study Implementation Topic Voltage sensing | Extra notes TL432LI data sheet, product information and support | TI.com (https://www.ti.com/product/TL432LI) Crowbar circuit : used to short the circuit so as to blow the fuse Undervoltage Proteciton This IC is Multifunctional - TL431 Circuits (https://www.youtube.com/watch?v=NecbHbGAkkc&ab_channel=Electronoobs) Delay Timer
| F

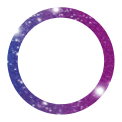
[picture p108: figure]
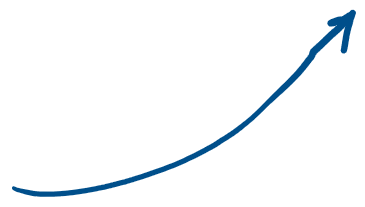
[picture p109: figure]
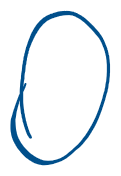
[picture p110: figure]
