Little3gy/VFD-Control-System/media/VFD Control System_Development Portfolio.pdf

# VFD Control System: Development Portfolio

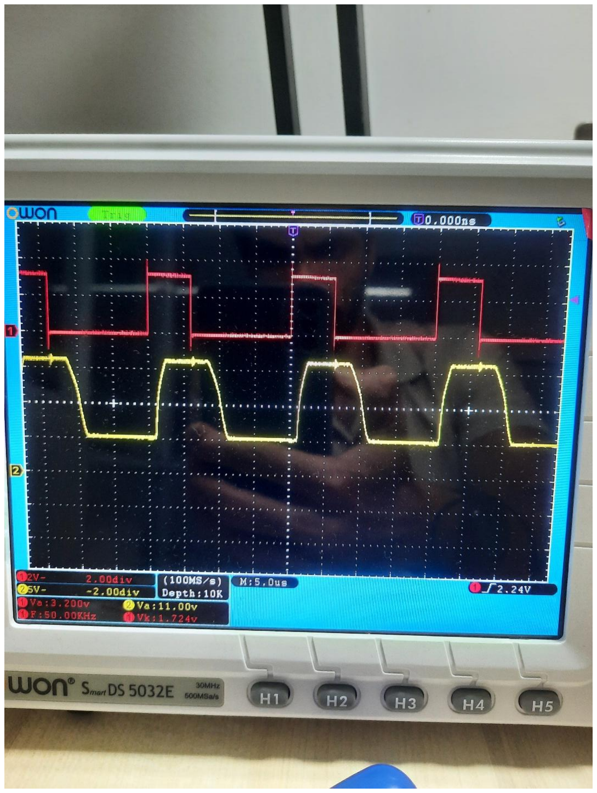
[picture p197: figure]

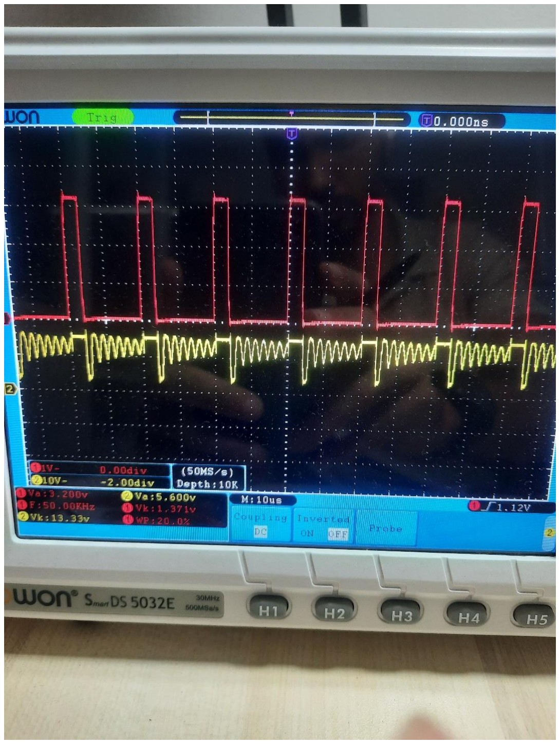
[picture p198: figure]

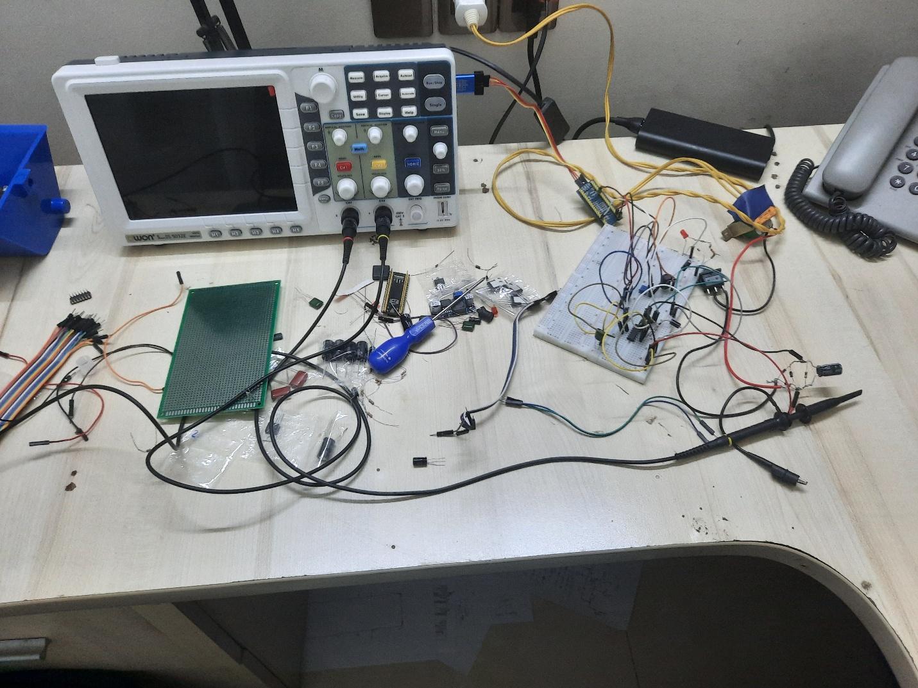
[picture p199: figure]

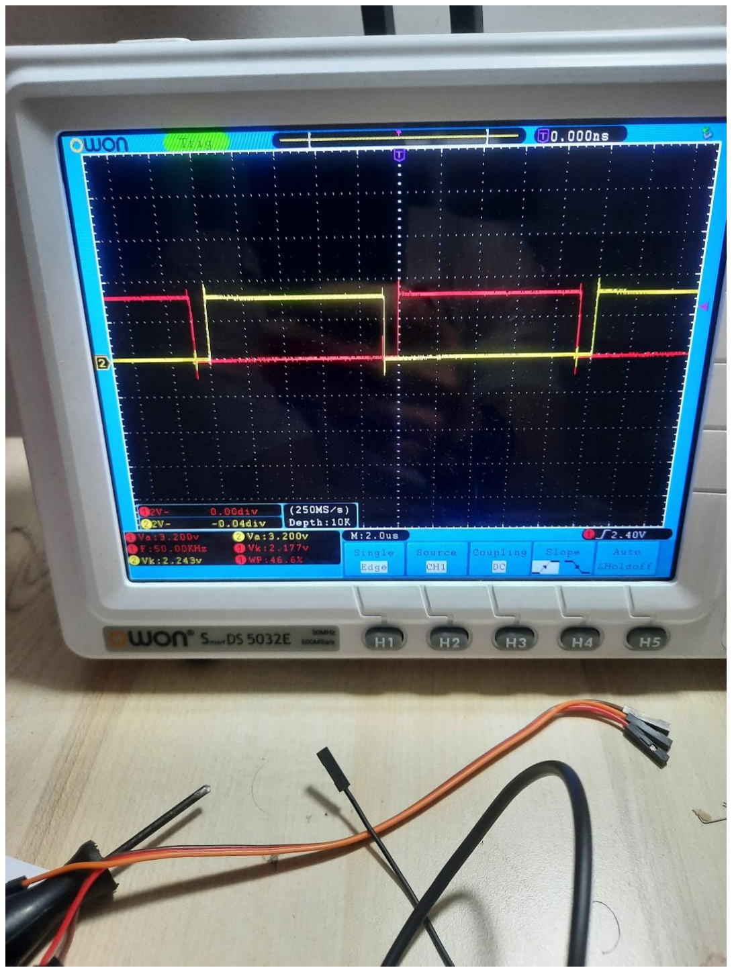
[picture p200: figure]

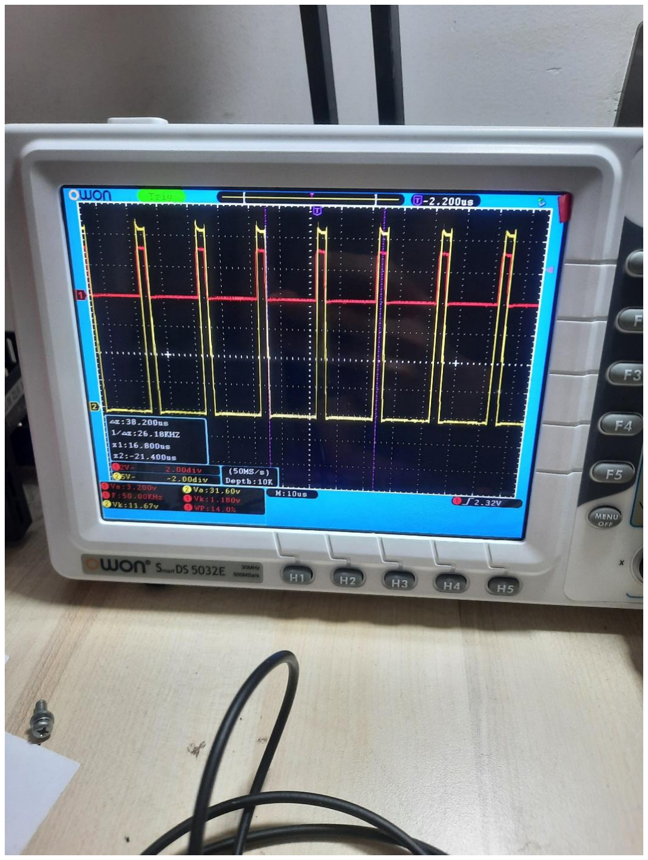
[picture p201: figure]

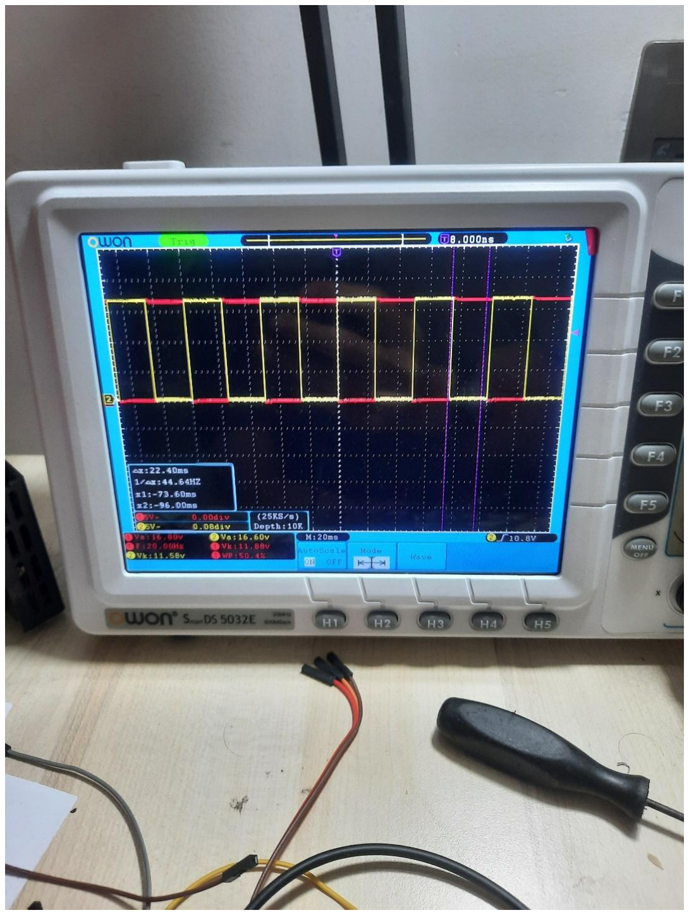
[picture p202: figure]

Figure 1Deadtime generation circuit testing

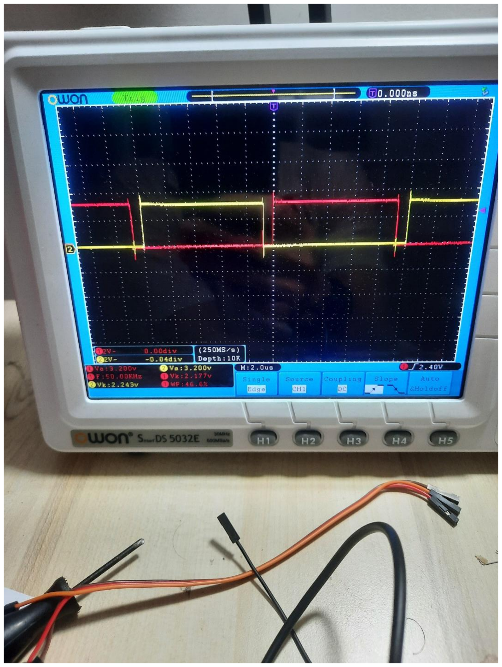
[picture p203: figure]

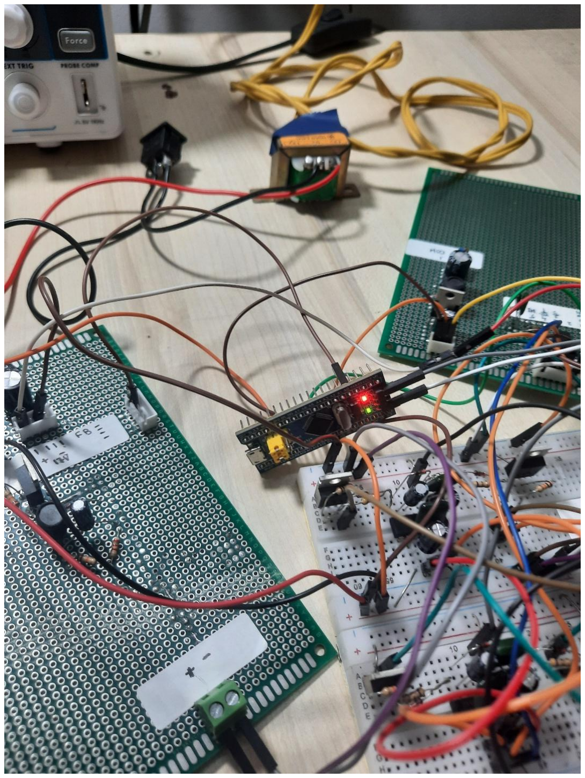
[picture p204: figure]

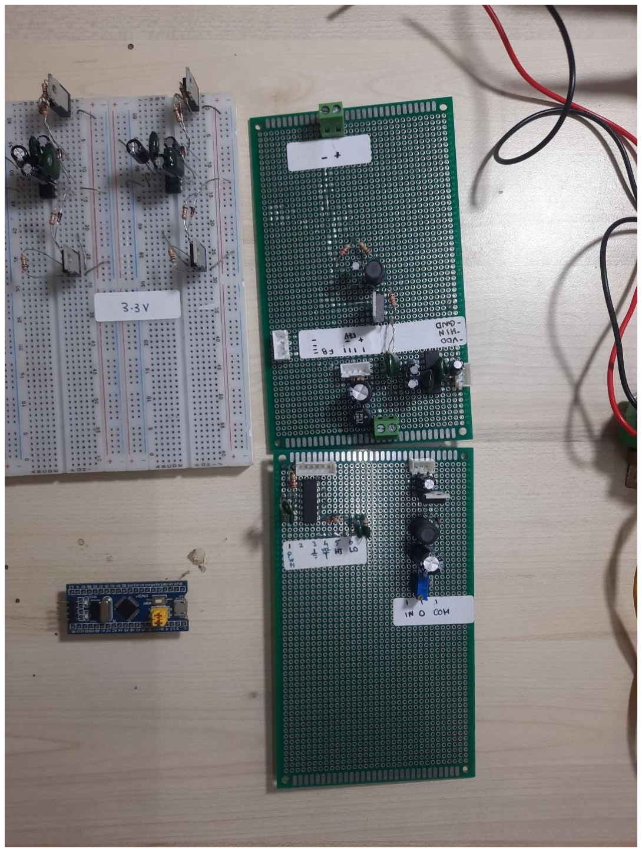
[picture p205: figure]

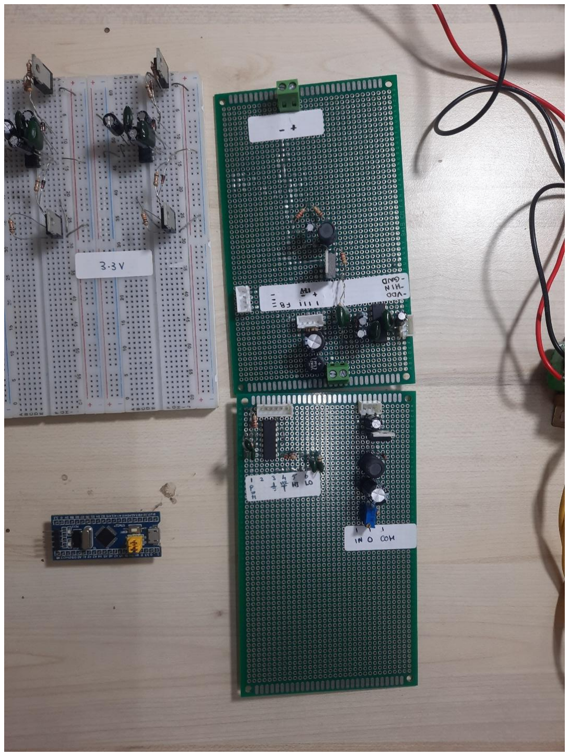
[picture p206: figure]

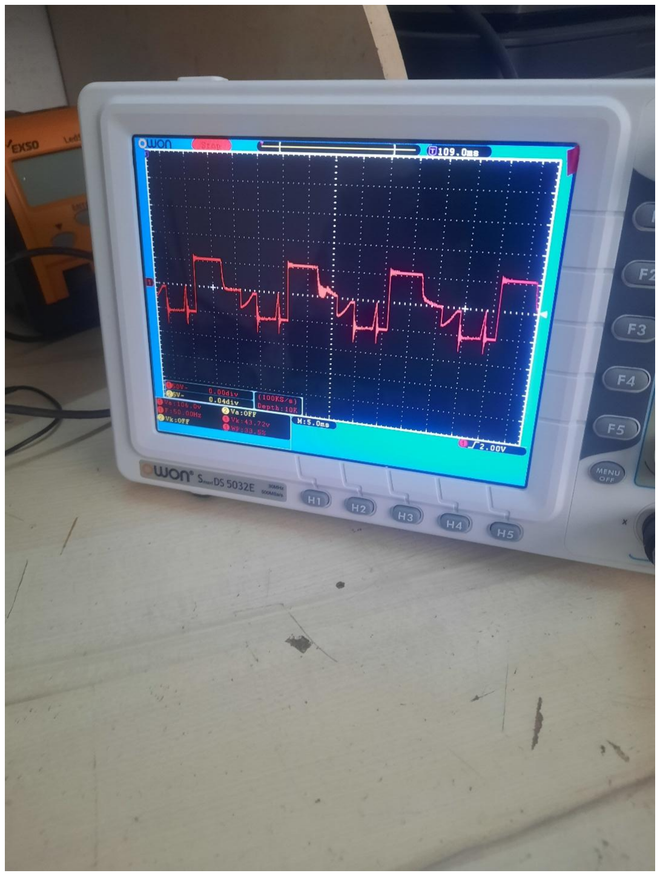
[picture p207: figure]

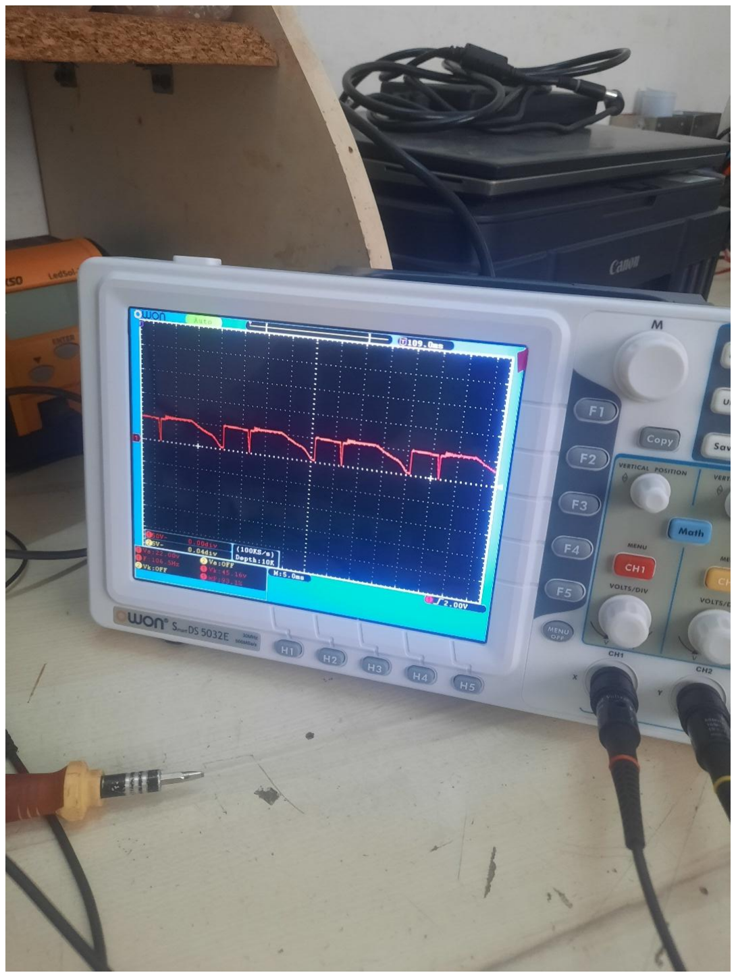
[picture p208: figure]

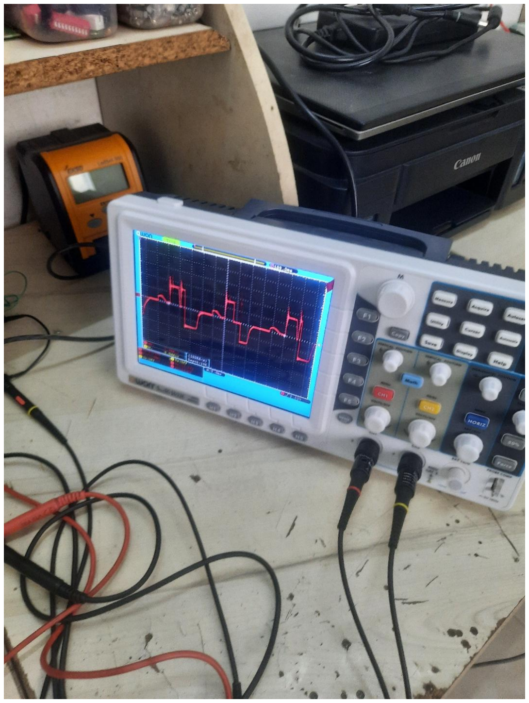
[picture p209: figure]

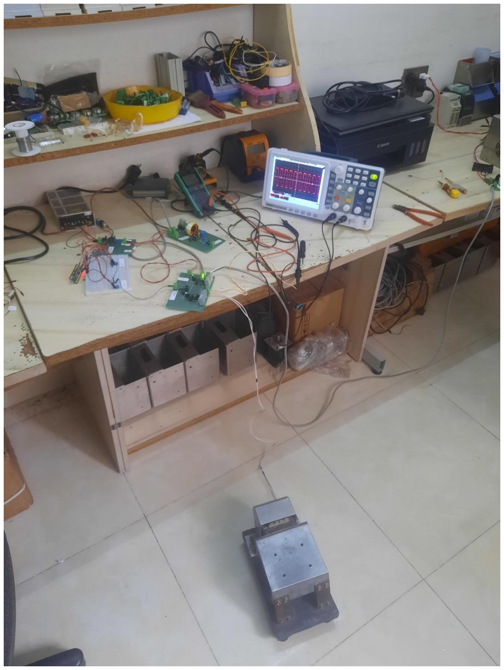
[picture p210: figure]

Figure 2First working prototype with the vibrator

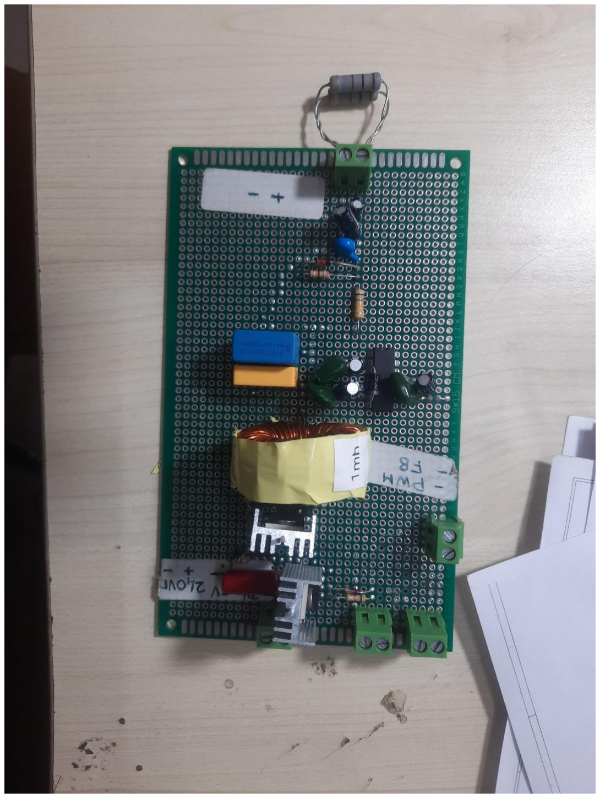
[picture p211: figure]

Figure 3 High voltage buck converter

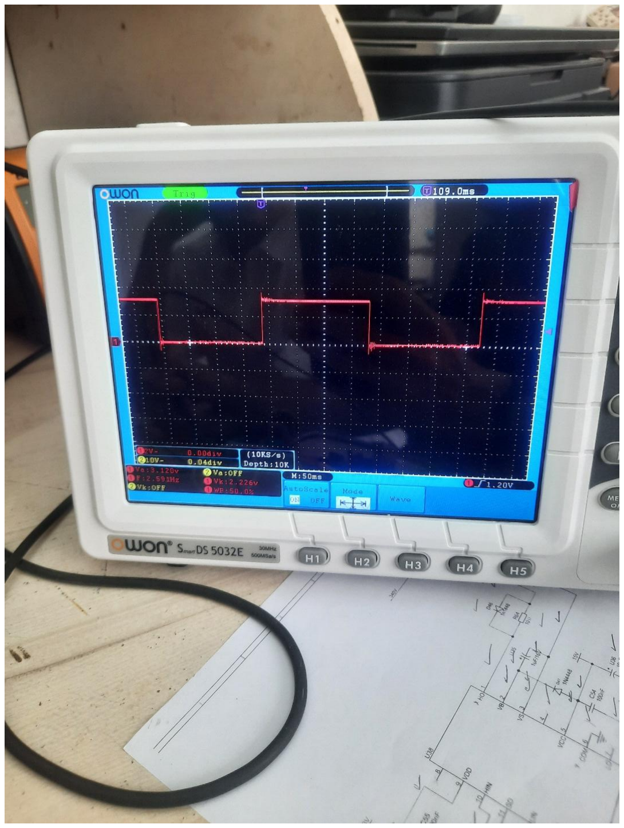
[picture p212: figure]

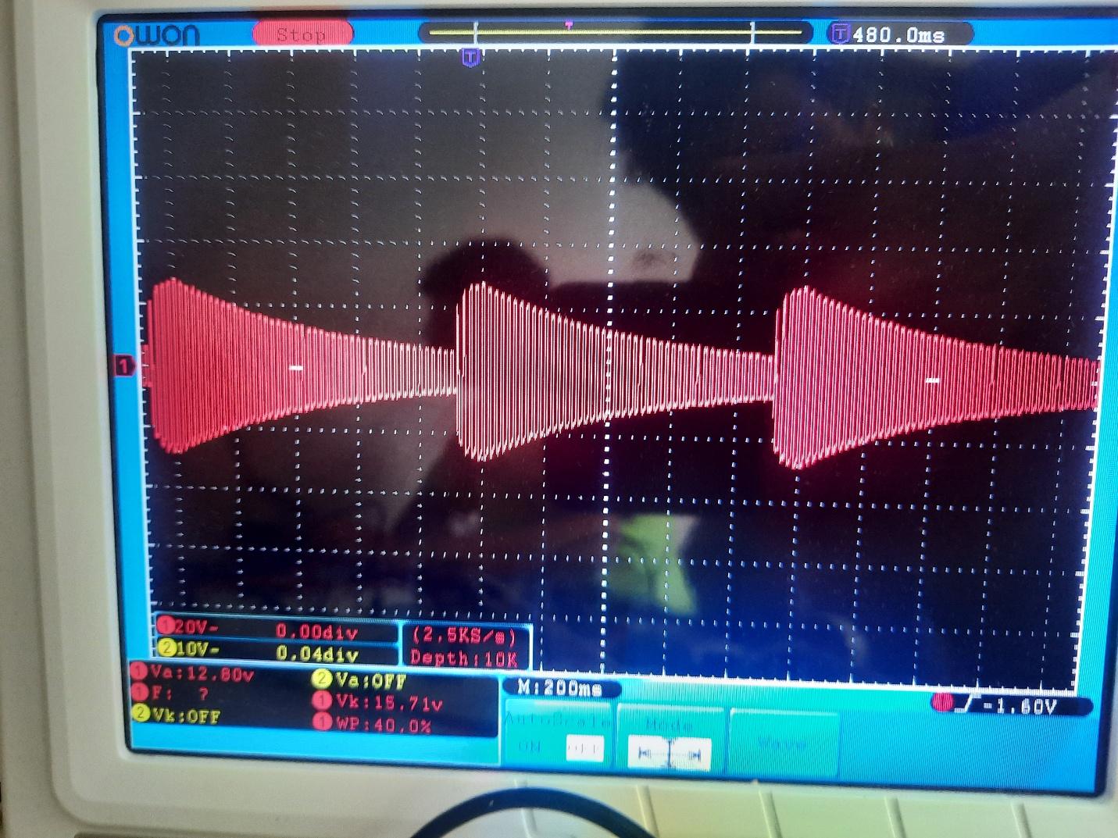
[picture p213: figure]

Figure 4 impedance mismatch between the VFD and the motor

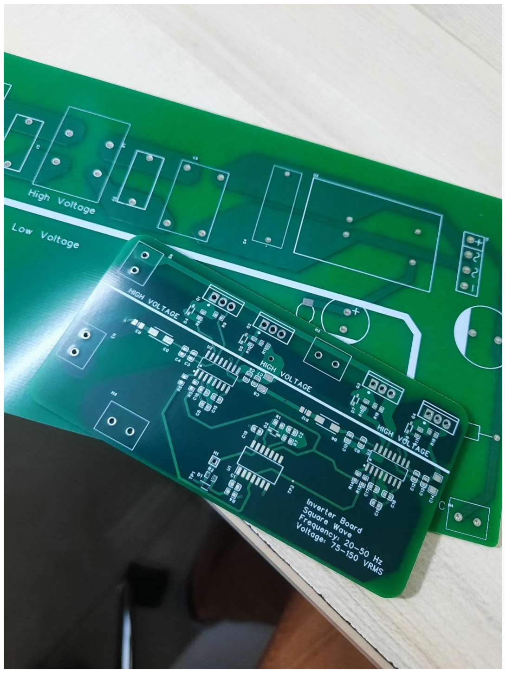
[picture p214: figure]

Figure 5 PCB shipment arrives

# Buck Converter Stage

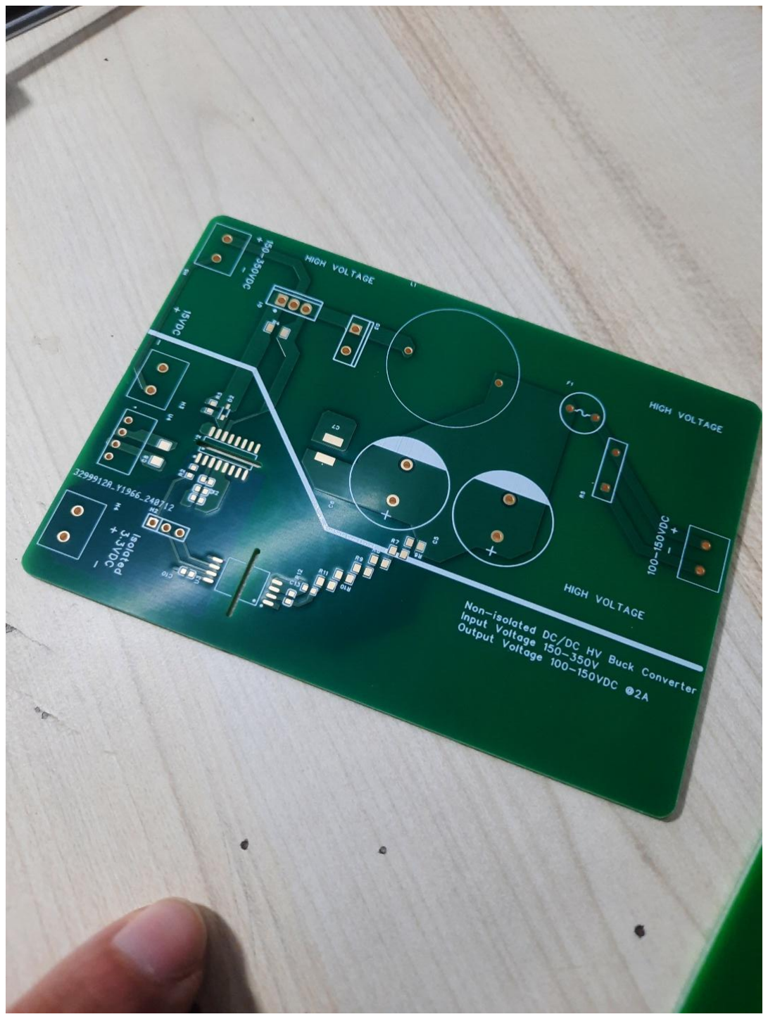
[picture p215: figure]

Figure 6 buck stage PCB

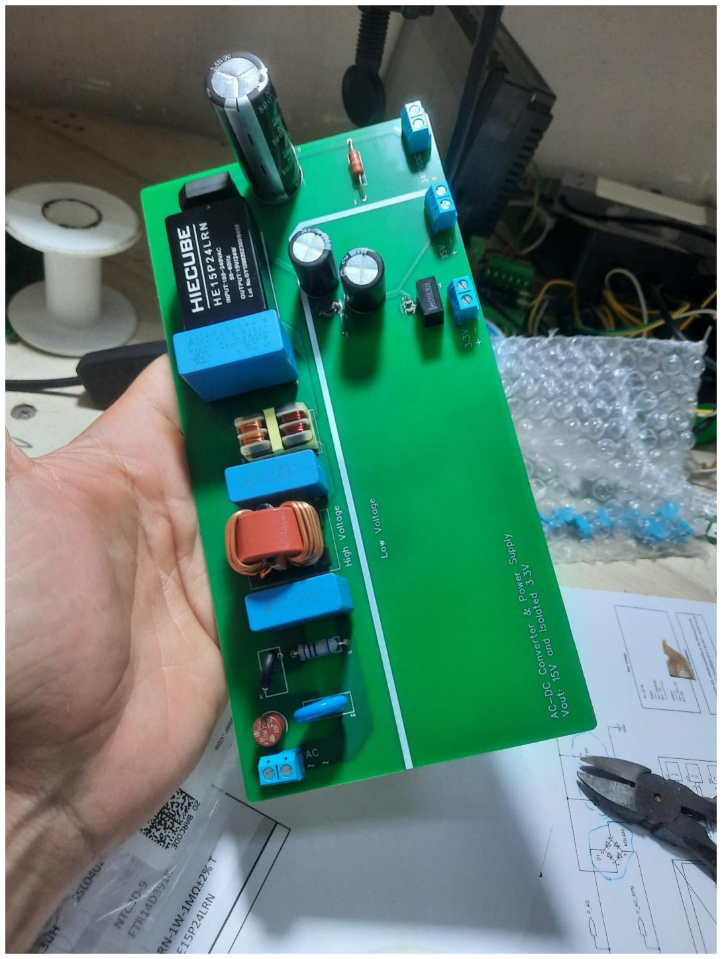
[picture p216: figure]

Figure 7 assembled AC-DC circuit with filers and power supply

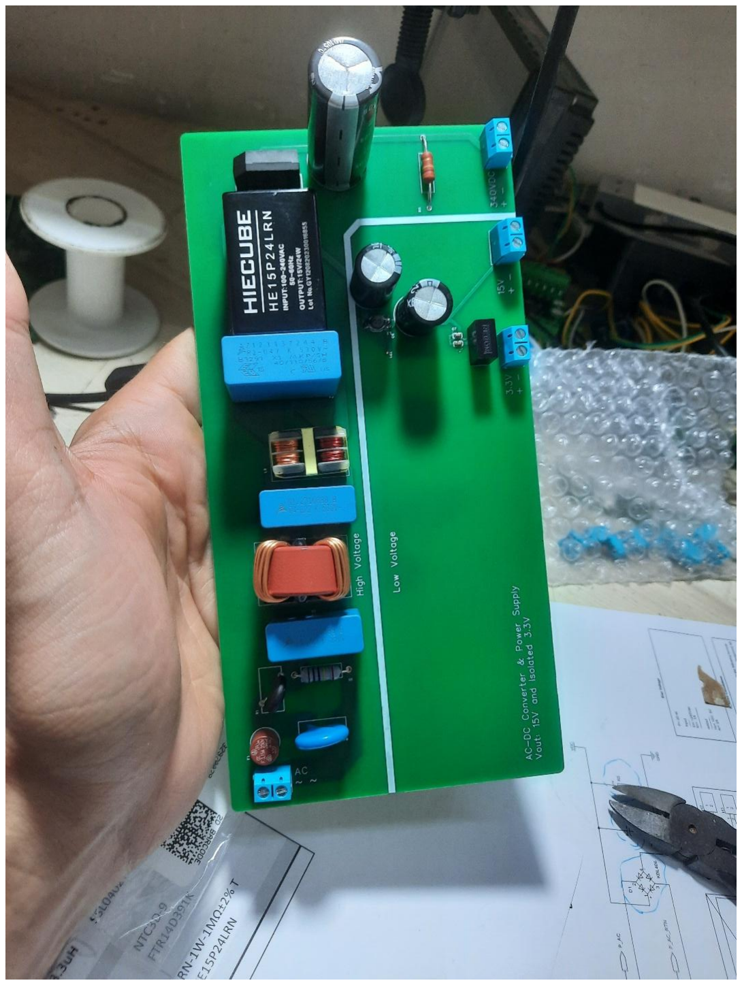
[picture p217: figure]

# Buck Converter Stage

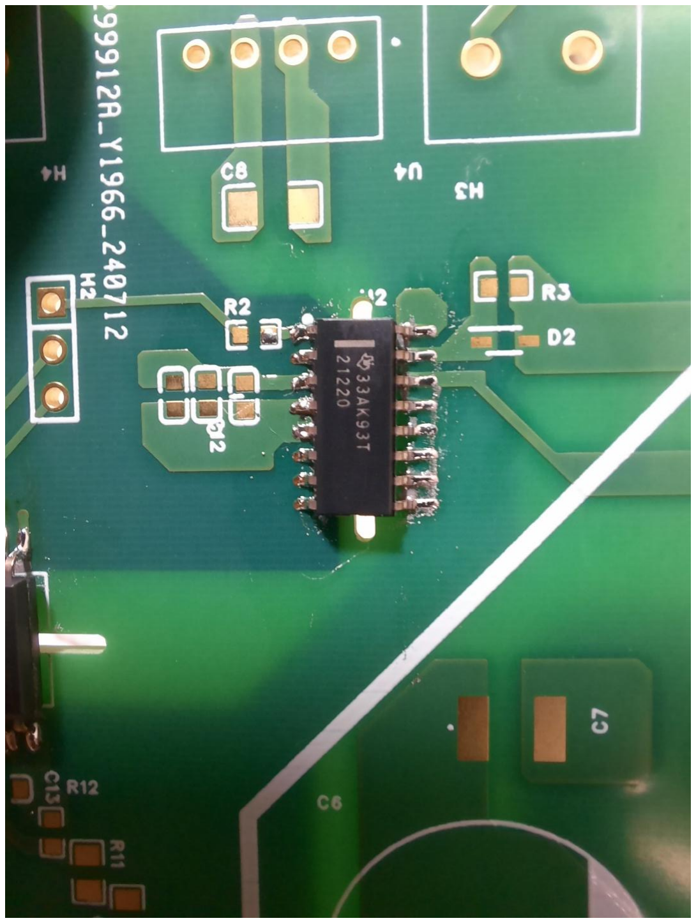
[picture p218: figure]

Figure 8 High Voltage Gate Driver IC

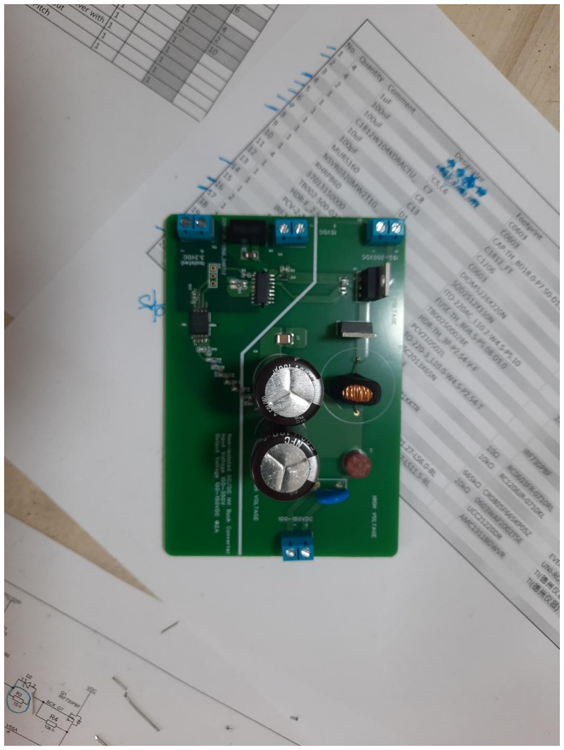
[picture p219: figure]

Figure 9 assembled buck converter and voltage sensing circuit for feedback

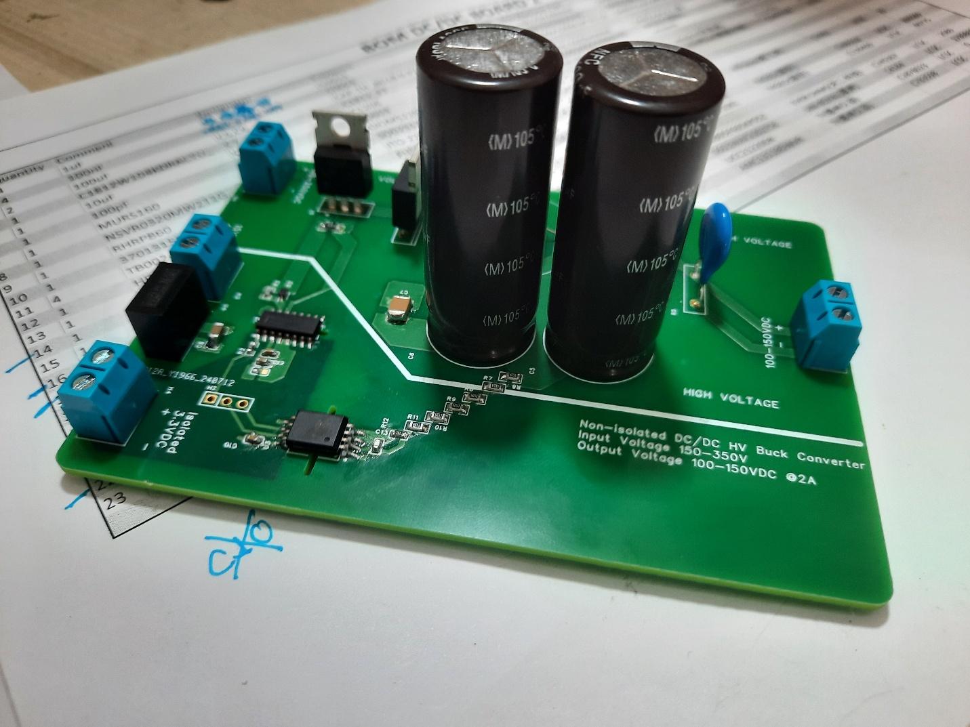
[picture p220: figure]

# Assembled Inverter PCB

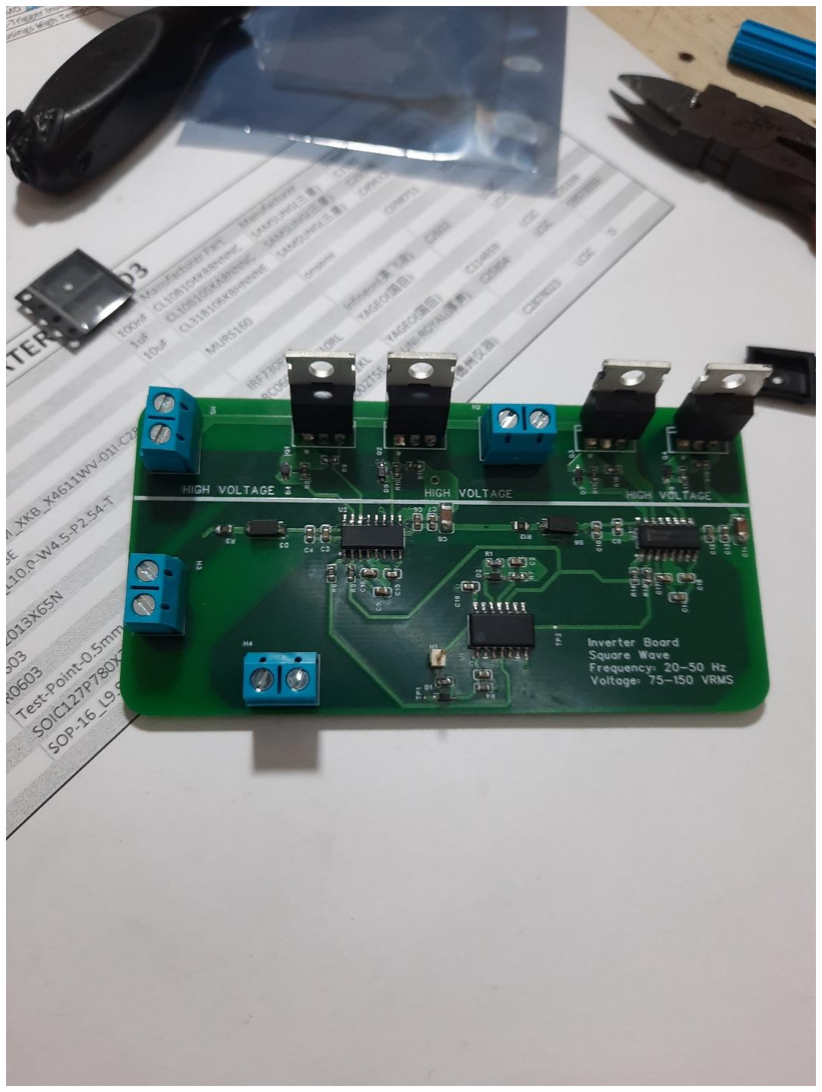
[picture p221: figure]

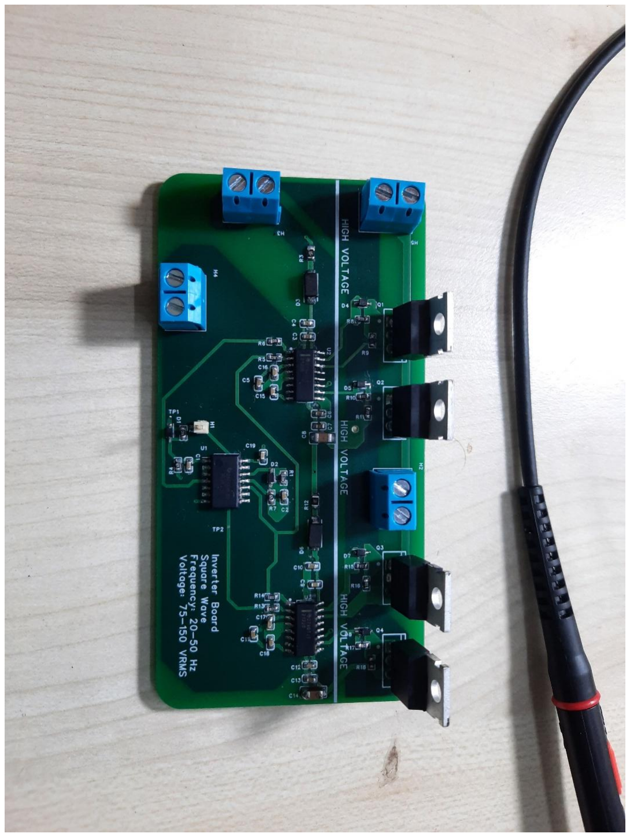
[picture p222: figure]

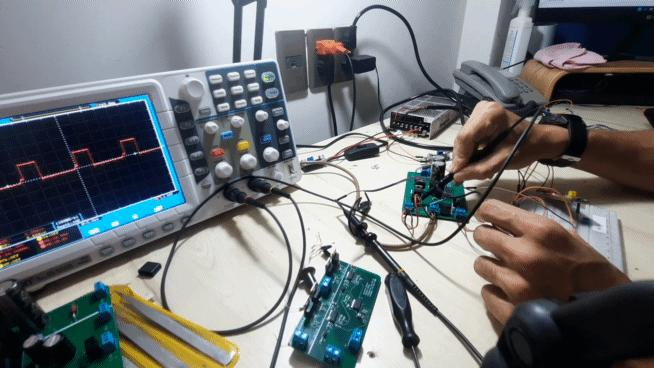
[picture p223: figure]

Figure 10 Testing signal integrity

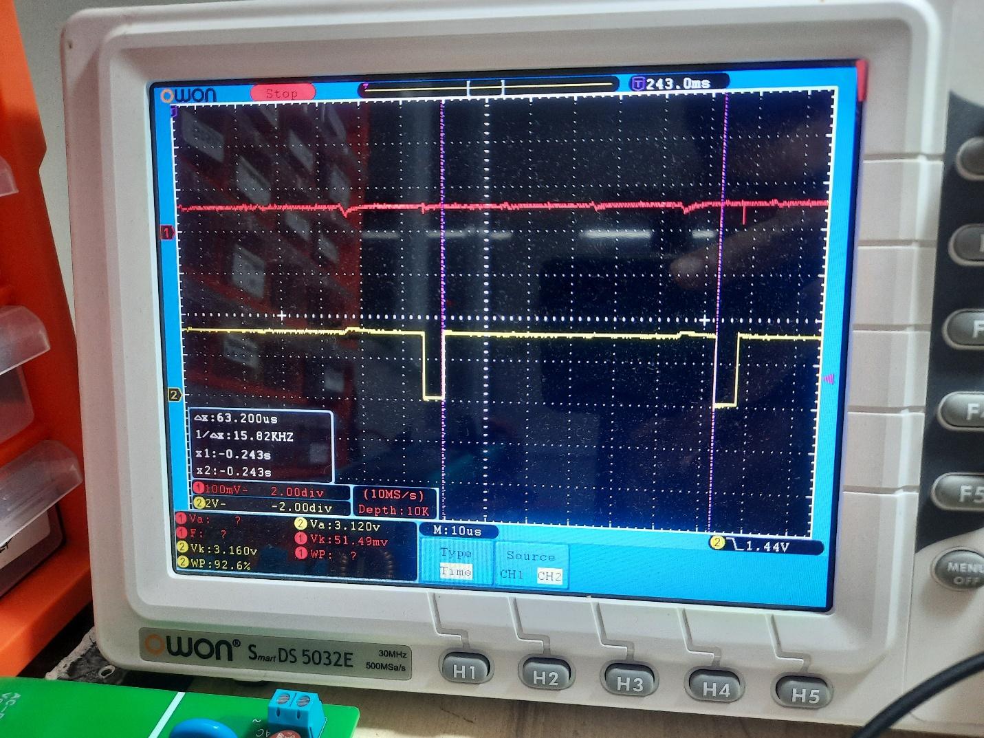
[picture p224: figure]

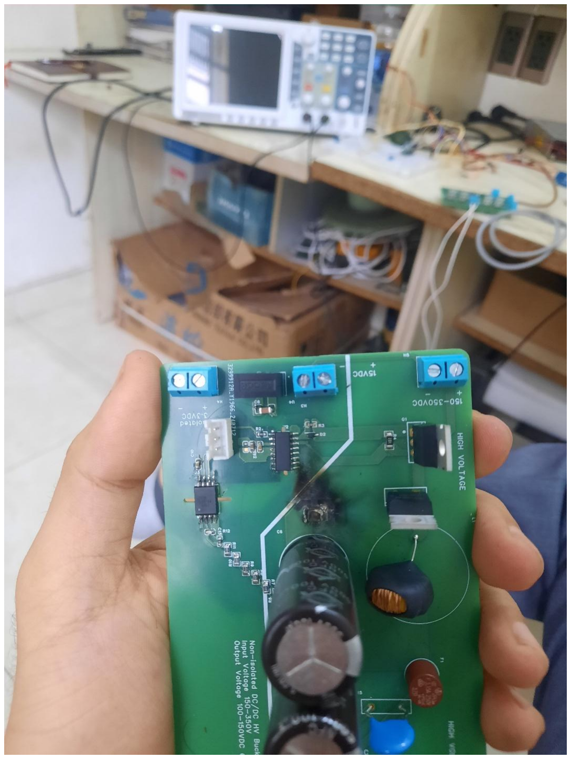
[picture p225: figure]

Figure 11 exploded capacitor: Unexpected Lesson in High-Voltage Creepage and Clearance

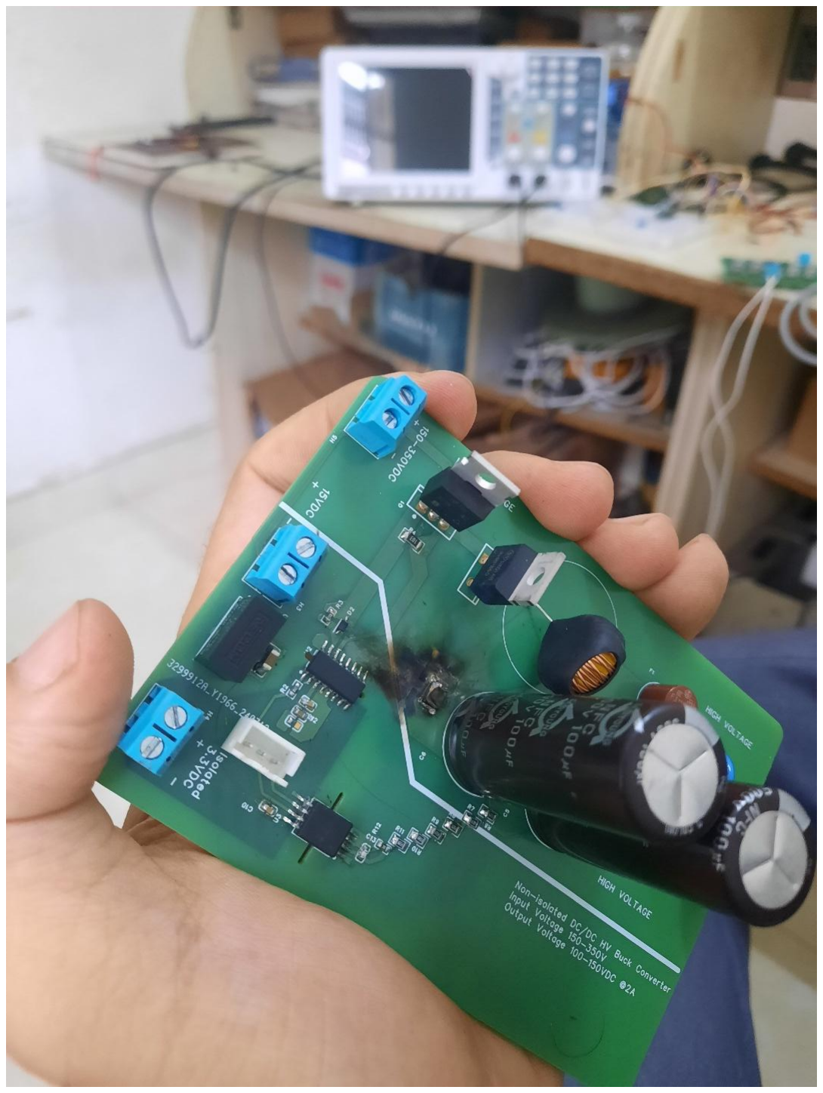
[picture p226: figure]

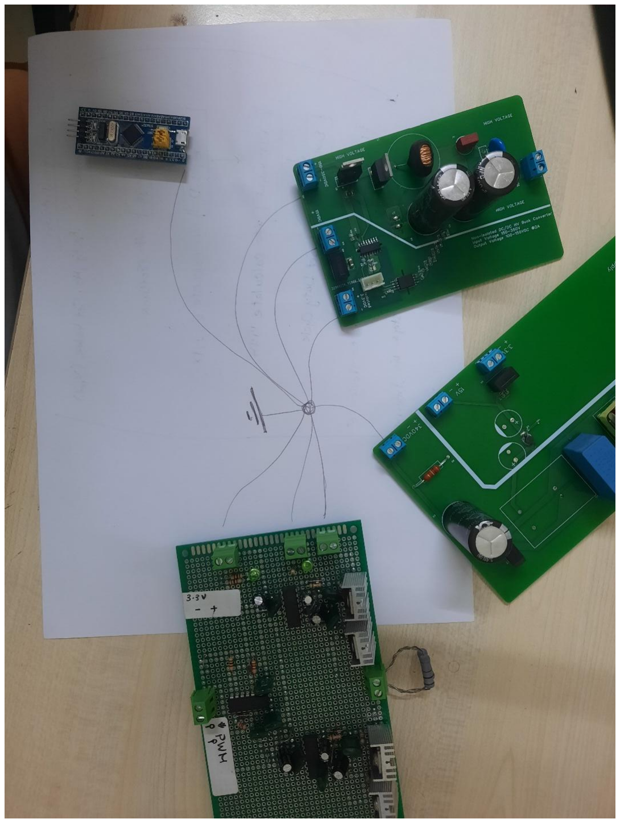
[picture p227: figure]

# Simulation

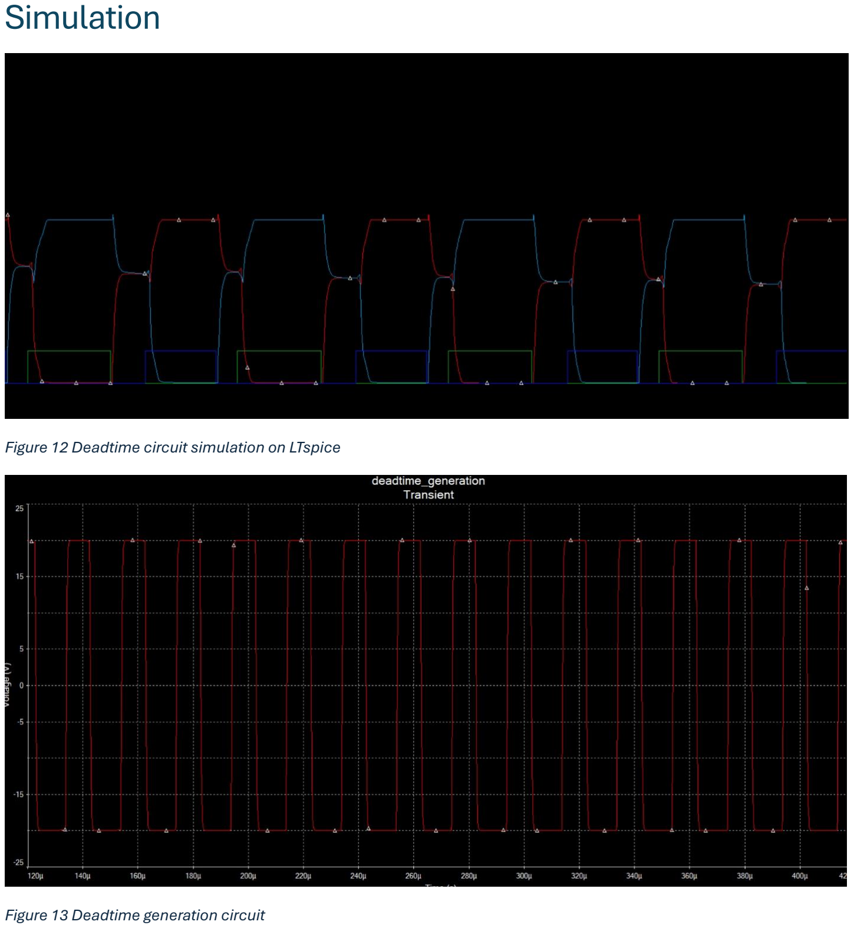
[picture p228: page 32]

Figure 12 Deadtime circuit simulation on LTspice

Figure 13 Deadtime generation circuit
