Little3gy/VFD-Control-System/media/20240617_165302.jpg

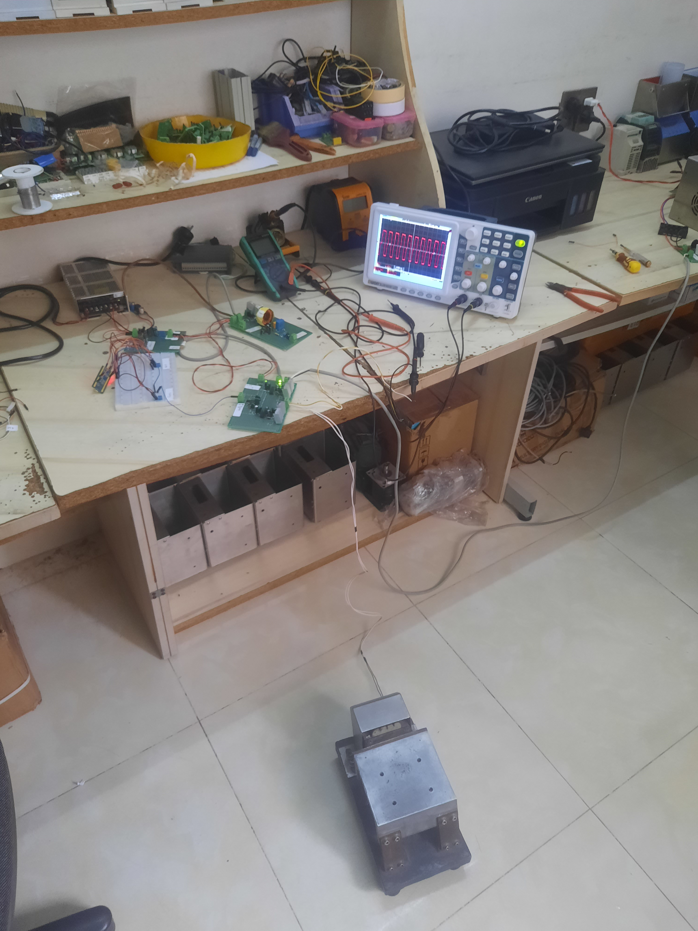
media/20240617_165302.jpg
