Little3gy/VFD-Control-System/media/inverter_PCB_2.jpg

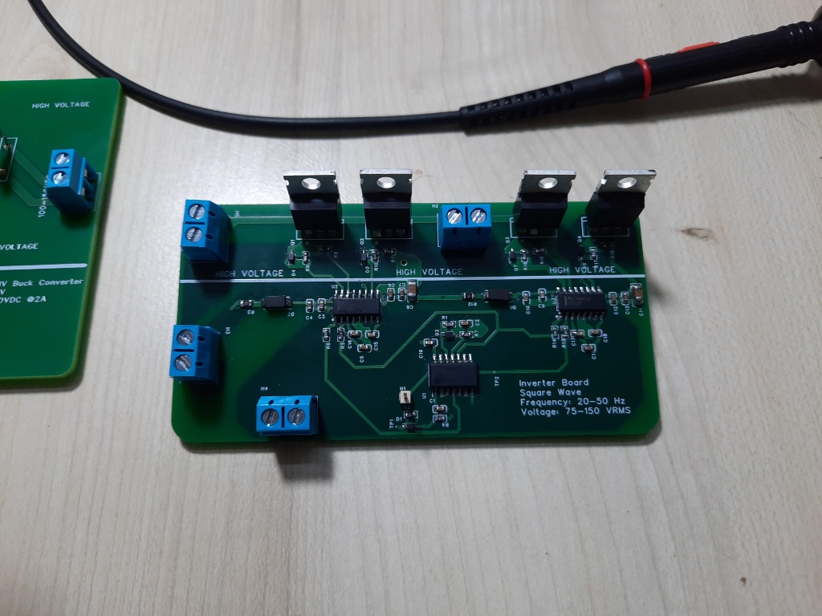
media/inverter_PCB_2.jpg
