Little3gy/VFD-Control-System/hardware/bom/BOM_AC_DC_PS_Schematic1_2024-07-11.xlsx

Sheet: Recovered_Sheet1
BOM AC/DC BOARD1
No. | Quantity | Comment | Designator | Footprint | Value | Manufacturer Part | Manufacturer | Supplier Part | Supplier | JLCPCB Stock
1 | 2 | ECQU2A224ML | C1,C2 | CAP-TH_L17.5-W8.0-P15.00-D1.2 | 0u22 | ECQU2A224ML |  |  | LCSC
2 | 1 | 100uF | C3 | CAP-TH_BD18.0-P7.50-D1.2-FD | 100uF | NFC500V100M18*45 LO | SAMYOUNG(韩国三莹) | C347028 | LCSC | 1126
3 | 1 | 0u47 | C4 | ECQU2A474ML | 0u47
4 | 2 | 2200uF | C5,C6 | CAP-TH_BD13.0-P5.00-D1.2-FD | 2200uF | KM228M025J20RR0VH2FP0 | CX(承兴) | C44598 | LCSC | 27787
5 | 2 | 100nF | C7,C8 | C0603 | 100nF | CC0603KRX7R9BB104 | YAGEO(国巨) | C14663 | LCSC | 32767006
6 | 1 | KBL406 | D1 | KBL_4P-L19.0-W6.3-P5.10 |  | KBL406 | EIC | C2978807 | LCSC | 800
7 | 1 | 37013150000 | F1 | FUSE-TH_BD8.5-P5.08-D1.0 |  | 37013150000 | Littelfuse(美国力特) | C142768 | LCSC | 275
8 | 4 | TB002-500-02BE_ | H1,H2,H3,H4 | TB00250002BE
9 | 1 | 3.3uH | L3 | IND-SMD_L6.6-W4.5_SSL0402T | 3.3uH | SSL0402T-3R3M-N | chilisin(奇力新) | C329862 | LCSC | 3199
10 | 1 | 744824101_ | L8 | 744824101
11 | 1 | 750314978 | L9 | 750314978
12 | 1 | NTC3D-9 | R1 | RES-TH_L13.0-W6.0-P7.50-D0.9-S6.00 |  | NTC3D-9 | SURGING(绍鑫) | C2839614 | LCSC | 4975
13 | 1 | FTR14D391K | R4 | RES-TH_L14.0-W5.0-P7.50-D1.0-S2.00 |  | FTR14D391K | FTR(乔光电子) | C693565 | LCSC | 4165
14 | 1 | PR02000203003JR500_ | R5 | RESAD2760W83L1200D390
16 | 1 | 1MΩ | U1 | RES-TH_BD4.2-L12.0-P16.00-D0.8 | 1MΩ | RN-1W-1MΩ±2% T | CCO(千志电子) | C155727 | LCSC | 1854
17 | 1 | HE15P24LRN | U3 | PWRM-TH_HE15P24LRN |  | HE15P24LRN | HIECUBE(高能立方) | C355003 | LCSC | 6
18 | 1 | RO-153.3S | U4 | RO-153.3S

Sheet: AC-DC assembly
LCSC Part Number | Manufacture Part Number | Manufacturer | Package | Customer # | Description | RoHS | Order Qty. | Min\Mult Order Qty. | Board 1
C347028 | NFC500V100M18*45 LO | SamYoung Electronics | Plugin,D18xL45mm |  | 100uF 500V ±20% Plugin,D18xL45mm Aluminum Electrolytic Capacitors - Leaded ROHS | yes | 3 | 1 | 1
C44598 | KM228M025J20RR0VH2FP0 | CX(Dongguan Chengxing Elec) | Plugin,D13xL20mm |  | 2200uF 25V ±20% Plugin,D13xL20mm Aluminum Electrolytic Capacitors - Leaded ROHS | yes | 5 | 5 | 2
C2978807 | KBL406 | EIC Semicon | KBL |  | 200A 1.1V@4A 4A 600V KBL Bridge Rectifiers ROHS | yes | 1 | 1 | 1
C329862 | SSL0402T-3R3M-N | Chilisin Elec | SMD |  | 2A 3.3uH ±20% 2A SMD Power Inductors ROHS | yes | 5 | 5 | 1
C693565 | FTR14D391K | FTR | Plugin |  | 650V 320V 250V 351V~429V Plugin Varistors ROHS | yes | 5 | 5 | 1
C155727 | RN-1W-1MΩ±2% T | CCO(Chian Chia Elec) | Plugin,D4.2xL11.5mm |  | 1MΩ 1W ±250ppm/℃ ±2% Plugin,D4.2xL11.5mm Through Hole Resistors ROHS | yes | 10 | 10 | 1
C355003 | HE15P24LRN | HIECUBE | Plugin |  | Plugin Isolated Power Modules ROHS | yes | 1 | 1 | 1
C2839614 | 10D-11 | SURGING | Plugin,P=7.5mm |  | 10Ω 3A 2800K Plugin,P=7.5mm NTC Thermistors ROHS | yes | 10 | 10 | 1
Mouser | Mã của Mouse | Số nhà sản xuất | Nhà sản xuất | Mã khách hàng | Mô tả | RoHS | Tuổi thọ | Số lượng Đặt hàng | Board 1
1 | 603-CC603KRX7R9BB104 | CC0603KRX7R9BB104 | YAGEO |  | Multilayer Ceramic Capacitors MLCC - SMD/SMT 50 V 0.1uF X7R 0603 10% | Tuân thủ RoHS |  | 2 | 2
2 | 576-37013150000 | 37013150000 | Littelfuse |  | Fuses with Leads - Through Hole 250V IEC LL 3.15A TR5 | Tuân thủ RoHS |  | 2 | 1
3 | 490-TB002-500-02BE | TB002-500-02BE | CUI Devices |  | Fixed Terminal Blocks Terminal block, screw type, 5.00, horizontal, 2 poles, CUI Blue, slotted screw, PCB mount | Tuân thủ RoHS |  | 12 | 4
4 | 710-744824101 | 744824101 | Wurth Elektronik |  | Common Mode Chokes / Filters 1 mH 10A 7mOhm | Tuân thủ RoHS |  | 1 | 1
5 | 710-750314978 | 750314978 | Wurth Elektronik |  | Common Mode Chokes / Filters MID-DC16US THT 10mH EE16.5/6.5/9 | Tuân thủ RoHS |  | 1 | 1
6 | 919-RO-153.3S | RO-153.3S | RECOM |  | Isolated DC/DC Converters - Through Hole 1W DC/DC 1kV UNREG 15Vin 3.3Vout | Tuân thủ RoHS |  | 1 | 1
21 | 594-5083NW300K0J | PR02000203003JR500 | Vishay |  | Metal Film Resistors - Through Hole 2watts 300Kohms 5% | Tuân thủ RoHS |  | 1 | 1
22 | 871-B32913B5224K | B32913B5224K | TDK |  | Safety Capacitors 0.22uF 530Vac X1 MKP 10% LS=22.5mm | Tuân thủ RoHS |  | 2 | 2
23 | 871-B32914B5474K | B32914B5474K | TDK |  | Safety Capacitors 0.47uF 530Vac X1 MKP 10% LS=27.5mm | Tuân thủ RoHS |  | 1 | 1
