Little3gy/VFD-Control-System/hardware/bom/BOM_DC_AC_Schematic4_2024-07-11.xlsx

Sheet: Recovered_Sheet1
BOM DC/AC INVERTER BOARD3
No. | Quantity | Comment | Designator | Footprint | Value | Manufacturer Part | Manufacturer | Supplier Part | Supplier | JLCPCB Stock
1 | 11 | 100nF | C1,C2,C3,C6,C9,C12,C15,C16,C17,C18,C19 | C0603 | 100nF | CL10B104KB8NNNC | SAMSUNG(三星) | C1591 | LCSC | 23189831
2 | 6 | 1uF | C4,C5,C7,C10,C11,C13 | C0603 | 1uF | CL10B105KA8NNNC | SAMSUNG(三星) | C29936 | LCSC | 1077602
3 | 2 | 10uF | C8,C14 | C1206 | 10uF | CL31B106KBHNNNE | SAMSUNG(三星) | C89632 | LCSC | 1100864
4 | 6 | NSVR0320MW2T1G_ | D1,D2,D4,D5,D7,D8 | SOD2512X110N
5 | 2 | MURS160 | D3,D6 | DIOM5226X220N |  | MURS160 | onsemi | C698751 | LCSC | 1640
6 | 1 | HDR-M_2.54_1x1P | H1 | HDR-TH_1P-V-M_XKB_X4611WV-01I-C28D40
7 | 4 | TB002-500-02BE_ | H2,H3,H4,H5 | TB00250002BE
8 | 4 | IRF730PBF | Q1,Q2,Q3,Q4 | TO-220-3_L10.0-W4.5-P2.54-T |  | IRF730PBF | Infineon(英飞凌) | C2602 | LCSC | 21
9 | 10 | 10R | R1,R2,R5,R6,R8,R10,R13,R14,R15,R17 | R0603 | 10R | RC0603FR-0710RL | YAGEO(国巨) |  | LCSC
10 | 2 | 4R3 | R3,R12 | RESC2013X65N | 4R3
11 | 2 | 12kΩ | R4,R7 | R0603 | 12kΩ | RC0603FR-0712KL | YAGEO(国巨) | C114659 | LCSC | 235339
12 | 4 | 10kΩ | R9,R11,R16,R18 | R0603 | 10kΩ | 0603WAF1002T5E | UNI-ROYAL(厚声) | C25804 | LCSC | 59573033
13 | 2 | Test-Point | TP1,TP2 | Test-Point-0.5mm
14 | 1 | SN74HC14NSRE4_ | U1 | SOIC127P780X200-14N
15 | 2 | UCC21220DR | U2,U3 | SOP-16_L9.9-W3.9-P1.27-LS6.0-BL |  | UCC21220DR | TI(德州仪器) | C2878023 | LCSC | 0

Sheet: Assembly
LCSC Part Number | Manufacture Part Number | Manufacturer | Package | Description | Order Qty. | Board 3
C89632 | CL31B106KBHNNNE | Samsung Electro-Mechanics | 1206 | 50V 10uF X7R ±10% 1206 Multilayer Ceramic Capacitors MLCC - SMD/SMT ROHS | 10 | 2
C11751 | RHRP860 | onsemi | ITO-220AC | 2.1V@8A 35ns Single 8A 600V ITO-220AC Fast Recovery / High Efficiency Diodes ROHS | 1
C698751 | MURS160 | Yangzhou Yangjie Elec Tech | SMA(DO-214AC) | 1.25V@1A 50ns Single 1A 600V SMA(DO-214AC) Fast Recovery / High Efficiency Diodes ROHS | 10 | 2
C114659 | RC0603FR-0712KL | YAGEO | 603 | 100mW Thick Film Resistors 75V ±100ppm/℃ ±1% 12kΩ 0603 Chip Resistor - Surface Mount ROHS | 100 | 2
C25804 | 0603WAF1002T5E | UNI-ROYAL(Uniroyal Elec) | 603 | 100mW Thick Film Resistors 75V ±100ppm/℃ ±1% 10kΩ 0603 Chip Resistor - Surface Mount ROHS | 100 | 4
C2878023 | UCC21220DR | Texas Instruments | SOIC-16 | SOIC-16 Isolators - Gate Drivers ROHS | 2 | 2
 | Số nhà sản xuất | Nhà sản xuất | Mã khách hàng | Mô tả | Số lượng Đặt hàng | Board 3
3 | TB002-500-02BE | CUI Devices |  | Fixed Terminal Blocks Terminal block, screw type, 5.00, horizontal, 2 poles, CUI Blue, slotted screw, PCB mount | 12 | 4
7 | CL10B105KA8NNNC | Samsung Electro-Mechanics |  | Multilayer Ceramic Capacitors MLCC - SMD/SMT 1uF+/-10% 25V X7R 1608 | 10 | 6
8 | CL10B104KB8NNNC | Samsung Electro-Mechanics |  | Multilayer Ceramic Capacitors MLCC - SMD/SMT 100nF+/-10% 50V X7R 0603 | 15 | 11
11 | NSVR0320MW2T1G | onsemi |  | Schottky Diodes & Rectifiers SMALL SIG SCHOTTKY | 7 | 6
13 | IRF730PBF | Vishay |  | MOSFETs 400V N-CH HEXFET | 5 | 4
14 | SDR10EZPF4R30 | ROHM Semiconductor |  | Thick Film Resistors - SMD | 3 | 2
15 | RC0603FR-0710RL | YAGEO |  | Thick Film Resistors - SMD 10 Ohms 100mW 0603 1% | 12 | 10
20 | SN74HC14NSRE4 | Texas Instruments |  | Inverters Hex Schmitt-Trigger Inverters | 1 | 1
25 | HTSW-101-14-L-S | Samtec |  | Headers & Wire Housings High Temperature PCB Header Strips, 0.100" pitch | 1 | 1
