Little3gy/VFD-Control-System/hardware/bom/BOM_DC_DC_Schematic3_2024-07-11.xlsx

Sheet: Recovered_Sheet1
BOM DC/DC BOARD 2
No. | Quantity | Comment | Designator | Footprint | Value | Manufacturer Part | Manufacturer | Supplier Part | Supplier | JLCPCB Stock
1 | 4 | 1uF | C1,C3,C9,C10 | C0603 | 1uF | CL10B105KA8NNNC | SAMSUNG(三星) | C29936 | LCSC | 1077602
2 | 4 | 100nF | C2,C4,C11,C12 | C0603 | 100nF | CL10B104KB8NNNC | SAMSUNG(三星) | C1591 | LCSC | 23189831
3 | 2 | 100uF | C5,C6 | CAP-TH_BD18.0-P7.50-D1.2-FD | 100uF | NFC500V100M18*45 LO | SAMYOUNG(韩国三莹) | C347028 | LCSC | 1126
4 | 1 | C1812W104KDRACTU_ | C7 | C1812_FT
5 | 1 | 10uF | C8 | C1206 | 10uF | CL31B106KBHNNNE | SAMSUNG(三星) | C89632 | LCSC | 1100864
6 | 1 | 100pF | C13 | C0603 | 100pF | CC0603KRX7R9BB101 | YAGEO(国巨) | C160903 | LCSC | 117185
7 | 1 | MURS160 | D1 | DIOM5226X220N |  | MURS160 | onsemi | C698751 | LCSC | 1640
8 | 1 | NSVR0320MW2T1G_ | D2 | SOD2512X110N
9 | 1 | RHRP860 | D3 | ITO-220AC_L10.2-W4.5-P5.10 |  | RHRP860 | onsemi(安森美) | C11751 | LCSC | 6245
10 | 1 | 37013150000 | F1 | FUSE-TH_BD8.5-P5.08-D1.0 |  | 37013150000 | Littelfuse(美国力特) | C142768 | LCSC | 275
11 | 4 | TB002-500-02BE_ | H1,H3,H4,H5 | TB00250002BE
12 | 1 | HDR-F_2.54_1x3P | H2 | HDR-TH_3P-P2.54-V-F
13 | 1 | PCV-2-105-02L_ | L1 | PCV210502L
14 | 1 | IRF730PBF | Q1 | TO-220-3_L10.0-W4.5-P2.54-T |  | IRF730PBF | Infineon(英飞凌) | C2602 | LCSC | 21
15 | 1 | SDR10EZPF4R30_ | R1 | RESC2013X65N
16 | 2 | 10Ω | R2,R3 | R0603 | 10Ω | RC0603FR-0710RL | YAGEO(国巨) | C109318 | LCSC | 286569
17 | 1 | 10kΩ | R4 | R1206 | 10kΩ | RC1206JR-0710KL | YAGEO(国巨) | C136460 | LCSC | 60775
18 | 1 | MOV-10D181KKTR_ | R5 | MOV10D181KKTR
19 | 6 | 665kΩ | R6,R7,R8,R9,R10,R11 | R0805 | 665kΩ | CR0805F665KP05Z | EVER OHMS(天二科技) | C245367 | LCSC | 2080
20 | 1 | 20kΩ | R12 | R0603 | 20kΩ | 0603WAF2002T5E | UNI-ROYAL(厚声) | C4184 | LCSC | 1789865
21 | 1 | UCC21220DR | U2 | SOP-16_L9.9-W3.9-P1.27-LS6.0-BL |  | UCC21220DR | TI(德州仪器) | C2878023 | LCSC | 0
22 | 1 | AMC1311BDWVR | U3 | SOIC-8_L7.5-W5.9-P1.27-LS11.5-BL |  | AMC1311BDWVR | TI(德州仪器) | C783598 | LCSC | 5527
23 | 1 | RO-1505S | U4 | RO1505S

Sheet: DC-DC Assembly
LCSC Part Number | Manufacture Part Number | Manufacturer | Package | Description | Order Qty. | Board 1 | Board 2 | Board 3
C245367 | CR0805F665KP05Z | Ever Ohms Tech | 805 | 125mW Thick Film Resistors 150V ±100ppm/℃ ±1% 665kΩ 0805 Chip Resistor - Surface Mount ROHS | 50 |  | 6
C783598 | AMC1311BDWVR | Texas Instruments | SOIC-8-300mil | SOIC-8-300mil Special Purpose Amplifiers ROHS | 1 |  | 1
C160903 | CC0603KRX7R9BB101 | YAGEO | 603 | 50V 100pF X7R ±10% 0603 Multilayer Ceramic Capacitors MLCC - SMD/SMT ROHS | 100 |  | 1
C347028 | NFC500V100M18*45 LO | SamYoung Electronics | Plugin,D18xL45mm | 100uF 500V ±20% Plugin,D18xL45mm Aluminum Electrolytic Capacitors - Leaded ROHS | 3 | 1 | 2
C89632 | CL31B106KBHNNNE | Samsung Electro-Mechanics | 1206 | 50V 10uF X7R ±10% 1206 Multilayer Ceramic Capacitors MLCC - SMD/SMT ROHS | 10 |  | 1 | 2
C11751 | RHRP860 | onsemi | ITO-220AC | 2.1V@8A 35ns Single 8A 600V ITO-220AC Fast Recovery / High Efficiency Diodes ROHS | 1 |  | 1
C4184 | 0603WAF2002T5E | UNI-ROYAL(Uniroyal Elec) | 603 | 100mW Thick Film Resistors 75V ±100ppm/℃ ±1% 20kΩ 0603 Chip Resistor - Surface Mount ROHS | 100 |  | 1
Mouser | Manufacture Part Number | Manufacturer
2 | 37013150000 | Littelfuse |  | Fuses with Leads - Through Hole 250V IEC LL 3.15A TR5 | 2 | 1 | 1
3 | TB002-500-02BE | CUI Devices |  | Fixed Terminal Blocks Terminal block, screw type, 5.00, horizontal, 2 poles, CUI Blue, slotted screw, PCB mount | 12 | 4 | 4 | 4
7 | CL10B105KA8NNNC | Samsung Electro-Mechanics |  | Multilayer Ceramic Capacitors MLCC - SMD/SMT 1uF+/-10% 25V X7R 1608 | 10 |  | 4 | 6
8 | CL10B104KB8NNNC | Samsung Electro-Mechanics |  | Multilayer Ceramic Capacitors MLCC - SMD/SMT 100nF+/-10% 50V X7R 0603 | 15 |  | 4 | 11
9 | C1812W104KDRACTU | KEMET |  | Multilayer Ceramic Capacitors MLCC - SMD/SMT 1kV 0.1uF X7R 1812 10% Flex Soft | 1 |  | 1
10 | MURS160 | Diodes Incorporated |  | Rectifiers FRED GPP Rectifier SMB T&R 3K | 1 |  | 1
11 | NSVR0320MW2T1G | onsemi |  | Schottky Diodes & Rectifiers SMALL SIG SCHOTTKY | 7 |  | 1 | 6
12 | PCV-2-105-02L | Coilcraft |  | Power Inductors - Leaded 1 mH UnShld 10% 2.3A 370mOhms | 1 |  | 1
13 | IRF730PBF | Vishay |  | MOSFETs 400V N-CH HEXFET | 5 |  | 1 | 4
14 | SDR10EZPF4R30 | ROHM Semiconductor |  | Thick Film Resistors - SMD | 3 |  | 1 | 2
15 | RC0603FR-0710RL | YAGEO |  | Thick Film Resistors - SMD 10 Ohms 100mW 0603 1% | 12 |  | 2 | 10
16 | RC1206JR-0710KL | YAGEO |  | Thick Film Resistors - SMD 10 kOhms 250 mW 1206 5% | 1 |  | 1
17 | MOV-10D181KKTR | Bourns |  | Varistors 10mm Radial Disc MOV - Kinked Leads, T&R | 1 |  | 1
18 | UCC21220DR | Texas Instruments |  | Galvanically Isolated Gate Drivers 3.0kVrms, 4A/6A dual-channel isolated gate driver with disable pin & 8V UVLO for MOSFETs & GaNFETs 16-SOIC -40 to 125 | 1 |  | 1
19 | RO-1505S | RECOM |  | Isolated DC/DC Converters - Through Hole 1W DC/DC 1kV UNREG 15Vin 5Vout | 1 |  | 1
24 | TMS-103-02-G-S | Samtec |  | Headers & Wire Housings Through-hole Micro Header, 0.050" x 0.100" Pitch | 1 |  | 1
