Little3gy/VFD-Control-System/media/buck_assembled_PCB.jpg

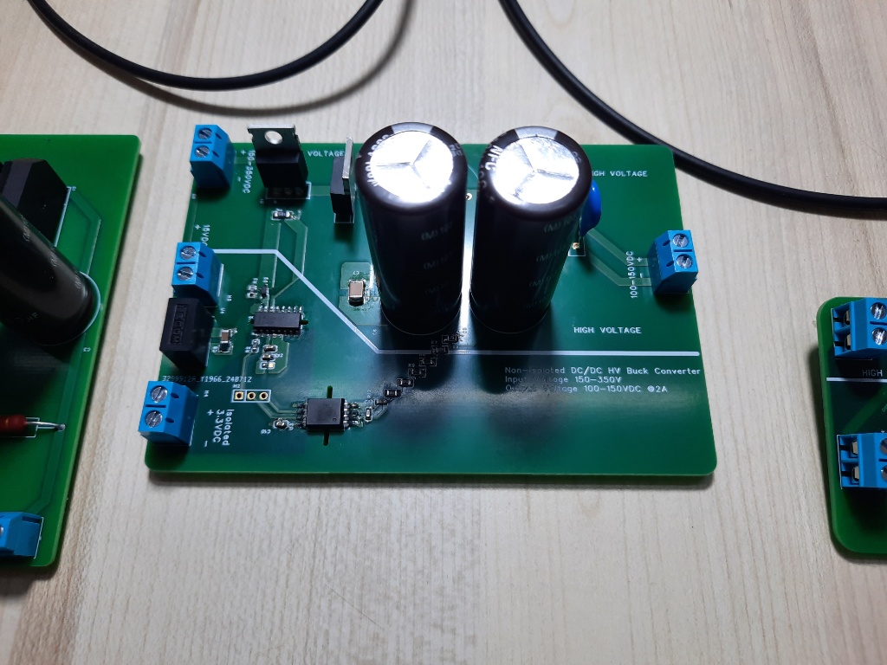
media/buck_assembled_PCB.jpg
