Little3gy/VFD-Control-System/media/buck_assembled_PCB_2.jpg

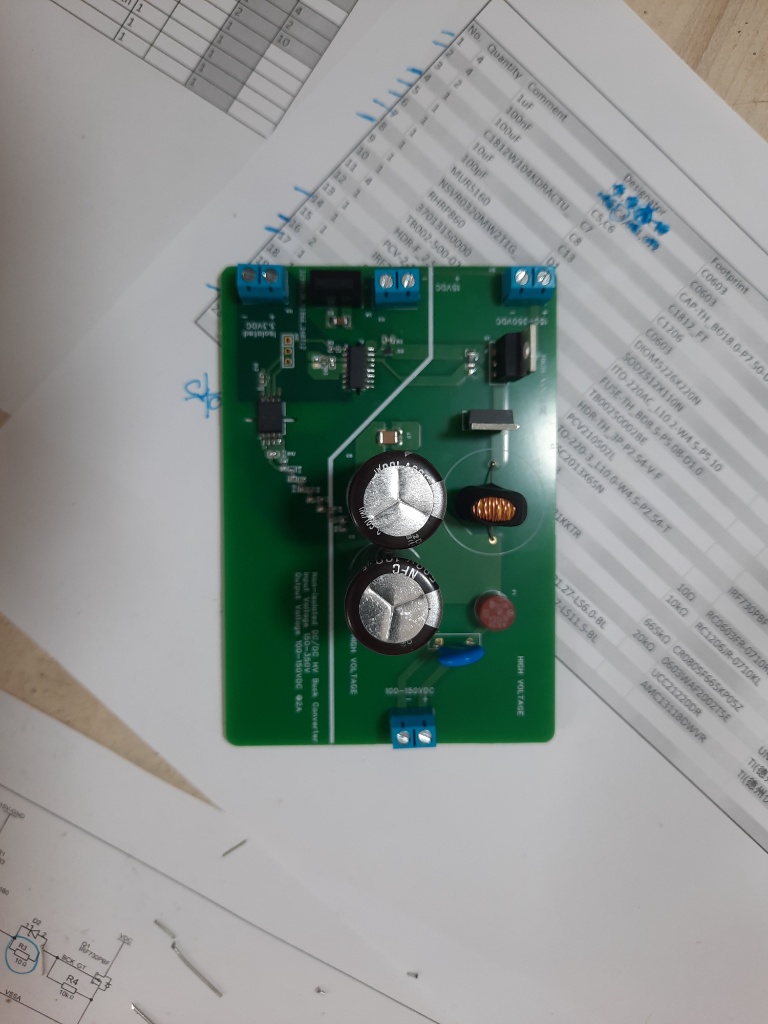
media/buck_assembled_PCB_2.jpg
