Little3gy/VFD-Control-System/hardware/schematics/VFD_v3.0_PowerStage_HV_Schematic.pdf.pdf

# Filter & Protection AC input - Rectification

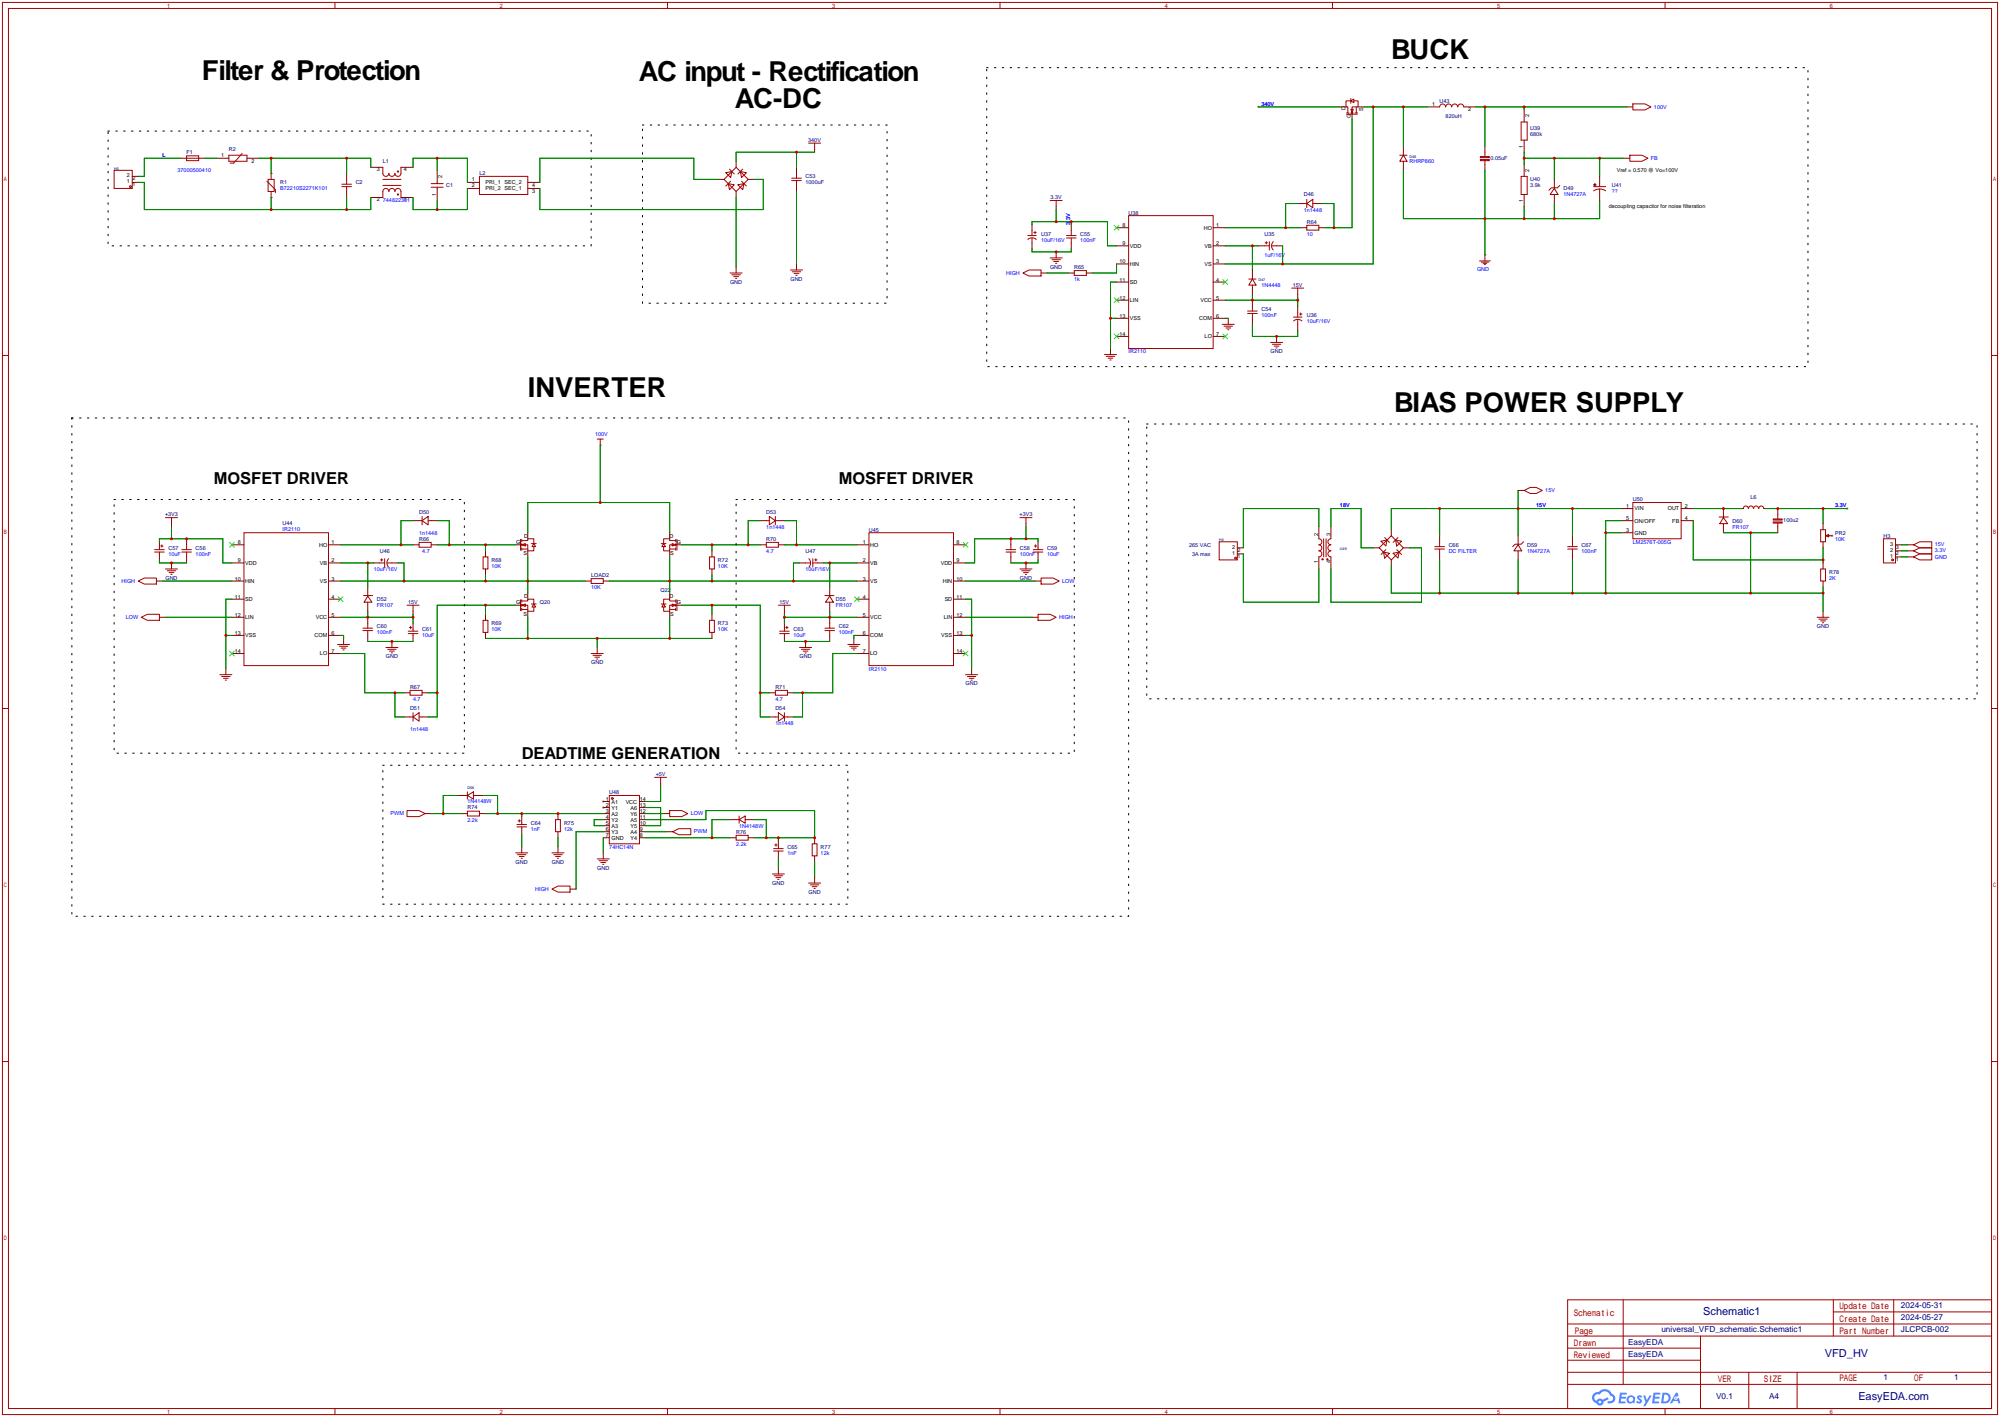
[picture p233: page 1]

decoupling capacitor for noise filteration
