Little3gy/VFD-Control-System/hardware/schematics/VFD_v3.0_ControlBoard_LV_Schematic.pdf.pdf

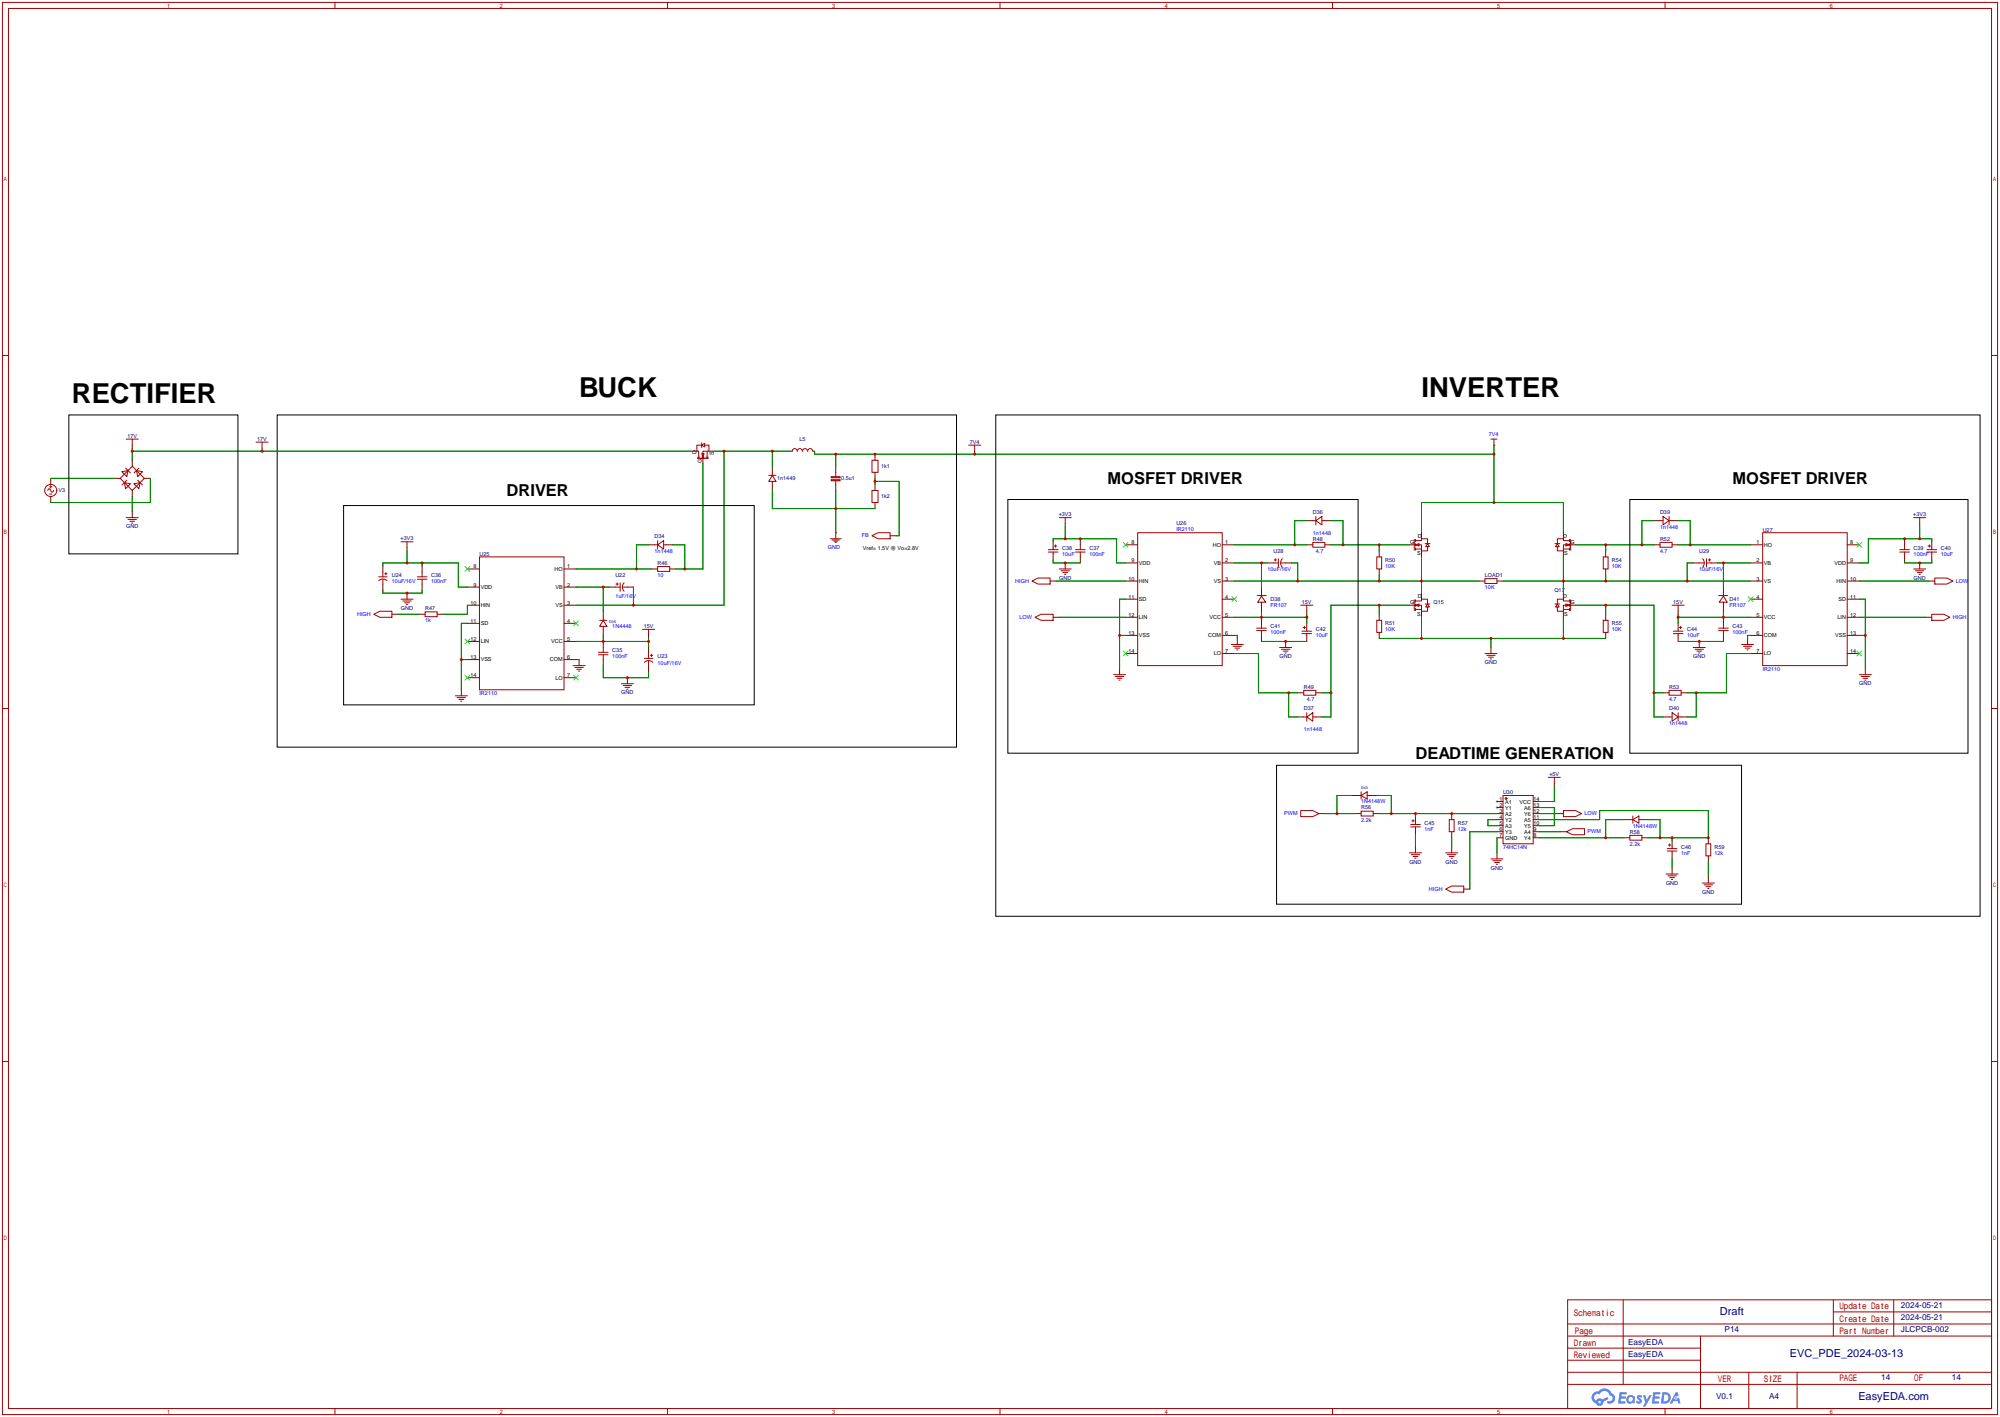
[picture p234: page 1]
