Little3gy/VFD-Control-System/hardware/schematics/VFD_v3.0_DCAC_InverterStage_Schematic.pdf.pdf

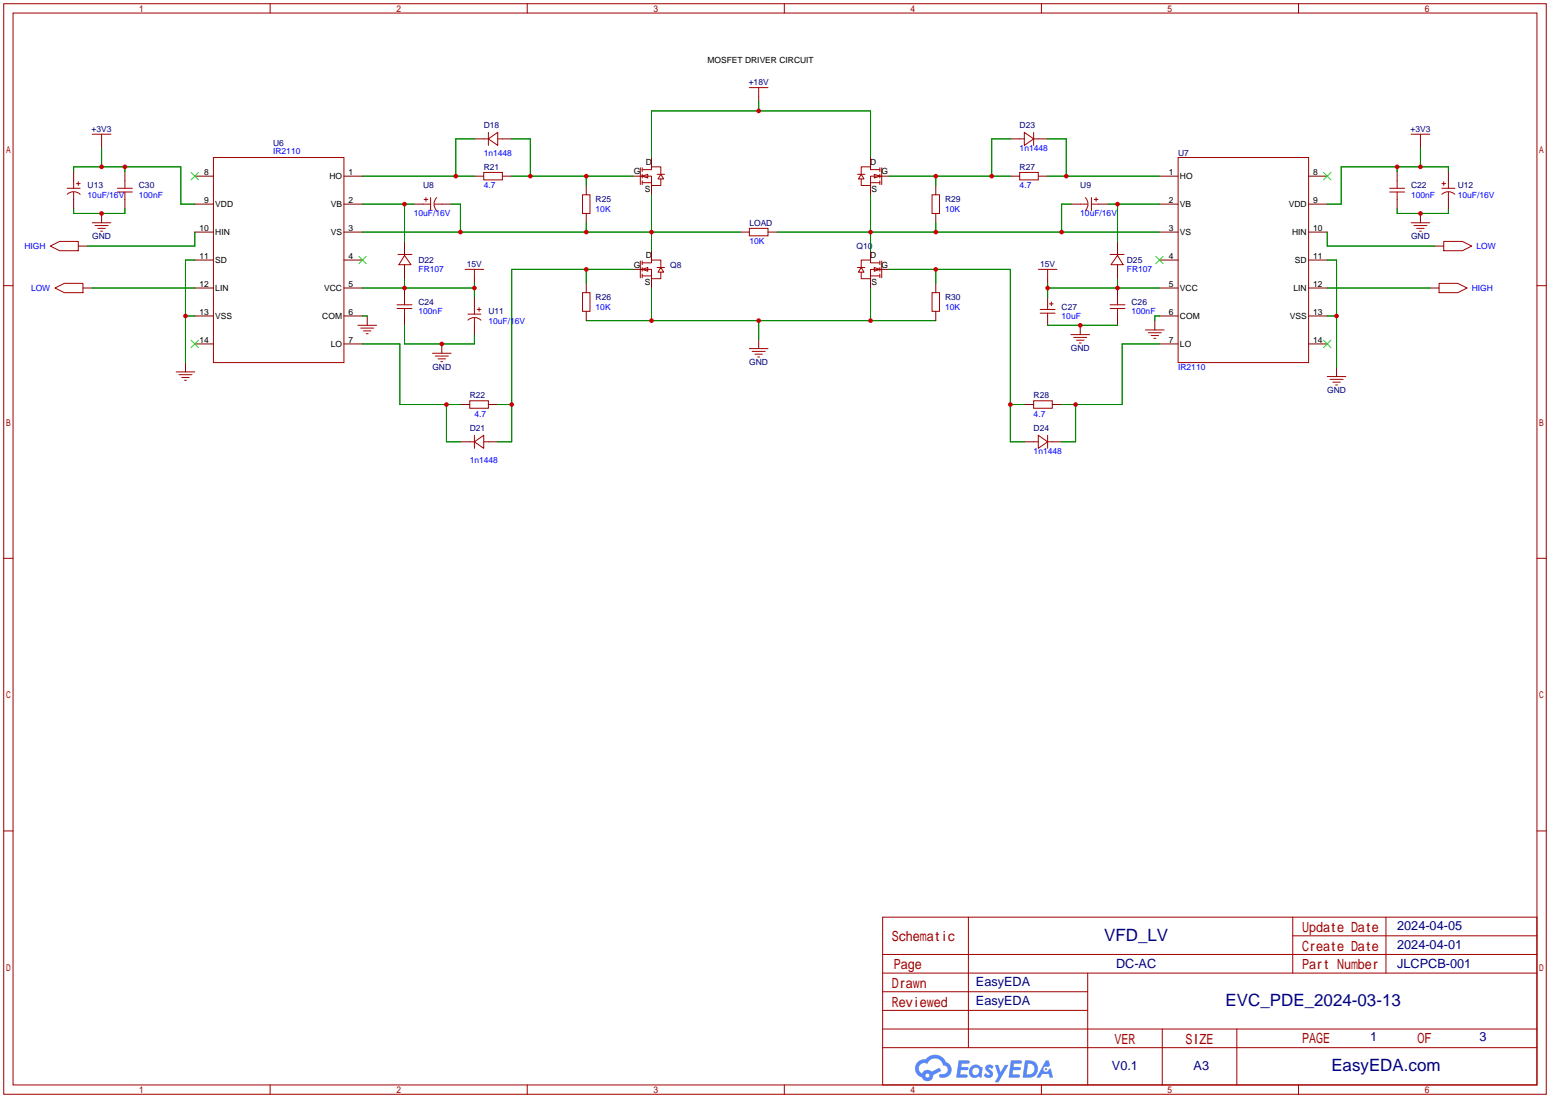
[picture p235: page 1]
