Little3gy/VFD-Control-System/hardware/schematics/VFD_v3.0_DCDC_BuckConverter_Schematic.pdf.pdf

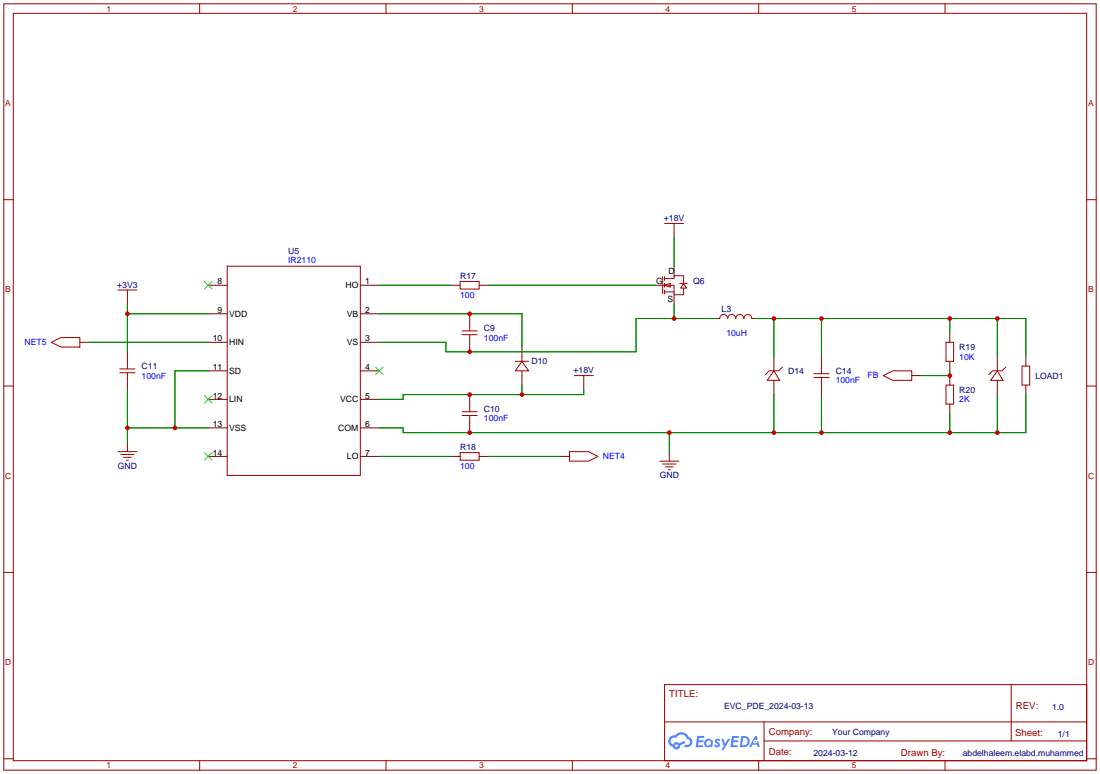
[picture p236: page 1]
