Little3gy/VFD-Control-System/firmware/buck_controller/Core/Src/main.c

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
/* Includes ------------------------------------------------------------------*/
#include "main.h"

/* USER CODE BEGIN PD */
#define ADC_BUF_LEN 2

#define R1 3.990e6f //12k
#define R2 20.0e3f //2k
#define DESIRED_VOLTAGE 5.0f   // Input the desired voltage

float measuredVoltageCh1, measuredVoltageCh2, normalizedVoltage,
		differentialVoltage;

uint16_t duration_cycles, end_cycle, start_cycle;
float duration_us;
float VoToVfb = (R1 + R2) / R2;

uint16_t ccm_val;
/* USER CODE END PD */

ADC_HandleTypeDef hadc1;
DMA_HandleTypeDef hdma_adc1;

TIM_HandleTypeDef htim1;
TIM_HandleTypeDef htim2;

/* USER CODE BEGIN PV */
uint16_t adc_buf[ADC_BUF_LEN];
/* USER CODE END PV */

void SystemClock_Config(void);
static void MX_GPIO_Init(void);
static void MX_DMA_Init(void);
static void MX_TIM1_Init(void);
static void MX_ADC1_Init(void);
static void MX_TIM2_Init(void);
/* USER CODE BEGIN PFP */
void DWT_Init(void);

/* USER CODE END PFP */

/* USER CODE BEGIN 0 */
uint8_t tim2_f;
/* USER CODE END 0 */

/**
  * @brief  The application entry point.
  * @retval int
  */
int main(void)
{
  /* MCU Configuration--------------------------------------------------------*/

  /* Reset of all peripherals, Initializes the Flash interface and the Systick. */
  HAL_Init();

  /* Configure the system clock */
  SystemClock_Config();

  /* Initialize all configured peripherals */
  MX_GPIO_Init();
  MX_DMA_Init();
  MX_TIM1_Init();
  MX_ADC1_Init();
  MX_TIM2_Init();
  /* USER CODE BEGIN 2 */
	HAL_ADC_Start_DMA(&hadc1, (uint32_t*) adc_buf, ADC_BUF_LEN);

	HAL_TIM_PWM_Start(&htim1, TIM_CHANNEL_1);
	HAL_TIM_Base_Start_IT(&htim2);
	DWT_Init();
  /* USER CODE END 2 */

  /* Infinite loop */
  /* USER CODE BEGIN WHILE */
	while (1) {
    /* USER CODE END WHILE */

    /* USER CODE BEGIN 3 */

	}
  /* USER CODE END 3 */
}

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
/* USER CODE BEGIN 4 */
void HAL_TIM_PeriodElapsedCallback(TIM_HandleTypeDef *htim) {
	if (htim->Instance == TIM2) {

		//		Start counting the cycles
		start_cycle = DWT->CYCCNT;

		measuredVoltageCh1 = adc_buf[0];
		measuredVoltageCh1 = adc_buf[1];
		differentialVoltage = measuredVoltageCh1 - measuredVoltageCh2;

		normalizedVoltage = differentialVoltage * VoToVfb;

		ccm_val = __HAL_TIM_GET_COMPARE(&htim1, TIM_CHANNEL_1);
		if (normalizedVoltage < DESIRED_VOLTAGE) {
			ccm_val += 1;

		} else {
			ccm_val -= 1;
		}
		__HAL_TIM_SET_COMPARE(&htim1, TIM_CHANNEL_1, ccm_val);
		//		End counting the cycles and get the final number of cycles
		end_cycle = DWT->CYCCNT;
		duration_cycles = end_cycle - start_cycle;
		duration_us = (float) duration_cycles / SystemCoreClock * 1e6;
	}

}
void DWT_Init(void) {
	CoreDebug->DEMCR |= CoreDebug_DEMCR_TRCENA_Msk;
	DWT->CYCCNT = 0;
	DWT->CTRL |= DWT_CTRL_CYCCNTENA_Msk;
}

uint8_t data_ready_f;
//void HAL_ADC_ConvCpltCallback(ADC_HandleTypeDef *hadc) {
//	data_ready_f = 1;
//}
/* USER CODE END 4 */
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
